spaghetti-computer/lasagna/README.md

# LASAGNA2354 (ラザニア2354)

> Project renamed from **NESPICO** to **ラザニア2354 / LASAGNA2354** (2026-10-13, working tree only). The Python package `nespico/`, the CLI, the GitHub repo name, firmware target names and older (Rev.A/B/bring-up) KiCad file names keep `nespico` / `NESPICO` for now, because renaming them would break imports, CI and existing artifacts.

A low-cost USB Famicom cartridge reader and **live-cartridge console** experiment.

The cartridge is not just a source for a ROM dump: the eventual console should drive the inserted physical cartridge's CPU and PPU buses while running the NES CPU/PPU/APU on an RP2350. The host PC or Mac handles display, audio playback, and controls.

## Project overview

```text
Physical Famicom 60-pin cartridge
               |
     74-series bus interface
     (latches / transceivers)
               |
      Raspberry Pi Pico 2 + PIO
               |
           USB Full Speed
               |
           PC / Mac host
   video, audio, controls, dumps
```

**Target hardware:** standard non-wireless Raspberry Pi Pico 2 (RP2350), 74-series logic, a real 60-pin cartridge connector and USB. The Pico 2 exposes 26 header GPIOs (GP0–GP22, GP26–GP28). For this design, GP26–GP28 are reserved for ADC0–ADC2 analog inputs; GP29 is ADC3 used by the board's VSYS monitor and is not a header GPIO. This leaves **23 digital GPIOs (GP0–GP22)**, so the earlier 27-GPIO concept must move at least four functions into external logic or be redesigned. No FPGA, HDMI shield or wireless module is planned. GPIO allocation and electrical protection are not finalized; see the [board architecture proposal](hardware/kicad/board-plan.md).

## Goals

1. **Play real cartridges.** Read PRG and CHR from the inserted cartridge during execution, support cartridge-side bank switching, CHR-RAM and mapper-generated IRQs instead of silently substituting a fully dumped ROM.
2. **Dump cartridges.** Read PRG-ROM and CHR-ROM to a host computer over USB, verify dumps, and support applicable mapper-controlled banks and cartridge save RAM.
3. **Reproduce physical-console behavior.** Keep motherboard RAM across RESET and cartridge replacement with power retained. Test tricks such as **Tennis → Super Mario Bros. World 9**. This is **not** a request for automatic hot-swap detection or live game switching; cartridge removal with power applied also needs electrical safety validation.
4. **Use the computer as the display.** Stream enough video/audio information over USB for a small PC/Mac viewer, and receive controller input from the host. USB Full Speed means raw full-frame 60fps video is not a feasible default protocol.
5. **Keep the hardware inexpensive and buildable in a quantity of two.** Prefer off-the-shelf Pico 2 boards, inexpensive standard logic and hand-assembled connectors to a custom MCU/FPGA board.

## Development approach

**Simulation first, hardware second.** The host-side simulator models approximate NTSC CPU/PPU bus demand, nominal 74-series/PIO transaction latency, overlapping requests, simplified MMC3 A12 qualification, RESET RAM retention and USB bandwidth assumptions. GitHub Actions runs the tests without any connected hardware.

The simulation is a *screening tool*, not proof that physical timing works. It does not execute actual PIO, emulate a complete 6502/PPU, validate the cartridge voltage interface, or establish real USB throughput. PPU events use classified 2-dot fetch slots from the documented rendering schedule, but do not include generated PPU addresses or rendering-state changes.

### Current status

- Host-side deterministic bus-timing simulator and 39 regression tests are present, including exhaustive five-step checks of the abstract shared-bus guard and PPU fetch-slot phase checks. The local suite and Pico SDK 2.3.1 firmware builds pass; invalid test GPIO maps are rejected before compilation. Both GitHub Actions workflows passed for commit `8f26041` on `work/rp2350-pio-bringup`.
- Firmware CI checks PIO instruction order, sample strobe side-set, loop width, and agreement between the calculated 99 instruction clocks and C constants. It builds a second test map using Pico 2 header GPIOs GP20–GP22 and GP26–GP28, and rejects duplicate, malformed, out-of-range, leading-zero, and board-reserved GPIO assignments. These are source/configuration checks, not hardware execution.
- A one-bit AHCT/LVC level-interface candidate schematic and a 35-case switch-level SPICE screen are now available under `hardware/`; the assumed cartridge release timing is not measured, so this is not electrical sign-off.
- GPIO pin map, 5V interface, physical timing, accurate NES emulator, cartridge swapping and USB video protocol remain to be validated.
- **No claim of working cartridge playback or real-device ROM dumping yet.**

### Local checks

```sh
python -m unittest discover -s tests -v
python -m nespico.cli --scanlines 262
python -m nespico.cli --sys-mhz 20 --settle-ns 160 --scanlines 1 # expected failure
python3 firmware/pio_bringup/validate_pio_source.py
```

## Development records

- [Development log (2026-10-12)](docs/journal/2026-10-12.md)
- [Development roadmap](docs/roadmap.md)
- [Simulation results](docs/benchmark-results.md)
- [PIO bring-up checkpoint](docs/pio-bringup.md)
- [Preliminary one-bit KiCad interface slice](hardware/kicad/README.md) and [Pico 2 board architecture proposal](hardware/kicad/board-plan.md)
- [Bus-turnaround SPICE screening model](hardware/spice/README.md)

## Milestones

1. CI timing simulator + executable design assumptions
2. PIO bus-pattern generator on Pico 2, measured with loopback and a logic analyzer
3. 74-series interface prototype: safe NROM PRG/CHR readback
4. USB dumper with validation and mapper-aware read/write
5. Real-cart CPU+PPU operation, host video/audio and input
6. RAM-preserving RESET, cartridge replacement tests and MMC1/MMC3

See [architecture notes](docs/architecture.md) and [simulation results](docs/benchmark-results.md). The extra pipeline tests model the CPU/PPU work required to prepare addresses; they show that nominal bus-only timing success is not sufficient.

The first Pico SDK / PIO firmware target is a **test-only dual-lane GPIO loopback** under `firmware/pio_bringup/`. It is intentionally not a cartridge bus driver; see its [build and safety instructions](firmware/pio_bringup/README.md). A board-specific pinout and real logic-analyzer measurements are still required before freezing a cartridge interface or releasing PCB files for fabrication.

Reference documentation: [NESdev cartridge connector](https://www.nesdev.org/wiki/Cartridge_connector), [PPU rendering](https://www.nesdev.org/wiki/PPU_rendering), [MMC3](https://www.nesdev.org/wiki/MMC3), [RP2350](https://www.raspberrypi.com/documentation/microcontrollers/silicon.html).
