spaghetti-computer/lasagna/hardware/kicad/revc_lite/README.md

# LASAGNA LITE (WeAct RP2350B), PRE-ROUTE proposal

> **Current configuration (2026-10-17, supersedes everything below).** The Waveshare Core2350B is replaced by the
> **WeAct Studio RP2350B Core Board V1.0** (41.148 x 41.402 mm, two 2x15 2.54 mm headers, rows 38.10 mm apart, own USB-C
> with CC resistors + TVS, BOOT/RST buttons, 16 MB flash). Board stays **100 x 67 mm**. Sections after this one are history
> (Waveshare era) and are kept for reference only. Regenerate with:
>
> `cd ../revc && LASAGNA_LITE=1 python3 gen_sch.py && LASAGNA_LITE=1 python3 gen_pcb.py && LASAGNA_LITE=1 python3 export_fab.py`

## Module (verified against WeActStudio.RP2350BCoreBoard HDK: RP2350B_SCH.pdf H1/H2, RP2350B_PINOUT.png, dimension drawing)
- Footprint `NESPICO_RevC:WeAct_RP2350B_CoreBoard` (generated by `gen_pcb.py` from `design.weact_pins()`): pad 1xx = H1 pin xx, 2xx = H2 pin xx.
  Origin = module centre, +y = USB-C edge. Pin 1/2 row 1.778 mm from the USB edge, far edge 4.064 mm past pin 29/30, rows 38.10 mm (outer) / 33.02 mm (inner) apart.
  The community footprints (fp_leomanes, fp_bwally0) were only used as a cross-check (leomanes agrees within 0.1 mm; bwally0 uses a different pad numbering).
- Placement: module centre (50.00, 46.30), x 29.43-70.57, y 25.60-67.00, **USB-C flush with the front edge**. H2 (GP25-47) on the left, H1 (GP0-24) on the right (top view).
- **H1:** 1 VBUS (raw USB), 2 +5V (after the module diode U2), 3/4 GND, 5 VREF, pin k = GP(k-6) for k = 6..30. Odd = outer row.
- **H2:** 1/2/4 GND, 3 3V3_EN, 5/6 3V3, 7 GP47, 8 RUN, 9 GP45, 10 GP46, 11 GP43, 12 GP44, ... 29 GP25, 30 GP26. Even = outer row.
- **Power:** +5V_LOGIC = **H1-1 VBUS** -> F1 PTC (JP2 bypass, open) -> VBUS_F -> JP1 bridged (D2 SS34 DNP) -> +5V_LOGIC.
  **H1-2 is NOT used**: the module diode drop could take the AHCT supply below 4.5 V. +3V3 = module LDO on H2-5/6.
  Not connected: H1-2 +5V, H1-5 VREF, H2-3 3V3_EN, H2-8 RUN.
- **Module handling (also on the front silk next to the module):**
  - **Lift module R16** (GP23 -> KEY button with a 5.1k pull-up to 3V3). GP23 carries OE#; with R16 fitted a KEY press would enable the AHCT outputs.
  - **Never fit the PSRAM/flash2 footprint U7** on the module bottom (its CS is GP0 = PPU AD0, through R14 0R with R13 10k to 3V3).
  - GP25 (CPU AD0, MCU side of RN1) drives the module LED through 5.1k: harmless (about 0.3 mA), the LED blinks with bus activity.
  - Newer WeAct lots ship RP2350B0**A4** (E9 fixed); R41 (5.1k CIRAM_A10 pull-down) stays fitted anyway (harmless on A4, required on A2).
- Solder the module on the supplied 2x15 male headers (do not fit pins pointing down on its 1x4 SWD header). Only bare THT test pads sit under the module.

## GPIO map (firmware swap, approved 2026-10-17)
| GPIO | Net | Function | Header pin |
|---|---|---|---|
| 0-7 | PADM0-7 | PPU AD0-7 (via RN3/RN4 33R) | H1-6..13 |
| 8-13 | GPA8-13 | PPU A8-13 -> U7 (GPA13 also U8) | H1-14..19 |
| 14 | PPU_DEN_N | U5 245 /OE (R32 10k to 3V3) | H1-20 |
| 15 | G_RD | -> U8 -> CART_RD_N | H1-21 |
| 16 | G_WR_N | U5 DIR, U7 -> CART_WR_N | H1-22 |
| 17 | PPU_ALE | U3 573 LE | H1-23 |
| 18 / 19 / 20 | CVBS_B0 / B1 / B2 | CVBS DAC R90 910 / R91 470 / R92 220 (DNP), 3V3-only | H1-24 / 25 / 26 |
| 21 | IRQ_N | cart pin 15 (R39 10k to 3V3), 5V-tolerant pin | H1-27 |
| 22 | CIRAM_CE_N | cart pin 48, 5V-tolerant pin | H1-28 |
| 23 | OUT_OE_N | OE# of all 7 AHCT (R30 10k to 3V3), 3V3-only. Module KEY pin: **lift R16** | H1-29 |
| 24 | CIRAM_A10 | cart pin 18, **R41 5.1k pull-down** (E9), 5V-tolerant pin | H1-30 |
| 25-32 | CADM0-7 | CPU AD0-7 (via RN1/RN2 33R) | H2-29,30,27,28,25,26,23,24 |
| 33-39 | GA8-14 | CPU A8-14 -> U6 | H2-21,22,19,20,17,18,15 |
| 40 | G_RW | U4 DIR, U6 -> CART_RW | H2-16 |
| 41 | G_ROMSEL_N | U7 -> CART_ROMSEL_N | H2-13 |
| 42 | G_M2_N | U4 /OE, U8 -> M2 (R31 10k to 3V3) | H2-14 |
| 43 | CPU_ALE | U2 573 LE | H2-11 |
| 44 / 45 | I2C_SDA / I2C_SCL | U10 MCP23017, J9 Grove (DNP), 4.7k to 3V3 | H2-12 / H2-9 |
| 46 | SPARE_GP46 | audio PWM (R60, DNP), J10 EXP, TP G46 | H2-10 |
| 47 | SPARE_GP47 | J10 EXP, TP G47 | H2-7 |

- **PIO window rule:** the PPU group (GP0-17) sits inside GPIO0-31 and the CPU group (GP25-43) inside GPIO16-47 (tested).
- **GPIO40-47 rule:** these are the ADC pads and are **not 5 V tolerant**. Every net on GPIO40-47 may only reach an AHCT input
  (573 LE/D, 541/540 A/OE, 245 DIR/OE) or a 3.3 V-only part (MCP23017, Grove, EXP header, 3V3 pull-ups). Never a 245 A/B pin, the cart slot,
  or a pull-up to +5V. `tests/test_lite.py::test_gpio40_47_only_drive_ahct_inputs_or_3v3_parts` enforces it with **zero exceptions**.
  R63 (GPIO46 -> cart pin 45) was deleted 2026-10-17; cart pin 45 (audio from 2A03) is NC again, pin 31 NC (pin 30 = +5V).
  R62 (cart pin 46 -> audio filter, DNP) stays: it only feeds the RC node, never a GPIO directly.
- Firmware order unchanged: set 245 DIR (G_RW / G_WR_N) and the bus levels, then pull the 245 /OE (G_M2_N / PPU_DEN_N) and OE# (GPIO23) low;
  release OE before changing DIR.
- **Lite pin swaps (firmware-invisible):** U2/U3 573 latches carry bit 7-j on D/Q pair j, and each RN 33R array carries bit b0+3-e on element e,
  so the module -> RN -> 573/245 -> slot buses run without crossings.

## Parts changed vs the Waveshare Lite
- **Removed:** J1 Akizuki USB-C breakout, R5/R6 CC 5.1k, U12 USBLC6-2SC6 (the module has USB-C, CC and TVS), SW1/SW2 (module has BOOT/RST),
  TP SWC/SWD/BT/RUN, the "DO NOT USE MODULE FPC" silk. The 22nd TP is GND again.
- **Changed:** U1 = WeAct RP2350B (60 pins, new symbol/footprint, courtyard 41.65 x 41.65 mm, silk on 3 sides, fab marks for the RP2350B, PSRAM U7, SWD 1x4 and USB-C shell legs).
  F1 now fed from H1-1 VBUS. GPIO map as above. R41 moved with CIRAM_A10 (GP24).
- **Kept:** F1 PTC (fitted) + JP2 (open), D2 SS34 DNP + JP1 bridged, R30/R31/R32/R39 pull-ups to 3V3, R41 5.1k fitted, all DNP options
  (MCP23017 + J4/J5, Grove J9 Seeed order, CVBS + J6, audio chain + J11, J10 EXP).

## Placement (mm, board origin top-left, y down; all key parts locked)
| Part | Position | Note |
|---|---|---|
| J3 cart slot | pin 1 (13.17, 7.80) | top edge, CPU pins left, PPU right |
| Row A, y = 18.0, 13 mm pitch | U6 11.0 (90), U2 24.0 (90), U4 37.0 (270), U8 50.0 (90), U7 63.0 (90), U3 76.0 (90), U5 89.0 (270) | inputs face the module, outputs face the slot (245 A side up) |
| 100 nF | C14 (8.08,12.54) C10 (21.08,12.54) C12 (39.93,23.46) C16 (47.07,12.54) C15 (60.07,12.54) C11 (73.07,12.54) C13 (91.93,23.46) | 2.6 mm from each VCC pin 20 |
| Pull-ups in row-A gaps | R31 (42.3,18) R30 (44.7,18) R39 (55.3,18) R41 (57.7,18) R32 (69.5,18) | on G_M2_N / OE# / IRQ / A10 / DEN |
| U1 WeAct | centre (50.00, 46.30) | USB-C flush with y = 67 |
| RN1 / RN2 | (26.4, 31.0) / (26.4, 36.0), 180 deg | left of H2 GP25-32 |
| RN3 / RN4 | (73.6, 57.1) / (73.6, 52.5), 0 deg | right of H1 GP0-7 |
| F1 / JP2 / D2 / JP1 / C1 | (74.6,64.8) / (74.6,61.6) / (80.6,64.8) / (80.6,61.6) / (86.0,64.8) | next to H1-1 VBUS, two aligned columns + C1 on the same row |
| TP1-22 | 3 rows (y 27.0 / 30.9 / 34.8) x 8, 3.2 mm pitch, centred x = 48.5 | bare THT pads under the module's far end, labels on B.Silk |
| CVBS / audio passives | R90/R91/R92 (80.4/82.0/84.0, 35.0); R60/C60/C61 (same x, 45.0); R61/R62 (80.4/82.0, 50.0) | one column grid per RCA |
| Options | J6 (93.1,33) J11 (93.1,49) right edge; J9 (6,52) U10 (16.6,51.4) J10 (24.6,46.4) J12 RST (24.6,40.0) J5 (11.9,60.9) J4 (11.9,64.8) left | all DNP |

Routing intent for Quilter: CPU signals leave H2 to the left (CAD via RN1/RN2 straight up to U2/U4, GA8-14/G_RW left then up to U6);
G_ROMSEL_N / G_M2_N / CPU_ALE and the PPU A8-13 / WR / RD lines may use the lanes under the module beside the TP block; PAD via RN3/RN4 up the
right side to U3/U5; IRQ/CIRAM lines from the top of H1 straight up to the slot centre. Nothing but flat test pads sits under the module.

## Cost change vs the Waveshare Lite (estimate, 1 USD = 150 JPY)
- Module: WeAct RP2350B about $4.2 + shipping (AliExpress; includes 2x 30-pin and SWD headers) vs Core2350B ¥1,463 (Switch Science kit) / $4.9-7.99: about -¥0 to -¥800.
- Removed: Akizuki J1 breakout -¥180, U12 USBLC6 MOQ 10 -¥72, Akizuki 1x40 header strips -¥70 (headers come with the module). R5/R6 were the same 5.1k line as R41 (no saving).
- **Net: about -¥320 on parts, up to about -¥1,100 including the module.** PCB price unchanged (same 100 x 67 mm, 2 layers).

## Population: Lite build vs Full build
The minimal build is a fully working dump-only Lite: every option footprint may stay empty (tested in `LitePopulationTest`:
no logic-IC pin floats without the options, +5V reaches the logic through F1 + bridged JP1).

| Function | Lite build (fit) | Full build (additionally fit) |
|---|---|---|
| MCU | U1 WeAct RP2350B (R16 lifted, no PSRAM) | same |
| Power | F1 PTC, JP1 bridged, C1, JP2 open | D2 SS34 (then cut JP1) only if back-feed protection wanted |
| Cart bus | J3 slot, U2/U3 573, U4/U5 245, U6/U7 541, U8 540, C10-C16, RN1-RN4 33R | same |
| Pulls | R30, R31, R32, R39 (3V3), R41 5.1k (E9) | same |
| Controller pads | - | U10 MCP23017, C27, R51-R53, R42/R43, J4 PAD1, J5 PAD2 |
| Grove I2C | - | J9 (shares U10's I2C, GP44/45) |
| Video | - | R90-R92 DAC, J6 RCA (GP18-20) |
| Audio | - | R60, C60, C61, R61, J11 RCA (GP46 PWM); R62 to mix cart audio (pin 46) |
| Expansion | - | J10 EXP (3V3, GP46, GP47, GND, 5V) |
| Reset/boot | module RST/BOOT buttons | J12 RST header (RUN to GND) for a case button |
| Test | TP1-22 (bare pads) | same |

Rev.C features without a footprint now: USB-C/CC/ESD, SW1/SW2 buttons and SWD header (all on the module: its USB-C, RST/BOOT
buttons and SWD 1x4), crystal and flash (on the module). Nothing else is missing; J12 was added (DNP) for an external reset.

## Checks (2026-10-17)
- `python3 -m pytest tests`: 81 passed (incl. golden netlist, ERC, GPIO40-47 rule with zero exceptions, PIO windows, population test, H1-2 / 3V3_EN unused, 3V3 pull-ups).
- ERC 0 errors / 0 warnings. DRC with schematic parity: 0 violations, 0 footprint errors, 283 unconnected (unrouted, expected).
- Fitted JLC BOM: 10 lines, 25 SMD placements (U1/J3 and DNP options hand-assembled).

---

# History (Waveshare Core2350B era, superseded)

> **Current configuration (2026-10-13 21:50, supersedes older notes below):** bare Core2350B0 (no kit/FPC adapter needed);
> USB-C = Akizuki 115426 breakout J1 + R5/R6 5.1k; VBUS = +5V_LOGIC = module VBUS = cart 5V (no PTC, no ESD, no cart power switch);
> 33R = RN1-RN4 (C25508); pulls R30 OE#, R31 G_M2_N, R32 PPU_DEN_N, R39 IRQ_N all to **3V3**; R41 **5.1k fitted** (E9: Waveshare photo shows RP2350B0A2).
> VBUS: J1 pin1 (VBUS_IN) -> **D2 SS34** (C8678, Basic) -> +5V_LOGIC; **JP1** normally-open solder jumper 'SHORT=BYPASS D' across D2.
> Board **100 x 67 mm** (DNP option row added). Full-version features are DNP footprints (table at the end). Do **not** connect the module FPC while J1 is used (both feed VBUS). Unplug USB before swapping carts.
> Firmware order: set 245 DIR (G_RW / G_WR_N) and the address/data levels first, then pull the 245 OE (G_M2_N / PPU_DEN_N) and OE# (GPIO43) low;
> release OE before changing DIR. Never drive GPIO39 (CIRAM_CE_N). Sections below are history.

This is the Rev.C cart circuit with the bare RP2354B and its support parts replaced by a **Waveshare Core2350B** module (RP2350B, 16 MB flash, 12 MHz crystal, ME6217 3.3 V/800 mA LDO, 27 Ω USB resistors on the module).
It is generated from `../revc/*.py` with `LASAGNA_LITE=1`; Rev.C itself is not changed:

```
cd ../revc && LASAGNA_LITE=1 python3 gen_sch.py && LASAGNA_LITE=1 python3 gen_pcb.py && LASAGNA_LITE=1 python3 export_fab.py
```

Board: 100 × 62 mm (same as Rev.C), 2 layers, black mask, M3 holes at the corners. It is within JLC's ≤100×100 mm cheapest price tier, so making it smaller would not lower the price.
Assembly is all hand-soldered by default (TSSOP-20, 0603/0805, SOT-23). PCBA is not required.

## Module (verified against the Waveshare sources)
- **Outline:** Core2350B0 wiki size drawing. 25.40 mm square, 64 THT pads on a 10×10 grid at 2.54 mm pitch, two pads deep around the edge (pad grid span 22.86 mm).
- **Pinout:** `Core2350B.pdf`, P1–P4 "Header 8X2".
  - P1 (left): GPIO0–14
  - P3 (bottom): GPIO15–29
  - P4 (right): GPIO30–44
  - P2 (top): 1 GND, 2 GP45, 3 GP47 (through R11 0R), 4 GP46, 5 BOOTSEL, 6 SWD, 7 USBD_N, 8 GND, 9 USBD_P, 10 SWCLK, 11 RUN, 12 ADC_VREF, 13 3V3_EN, 14 GND, 15 VBUS, 16 3V3
  - Footprint pad number = header × 100 + pin.
- **Mounting:** solder the module to male 2.54 mm headers (Akizuki 1×40 strips cut to length), or solder it flat.

## What changed from Rev.C
- **Removed:**
  - U1 and its support: L1, Y1, C5–C9, R1, R2, the C17–C24 / C28–C32 decoupling, R3, R4, R7, R8.
  - U9 NCP1117 and C2. The module LDO supplies +3V3, and the load is well under the LDO's rating (the AHCT logic runs from 5 V).
  - D1 and its 1k (the module LED is enough), the CVBS DAC/RCA, MCP23017/Grove/pad headers, and the J7 SWD header (SWCLK/SWDIO are on the test-point row instead).
- **USB-C:** CC 5.1k ×2, then F1 → +5V_LOGIC → module VBUS (P2-15). D+/D− go straight to P2-9/P2-7, because the 27 Ω resistors are on the module.
- **Kept:** U11 power-down guard, on the module's 3V3.
- **SW1/SW2:** **optional**. A blank flash enumerates as USB BOOTSEL by itself; the module has no buttons of its own.
- **GPIO map unchanged** (same firmware as Rev.C).
  - GPIO39 (module red LED, 470 Ω) is CIRAM_CE_N, an input that the cart drives. The LED loads it by about 7 mA. **Firmware must never drive GPIO39.** **Remove the module's R10 (recommended)**: CIRAM /CE is often PPU /A13 driven by U8 or the cart, and the LED would load it.
  - GPIO40–42/44/45 (unused CVBS/I2C) and **GPIO47 are not connected**, so the B1/B2 variants (with PSRAM) also work. B0 is recommended.
- **Clock:** the module is rated for 150 MHz. The 172 MHz overclock is the same silicon, but it is unverified on the module.

## Cost (1 board, cheapest; 1 USD = 150 JPY)
| Item | Cost | Source |
|---|---|---|
| PCB, 5 boards | $2–4 (¥300–600) | estimate |
| Shipping, PCB + LCSC parts together, cheapest service | $8–15 (¥1,200–2,250) | estimate |
| Parts (LCSC/JLC unit prices incl. LCSC minimum order quantities) | about $11.1 (¥1,670), of which ICs $4.44 | JLC API prices from 2026-10-13 |
| Core2350B module | ¥1,463 (Switch Science B2-Kit) / $4.9 (SpotPear B0, plus shipping) / $7.99 (Waveshare) | fetched |
| Pin headers, 1×40 ×2 (Akizuki 100167) | ¥70 | fetched |
| J3 Hirose slot | ¥0 (already owned) | |
| Consumption tax | ¥0 (personal-import taxable base under ¥10,000) | estimate |
| **Total** | **about ¥4,700–6,300** | |

Optional:
- SW1/SW2 TS-1187A: about ¥15 including MOQ.
- JLC Basic PCBA (16 lines): about +$12 (setup $8, stencil $1.5, parts).

The leftover MOQ parts (5–100 pcs per line) cover 2 or more more boards. With a second module and a second slot, an extra board costs about ¥2,000–3,500.

## Cost-down (2026-10-13, target <= 3000 JPY all-in)
Removed vs the first Lite: USB-C J1 + CC 5.1k R5/R6, PTC F1, RUN/BOOT SW1/SW2 (all on the Core2350B-Kit USB adapter via FFC),
cart supervisor U11 + Q1/Q2/Q3 high-side switch + R44-R47/C4/C25 (cart 5V = USB 5V directly: **insert/remove carts with USB unplugged**),
C3/C26 bulk, cart-side pulls R33-R38/R40/R41/R48/R49. OE# (OUT_OE_N) is driven by GPIO43 directly, R30 10k pull-up to 3V3
(AHCT VIH 2.0 V) keeps all buffers Hi-Z through reset. Remaining: module, J3 (owned), 7 logic ICs, 16x33R, 4x10k, 1x10uF, 7x100nF, 64 header pins.
Cheapest-MOQ IC choice: 74HCT245PW C52140501 and SN74HCT541PWR C436096 (min 1) instead of the min-5 AHCT lines.

## USB-C back on the board (2026-10-13 21:20)
J1 = Akizuki 115426 AE-USB2.0-TYPE-C-5077CR (180 JPY) USB-C DIP breakout on a 1x7 2.54 mm header, mouth flush with the left edge.
Pins (Akizuki schematic): 1 VBUS, 2 D-, 3 D+, 4 GND, 5 CC1, 6 CC2, 7 GND; the breakout has no CC resistors, so R5/R6 5.1k are on the Lite.
VBUS = +5V_LOGIC = module VBUS (P2-15) = cart 5V (no PTC). D-/D+ -> module P2-7/P2-9. Module FPC / kit adapter not needed (bare Core2350B0 OK).
BOOTSEL and RUN are test pads TP "BT" / "RUN" (module P2-5 / P2-11): short to GND with tweezers. Footprint from Akizuki AE-USB2.0-TYPE-C-5077CR_rev1.pdf
(20 x 15 mm, pin1 2.381 mm from edge, row 1.905 mm from rear edge); check the pin-1 side on the real board before soldering.

## 33R arrays + E9 pulls (2026-10-13 21:30)
- R10-R17/R20-R27 (16x 33R 0603) -> RN1-RN4 = UniOhm 4D03WGJ0330T5E, 33R x4 0603 convex (LCSC C25508, Extended, stock ~110k, MOQ 50, $0.013).
  RN1 = CPU AD0-3, RN2 = CPU AD4-7, RN3 = PPU AD0-3, RN4 = PPU AD4-7; pins 1-4 MCU side, 8-5 buffer side.
- **A4 stepping assumed; populate if using A2.** Core2350B ships RP2350 A4 (erratum E9 fixed), so R41 (CIRAM_A10 pull-down, E9-only) is DNP
  (footprint kept, excluded from JLC BOM/CPL). Kept fitted: R30 OE# pull-up to 3V3 (buffers Hi-Z through reset), R31/R32 (U4/U5 245 disabled at reset),
  R39 IRQ_N pull-up (cart IRQ is open-drain).

## Polish pass before Quilter (2026-10-13 21:45)
- Board 100 x 60 mm (was 100 x 62): width is set by the 84.8 mm CR22A slot body + M3 corners; module 0.5 mm up, TP row 55.2 mm.
- No fiducials (hand-built). Black mask / white silk, R3 rounded corners, 4x M3 plated holes, slot centred on the top edge.
- J1 USB-C breakout on the left edge (mouth flush), R5/R6 CC 5.1k right behind CC1/CC2, C1 10uF next to VBUS.
- RN1/RN2 (CPU AD) and RN3/RN4 (PPU AD) in one row between the 245s and the module; 100nF next to each IC VCC pin (row A).
- Pulls in a 3 mm-pitch row beside the module (R30/R31/R41 left, R32/R39 right). Front "CORE2350B" label removed (quiet silk); all text >= 1.0 mm.
- 24 THT test points evenly on the back front edge, 3.5 mm pitch, back labels (incl. BT/RUN for BOOTSEL/RESET).

## VBUS series Schottky D2 + bypass JP1 (2026-10-13 22:00)
- D2 = MDD SS34 (LCSC C8678, JLC Basic, SMA, $0.035, MOQ 20 = $0.70, about 105 JPY). A = VBUS_IN (J1 pin 1), K = +5V_LOGIC.
- JP1 = 2-pad solder jumper, open by default; short it to bypass D2 (production may fit a 0R/jumper instead).
- Drop: SS34 VF is typically ~0.3 V at 0.1-0.2 A (datasheet max 0.5 V at 3 A). Load = module (~30 mA) + 7 AHCT (quiescent) + cart (50-150 mA), ~0.2 A max.
  - Host 5.0 V: rail ~4.7 V. AHCT VCC 4.5-5.5 V OK; ME6217 3.3 V LDO (dropout ~0.1 V at 0.1 A) OK.
  - Host at the USB minimum 4.75 V (or a long cable): rail ~4.4 V, **below AHCT 4.5 V**. Short JP1 if the 5V TP reads < 4.5 V.
- Protects: 5 V on +5V_LOGIC (e.g. module FPC/adapter VBUS, which is the same net as module VBUS) cannot backfeed the J1 host.
  It does NOT stop J1 from feeding the FPC side; that would need a second diode on the module's FPC VBUS, which is on the module. So still: do not use the FPC.

## Full-version features as DNP footprints (2026-10-14 03:40)
Fitted BOM unchanged (DNP parts are excluded from the JLC BOM/CPL; BOM_FULL lists them as "(DNP)"). Board 100 x 60 -> **100 x 67 mm** for the front option row.

| Feature | Parts to add | Enables |
|---|---|---|
| Controller pads | U10 MCP23017-E/SS, C27 100nF, R51 10k (RST), R52/R53 4.7k (I2C), R42/R43 10k, J4/J5 1x7 headers | 2 pads via I2C 0x20 (GPA0 CLK, GPA1 LATCH, GPA2/3 data), 3.3 V |
| Grove I2C | J9 HY2.0-4P (+ R52/R53 if U10 not fitted), left edge under J1 | 3.3 V I2C on GPIO44 SDA / GPIO45 SCL. **Seeed pin order: 1 SCL, 2 SDA, 3 VCC (3V3), 4 GND** (silk SCL/SDA/3V3/GND) |
| CVBS video | R90 910, R91 470, R92 220, J6 RCA MJ-526-Y (Akizuki 112477) | 3-bit composite out from GPIO40-42 |
| Audio out | R60 1k (C21190), C60 10nF (C57112), C61 10uF 0805 (C15850), R61 10k (C25804), J11 RCA MJ-526-Y (Akizuki 112477); optional cart mix: R62 1k (C21190), R63 10k (C25804) | PWM audio on GPIO46 (RC low-pass 15.9 kHz, DC-blocked, 10k bleed) to J11 "AUDIO". R62 mixes cart pin 46 (audio from cart), R63 feeds GPIO46 PWM to cart pin 45 (audio into cart) for expansion-audio carts |
| RUN / BOOTSEL buttons | SW1, SW2 TS-1187A | reset / USB boot without tweezers on TP RUN/BT |
| PTC on VBUS | **FITTED** F1 TECHFUSE SMD0805-050 (C66452); JP2 open = optional bypass | over-current fuse (hold 0.5 A / trip 1 A) |
| USB ESD | **FITTED** U12 UMW USBLC6-2SC6 (C2687116; no Basic USBLC6 exists) | D+/D- ESD clamp |
| Expansion | J10 1x5 header: 3V3, GPIO46, GPIO47, GND, 5V | 2 spare GPIO (GPIO47 only on B0: PSRAM CS on B1/B2). 3.3 V ADC pins, not 5 V tolerant |

GPIO map (module): 0-7 CPU AD, 8-14 CPU A8-14, 15 R/W, 16 /ROMSEL, 17 /M2 (245 OE), 18 CPU ALE, 19-26 PPU AD, 27-32 PPU A8-13,
33 PPU DEN, 34 /RD, 35 /WR, 36 PPU ALE, 37 IRQ, 38 CIRAM A10, 39 CIRAM /CE (module LED!), 40-42 CVBS DAC, 43 OE#, 44 SDA, 45 SCL, 46/47 spare (J10, TP G46/G47).
VBUS chain: J1 -> [F1 PTC || JP2 open] -> VBUS_F -> [JP1 bridged (default) || D2 SS34 DNP] -> +5V_LOGIC.

## F1 PTC + U12 ESD fitted (2026-10-14 07:30)
F1 C66452 (MOQ 10, $0.37 = 55 JPY) + U12 C2687116 (MOQ 10, $0.48 = 72 JPY): **+127 JPY**. JP2 is now normally open (short = bypass F1).
Drop: F1 150 mOhm min x 0.2 A = 0.03 V (up to ~0.17 V near the 850 mOhm max) + D2 ~0.3 V: rail ~4.55-4.7 V from a 5.0 V port.
If the 5V TP reads < 4.5 V, short JP1 (D2 bypass) first.

## D2 DNP, JP1 bridged (2026-10-14 07:35)
VBUS is direct through F1 only: drop = F1 0.03-0.17 V at 0.2 A, so **~4.6 V or more at a 4.75 V USB port** (~4.85 V at 5.0 V); AHCT 4.5-5.5 V OK.
No FPC-backfeed protection by default: front silk "DO NOT USE MODULE FPC" (vertical, right of the module, from the FPC/P2 top side). If you want it, fit D2 (SS34, C8678) **and cut JP1**
(then the rail drops ~0.3 V more). Fitted-BOM delta: -105 JPY (SS34 MOQ 20 no longer bought).

## R41 fitted for RP2350-E9 (2026-10-14 07:40)
Waveshare's Core2350B0 size drawing photo shows the chip marked **RP2350B0A2**, so E9 must be assumed.
Datasheet D.5.1 RP2350-E9 (Affects RP2350 A2): "Driving / pulling the pad input low with a low impedance source of 8.2 kOhm or less will
overcome the erroneous leakage ... The pad pull-up still works." -> R41 = **5.1k** pull-down on CIRAM_A10 (GPIO38), same part as R5/R6 (C23186): cost 0.
Driver: cart pin 18 (CIRAM A10 = PPU A10/A11 via cart wiring from our U7/U3 AHCT outputs, or the mapper output): 5 V / 5.1k = ~1 mA, well within AHCT 8 mA.
Other pulls are pull-ups (unaffected by E9); no other GPIO input relies on a pull-down. Firmware: never rely on internal pull-downs.

## Option row centred + rename (2026-10-14 08:10)
Product name on silk / title block / schematic: **LASAGNA LITE** (file names stay LASAGNA2354_Lite.* for tooling). MADE IN KOBE kept.
Front option row at y=58.5, symmetric about x=50 on the 2.54 grid, 2.0 mm courtyard gaps:
J4 PAD1 pin1 x=14.44 (pins 14.44-29.68), SW1 RUN x=37.30, J10 EXP pins 44.92-55.08, SW2 BOOT x=62.70, J5 PAD2 pin1 x=70.32 (pins 70.32-85.56).

## Grove Seeed order + DNP audio out (2026-10-14 09:00)
- **J9 Grove** now follows the Seeed standard: 1 SCL (GPIO45), 2 SDA (GPIO44), 3 VCC 3V3, 4 GND (was 1 GND, 2 VCC, 3 SDA, 4 SCL). Moved to the left edge under J1 at (6.5, 52.0, 270), mouth flush, pin names on silk. F1/JP2 moved to (22.1, 47.2)/(22.1, 50.6) to make room.
- **Audio (all DNP, board works unpopulated):** GPIO46 -> R60 1k -> AUD_F -> C60 10nF to GND (fc = 1/(2*pi*1k*10nF) = 15.9 kHz) -> C61 10uF -> AUD_OUT -> J11 RCA, R61 10k bleed to GND.
  GPIO46 also stays on J10 pin 2 and TP G46. GPIO47 is not used (PSRAM CS on B1/B2).
- **Cart expansion audio** (NESdev cartridge connector, 60-pin Famicom): pin 45 = "Audio from 2A03" (console -> cart), pin 46 = "Audio to RF" (cart -> console).
  R63 10k: GPIO46 -> cart pin 45 (limits any 5 V backdrive to < 0.2 mA); R62 1k: cart pin 46 -> AUD_F (mixes cart audio into the filter node). Fit both to hear expansion audio (VRC6/N163/FDS-style carts); most carts simply tie 45 to 46.
- Placement: J11 at (93.1, 46.6, 90) stacked under J6 on the right edge, labelled AUDIO (J6 now labelled VIDEO). One 2.0 mm-pitch passive row at y=36 between the RN row and U10:
  R60 66.5, C60 68.5, C61 71.0, R61 73.5, R62 75.5, R63 77.5 | R90 80.0, R91 82.0, R92 84.0 (DAC moved up from y=40.5). U10 x 80 -> 79.
- Bottom option row (y=58.5) and the 100 x 67 mm outline are unchanged. Fitted JLC BOM unchanged (only F1's CPL position moved).
