spaghetti-computer/lasagna/hardware/kicad/revc/fab/LASAGNA2354_RevC_BOM_JLCPCB_PRE-ROUTE.csv

Comment | Designator | Footprint | LCSC Part #
10uF | C1,C2,C3 | C_0805_2012Metric | C15850
100nF | C10,C11,C12,C13,C14,C15,C16,C17,C18,C19,C20,C21,C22,C23,C24,C25,C26,C27,C28,C31,C32,C4 | C_0603_1608Metric | C14663
100nF | C29 | RPi_C_1005_wide | C1525
4.7uF | C30,C5,C6,C7 | RPi_C_1005_wide | C23733
15pF | C8,C9 | RPi_C_1005_wide | C1548
CART_ON | D1 | LED_0603_1608Metric | C2286
500mA_PTC | F1 | Fuse_1206_3216Metric | C46641012
USB-C | J1 | USB_C_Receptacle_HRO_TYPE-C-31-M-12 | C165948
HY2.0-4P | J9 | JST_PH_S4B-PH-SM4-TB_1x04-1MP_P2.00mm_Horizontal | C722729
AO3401A | Q1 | SOT-23 | C15127
2N7002 | Q2,Q3 | SOT-23 | C8545
33 | R1 | RPi_R_1005 | C25105
33 | R10,R11,R12,R13,R14,R15,R16,R17,R20,R21,R22,R23,R24,R25,R26,R27 | R_0603_1608Metric | C23140
1k | R2 | RPi_R_1005 | C11702
10k | R3,R30,R31,R32,R33,R34,R35,R36,R37,R38,R39,R40,R41,R42,R43,R44,R45,R48,R49,R51 | R_0603_1608Metric | C25804
1k | R4,R46,R47,R50 | R_0603_1608Metric | C21190
5.1k | R5,R6 | R_0603_1608Metric | C23186
4.7k | R52,R53 | R_0603_1608Metric | C23162
27 | R7,R8 | RPi_R_1005 | C25100
910 | R90 | R_0603_1608Metric | C23264
470 | R91 | R_0603_1608Metric | C23179
220 | R92 | R_0603_1608Metric | C22962
RUN | SW1 | SW_Push_1P1T_XKB_TS-1187A | C318884
BOOTSEL | SW2 | SW_Push_1P1T_XKB_TS-1187A | C318884
RP2354B | U1 | QFN-80-1EP_10x10mm_P0.4mm_EP3.4x3.4mm | C39843328
MCP23017-E/SS | U10 | SSOP-28_5.3x10.2mm_P0.65mm | C506653
XC61CN3002MR-G | U11 | SOT-23 | C2456348
SN74AHCT573PWR | U2,U3 | TSSOP-20_4.4x6.5mm_P0.65mm | C141311
74AHCT245PW | U4,U5 | TSSOP-20_4.4x6.5mm_P0.65mm | C173388
74AHCT541PW | U6,U7 | TSSOP-20_4.4x6.5mm_P0.65mm | C84548
SN74AHCT540PWR | U8 | TSSOP-20_4.4x6.5mm_P0.65mm | C7626
NCP1117ST33T3G | U9 | SOT-223-3_TabPin2 | C26537
12MHz | Y1 | RPi_XTAL_3225-4 | C20625731
