spaghetti-computer/lasagna/hardware/kicad/revc_lite/fab/LASAGNA2354_Lite_BOM_FULL.csv

Qty | Value | Designator | Footprint | LCSC | MPN
1 | WeAct RP2350B | U1 | WeAct_RP2350B_CoreBoard |  | WeAct RP2350B Core Board V1.0
1 | Famicom_60pin_slot | J3 | Hirose_CR22A-60D-2.54DS |  | CR22A-60D-2.54DS(70)
2 | SN74AHCT573PWR | U2,U3 | TSSOP-20_4.4x6.5mm_P0.65mm | C141311 | SN74AHCT573PWR
2 | 74AHCT245PW | U4,U5 | TSSOP-20_4.4x6.5mm_P0.65mm | C173388 | 74AHCT245PW,118
2 | 74AHCT541PW | U6,U7 | TSSOP-20_4.4x6.5mm_P0.65mm | C84548 | 74AHCT541PW,118
1 | SN74AHCT540PWR | U8 | TSSOP-20_4.4x6.5mm_P0.65mm | C7626 | SN74AHCT540PWR
4 | 10k | R30,R31,R32,R39 | R_0603_1608Metric | C25804 | 10k
4 | 10k (DNP) | R42,R43,R51,R61 | R_0603_1608Metric | C25804 | 10k
1 | PTC 0805 500mA | F1 | Fuse_0805_2012Metric | C66452 | SMD0805-050
1 | 10uF | C1 | C_0805_2012Metric | C15850 | 10uF
1 | 910 (DNP) | R90 | R_0603_1608Metric | C23264 | 910
1 | 470 (DNP) | R91 | R_0603_1608Metric | C23179 | 470
1 | 220 (DNP) | R92 | R_0603_1608Metric | C22962 | 220
1 | RCA_CVBS (DNP) | J6 | RCA_Avvicon_MJ-526 |  | MJ-526-Y
1 | PAD_J4 (DNP) | J4 | PinHeader_1x07_P2.54mm_Vertical
1 | PAD_J5 (DNP) | J5 | PinHeader_1x07_P2.54mm_Vertical
1 | MCP23017-E/SS (DNP) | U10 | SSOP-28_5.3x10.2mm_P0.65mm | C506653 | MCP23017-E/SS
2 | 4.7k (DNP) | R52,R53 | R_0603_1608Metric | C23162 | 4.7k
1 | HY2.0-4P (DNP) | J9 | JST_PH_S4B-PH-SM4-TB_1x04-1MP_P2.00mm_Horizontal | C722729 | HY2.0-4P-WT
7 | 100nF | C10,C11,C12,C13,C14,C15,C16 | C_0603_1608Metric | C14663 | 100nF
1 | 100nF (DNP) | C27 | C_0603_1608Metric | C14663 | 100nF
1 | SS34 (DNP) | D2 | D_SMA | C8678 | SS34
1 | CUT=USE D | JP1 | SolderJumper-2_P1.3mm_Bridged_RoundedPad1.0x1.5mm
1 | SHORT=BYPASS F | JP2 | SolderJumper-2_P1.3mm_Open_RoundedPad1.0x1.5mm
1 | EXP (DNP) | J10 | PinHeader_1x05_P2.54mm_Vertical
1 | RST (DNP) | J12 | PinHeader_1x02_P2.54mm_Vertical
2 | 1k (DNP) | R60,R62 | R_0603_1608Metric | C21190 | 1k
1 | 10nF (DNP) | C60 | C_0603_1608Metric | C57112 | 10nF
1 | 10uF (DNP) | C61 | C_0805_2012Metric | C15850 | 10uF
1 | RCA_AUDIO (DNP) | J11 | RCA_Avvicon_MJ-526 |  | MJ-526-Y
4 | 33x4 | RN1,RN2,RN3,RN4 | R_Array_Convex_4x0603 | C25508 | 4D03WGJ0330T5E
1 | 5.1k | R41 | R_0603_1608Metric | C23186 | 5.1k
