spaghetti-computer/lasagna/hardware/kicad/revb/fab/NESPICO_RevB_schematic.pdf

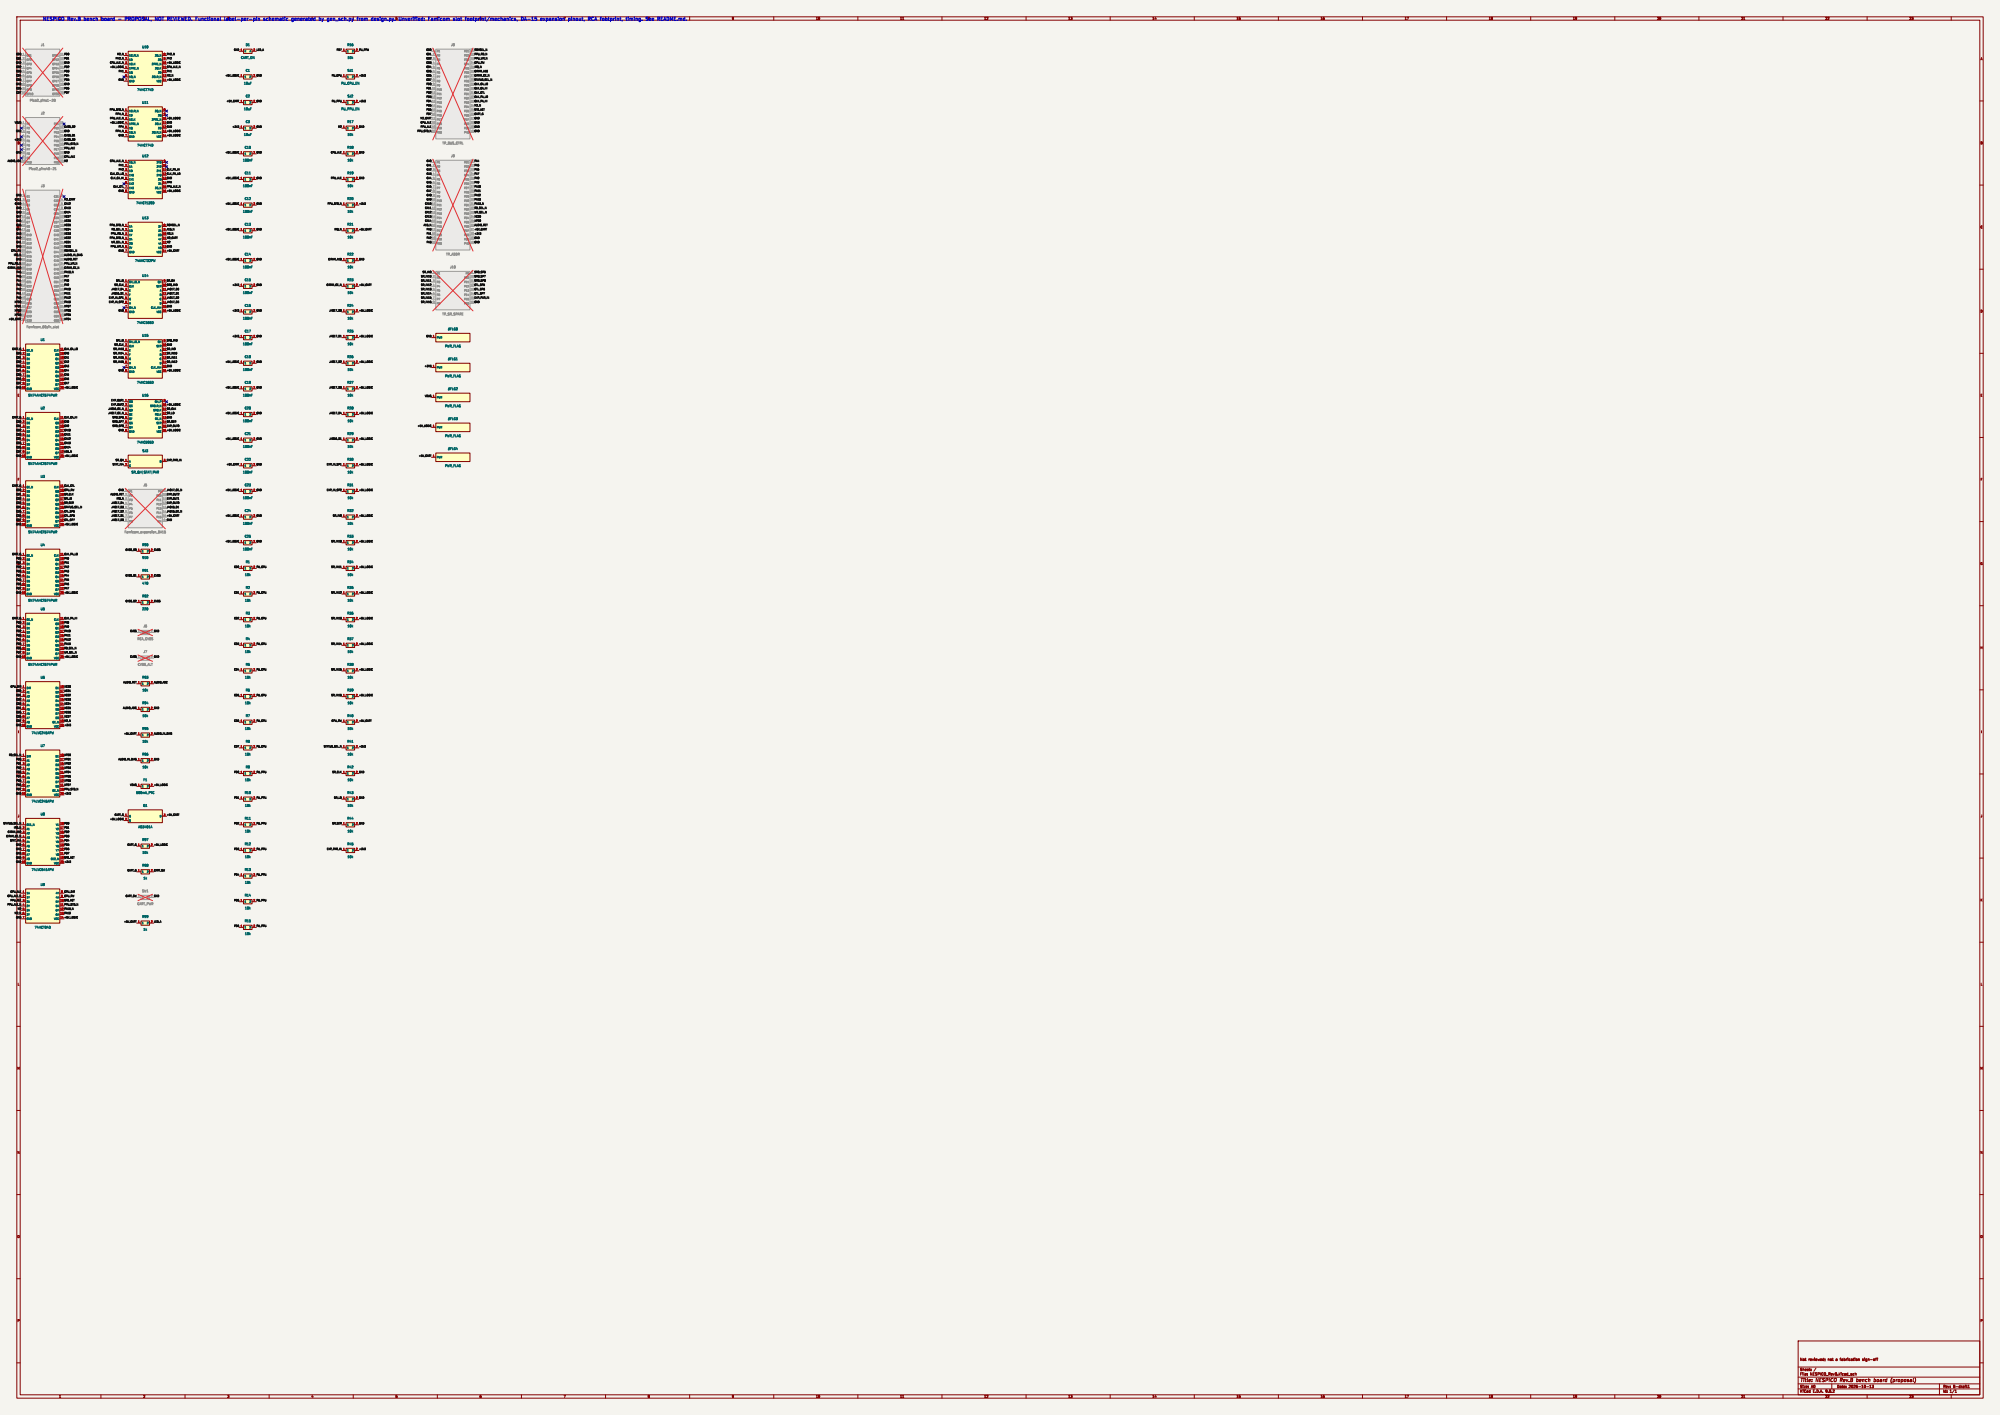
[picture p1: page 1]
