spaghetti-computer/lasagna/hardware/kicad/revc/LASAGNA2354_RevC.kicad_pcb

## KiCad design hardware/kicad/revc/LASAGNA2354_RevC.kicad_pcb (2026-11-04)

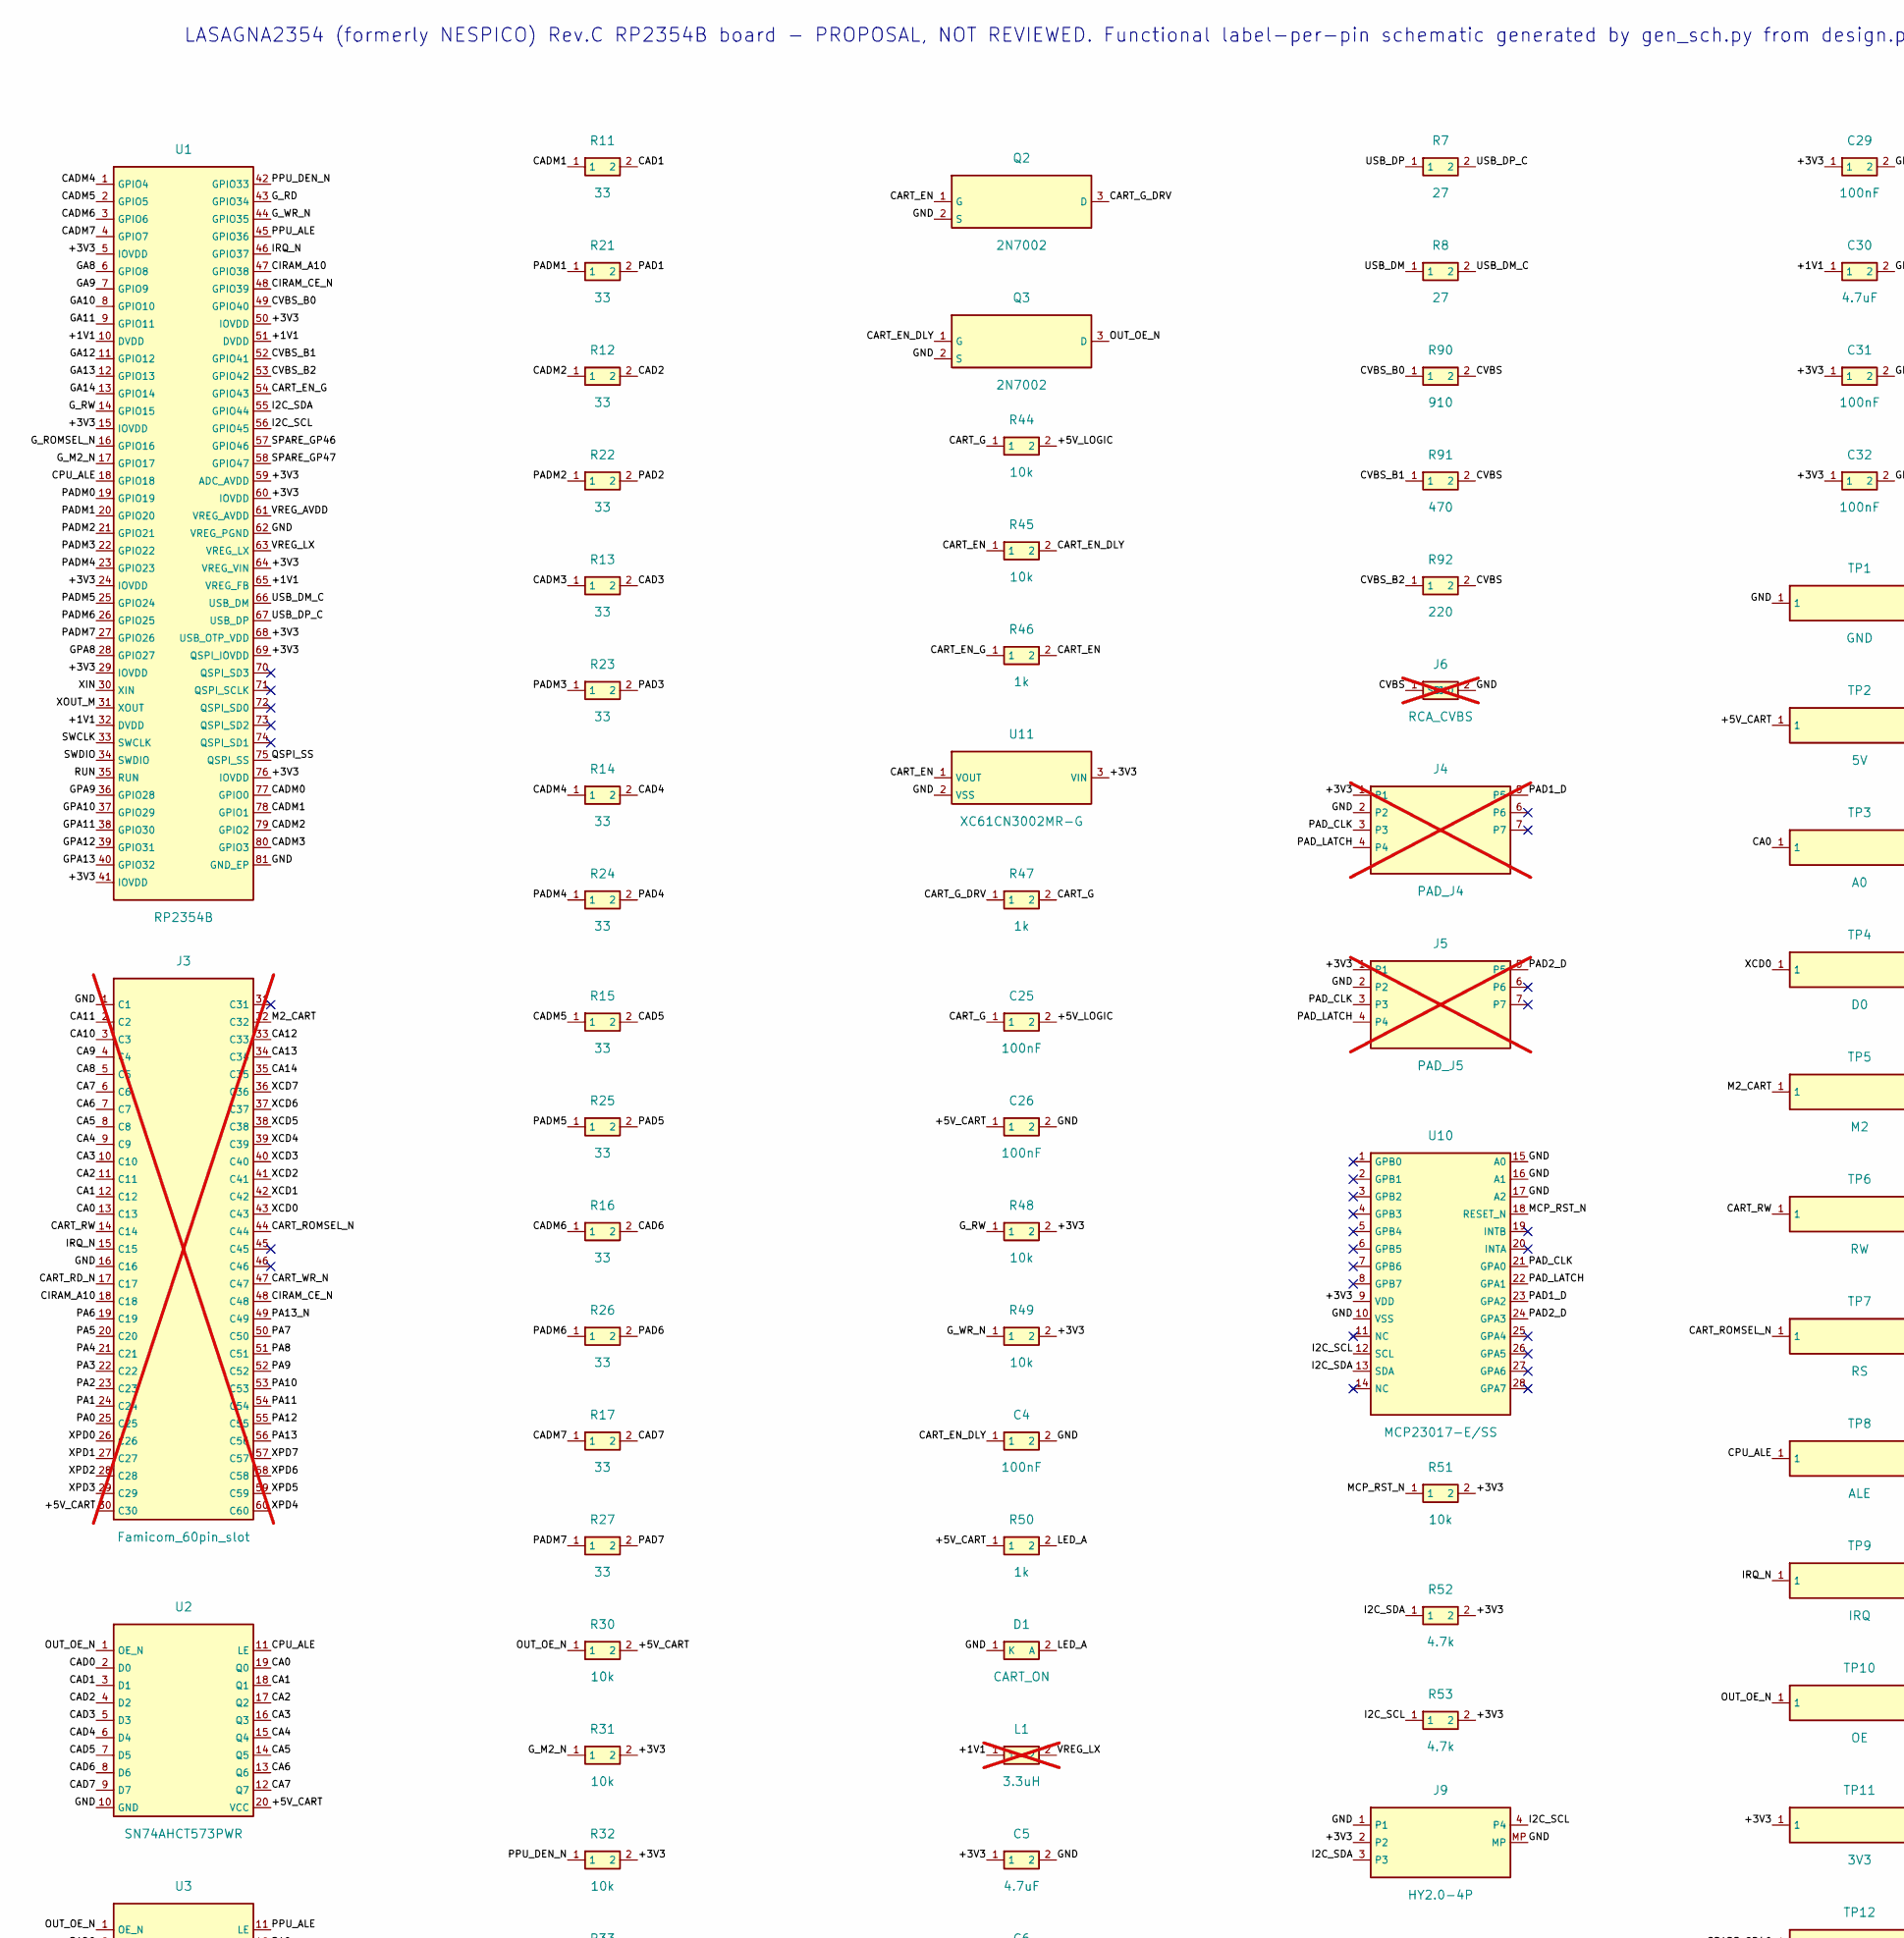
[picture p2: schematic LASAGNA2354_RevC.kicad_sch, LASAGNA2354 Rev.C RP2354B board (proposal), part in row 1, column 1]

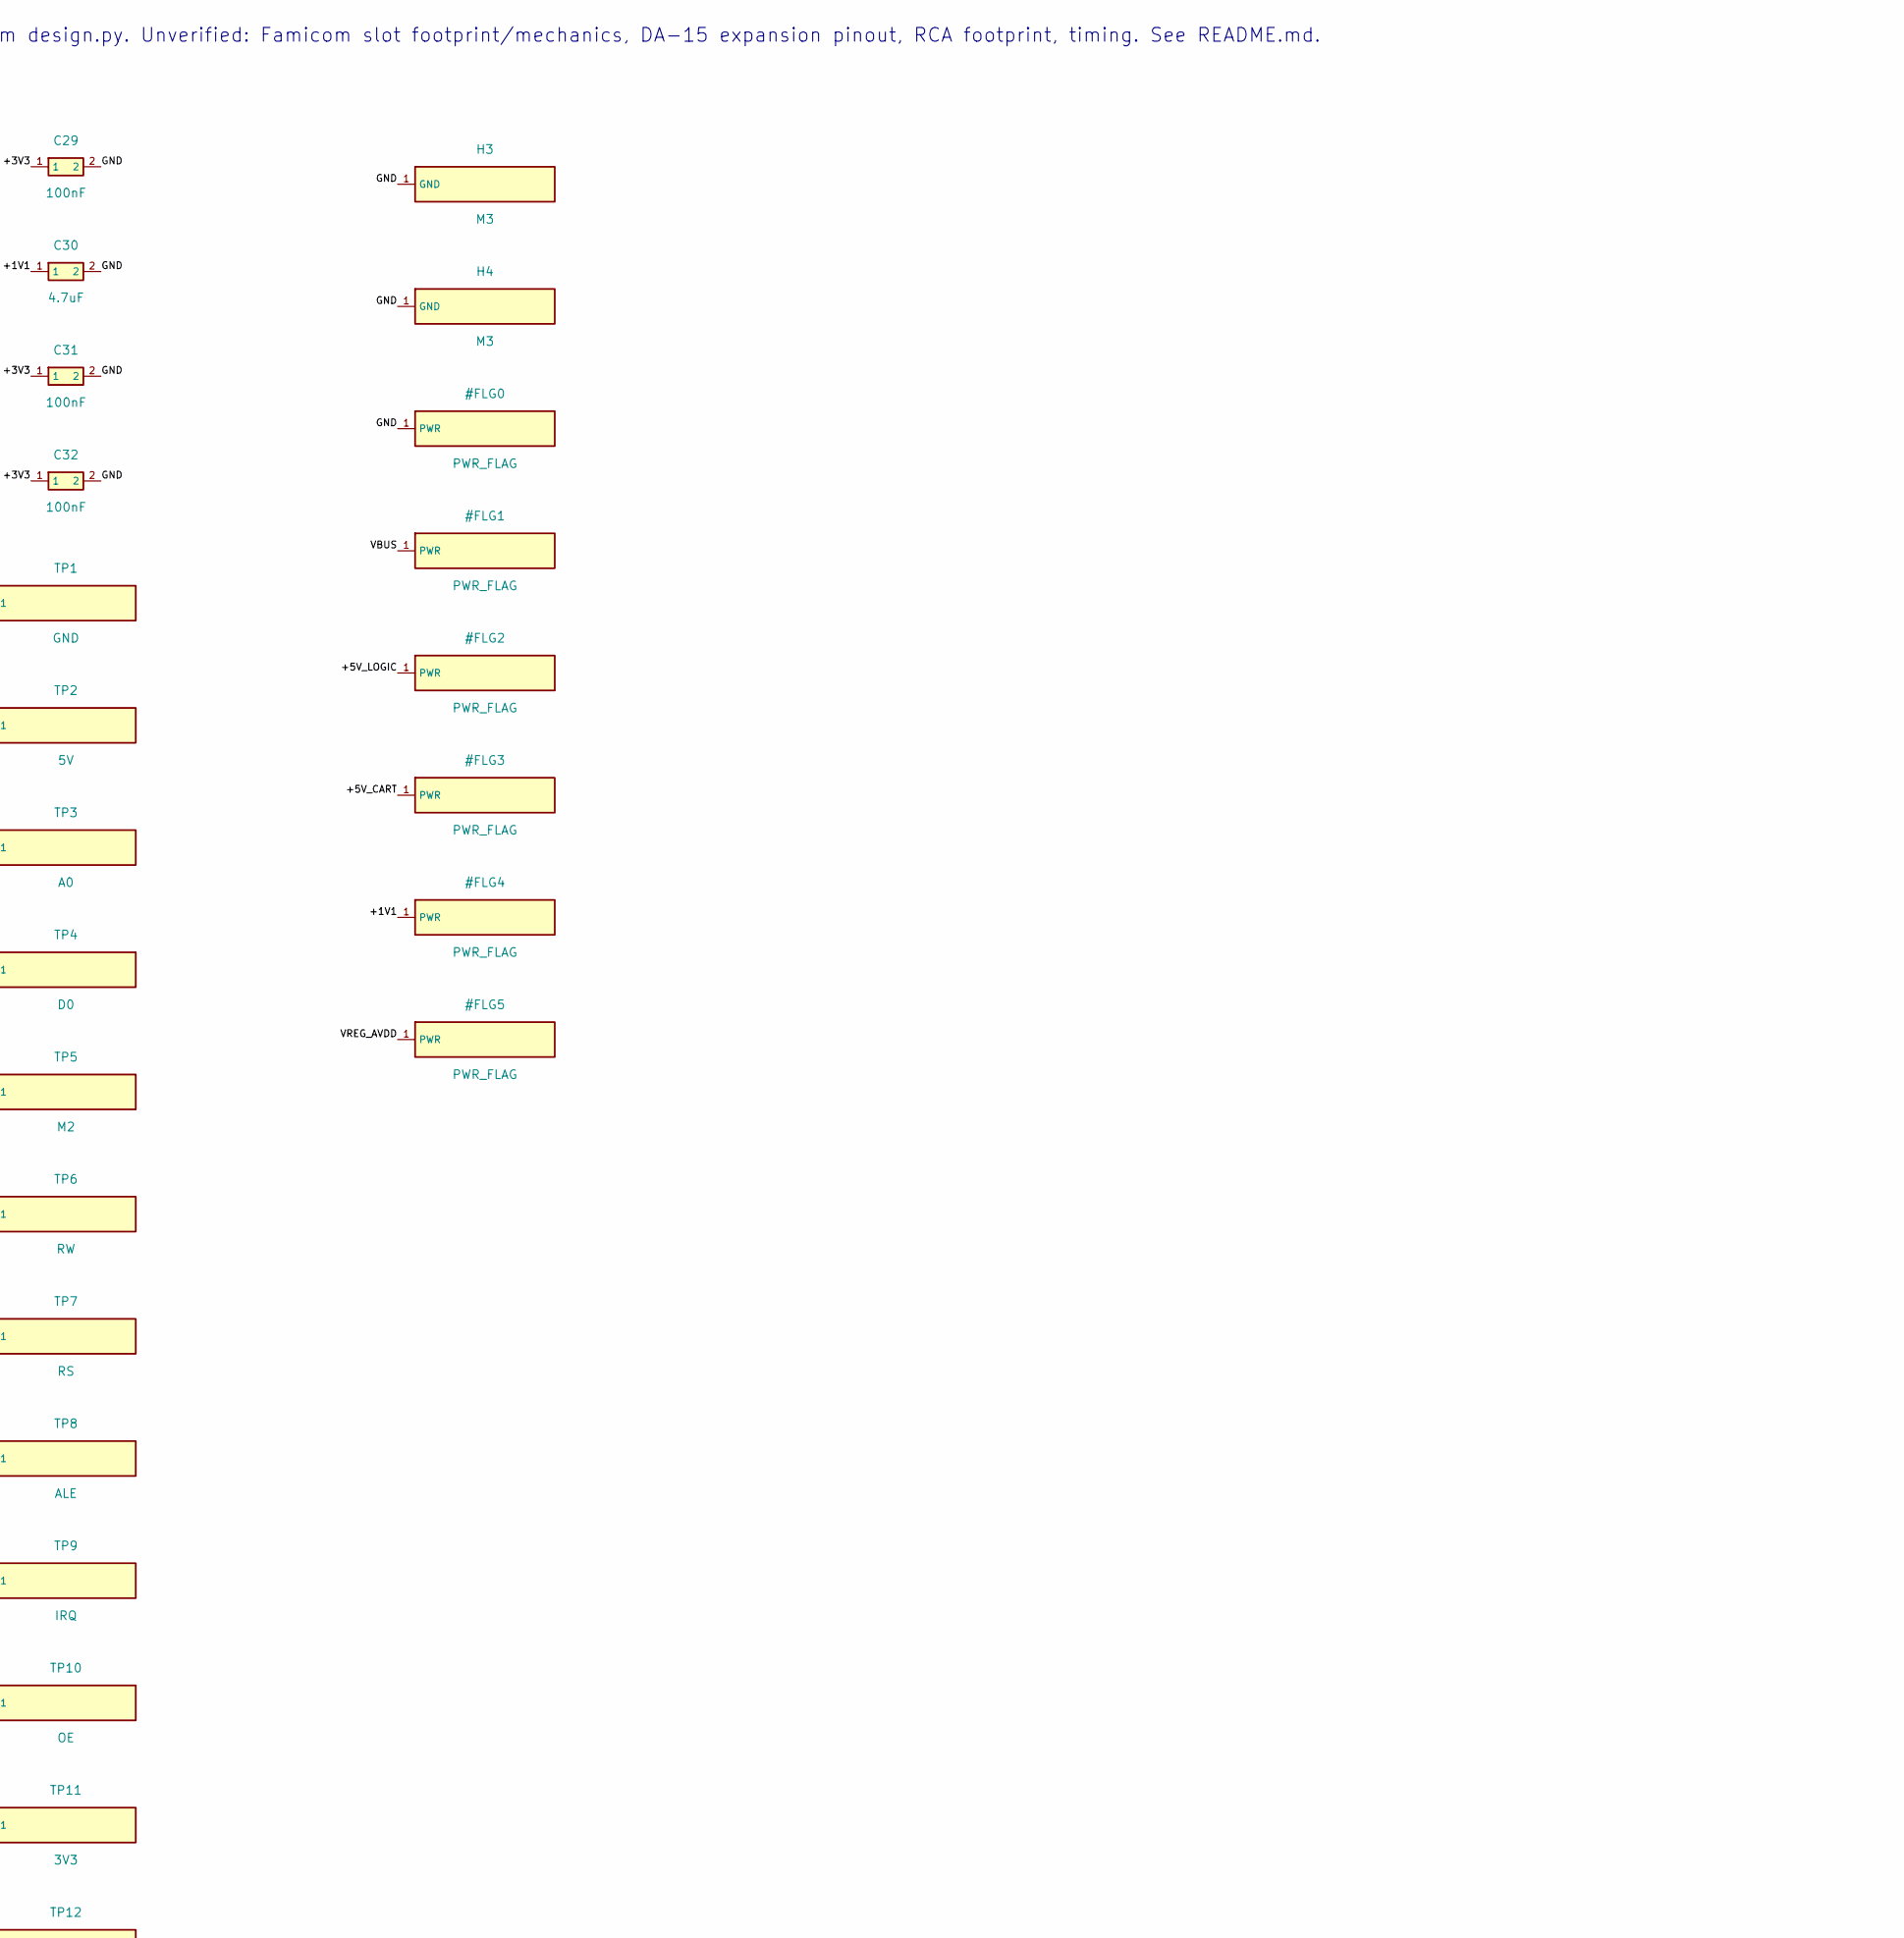
[picture p3: schematic LASAGNA2354_RevC.kicad_sch, LASAGNA2354 Rev.C RP2354B board (proposal), part in row 1, column 2]

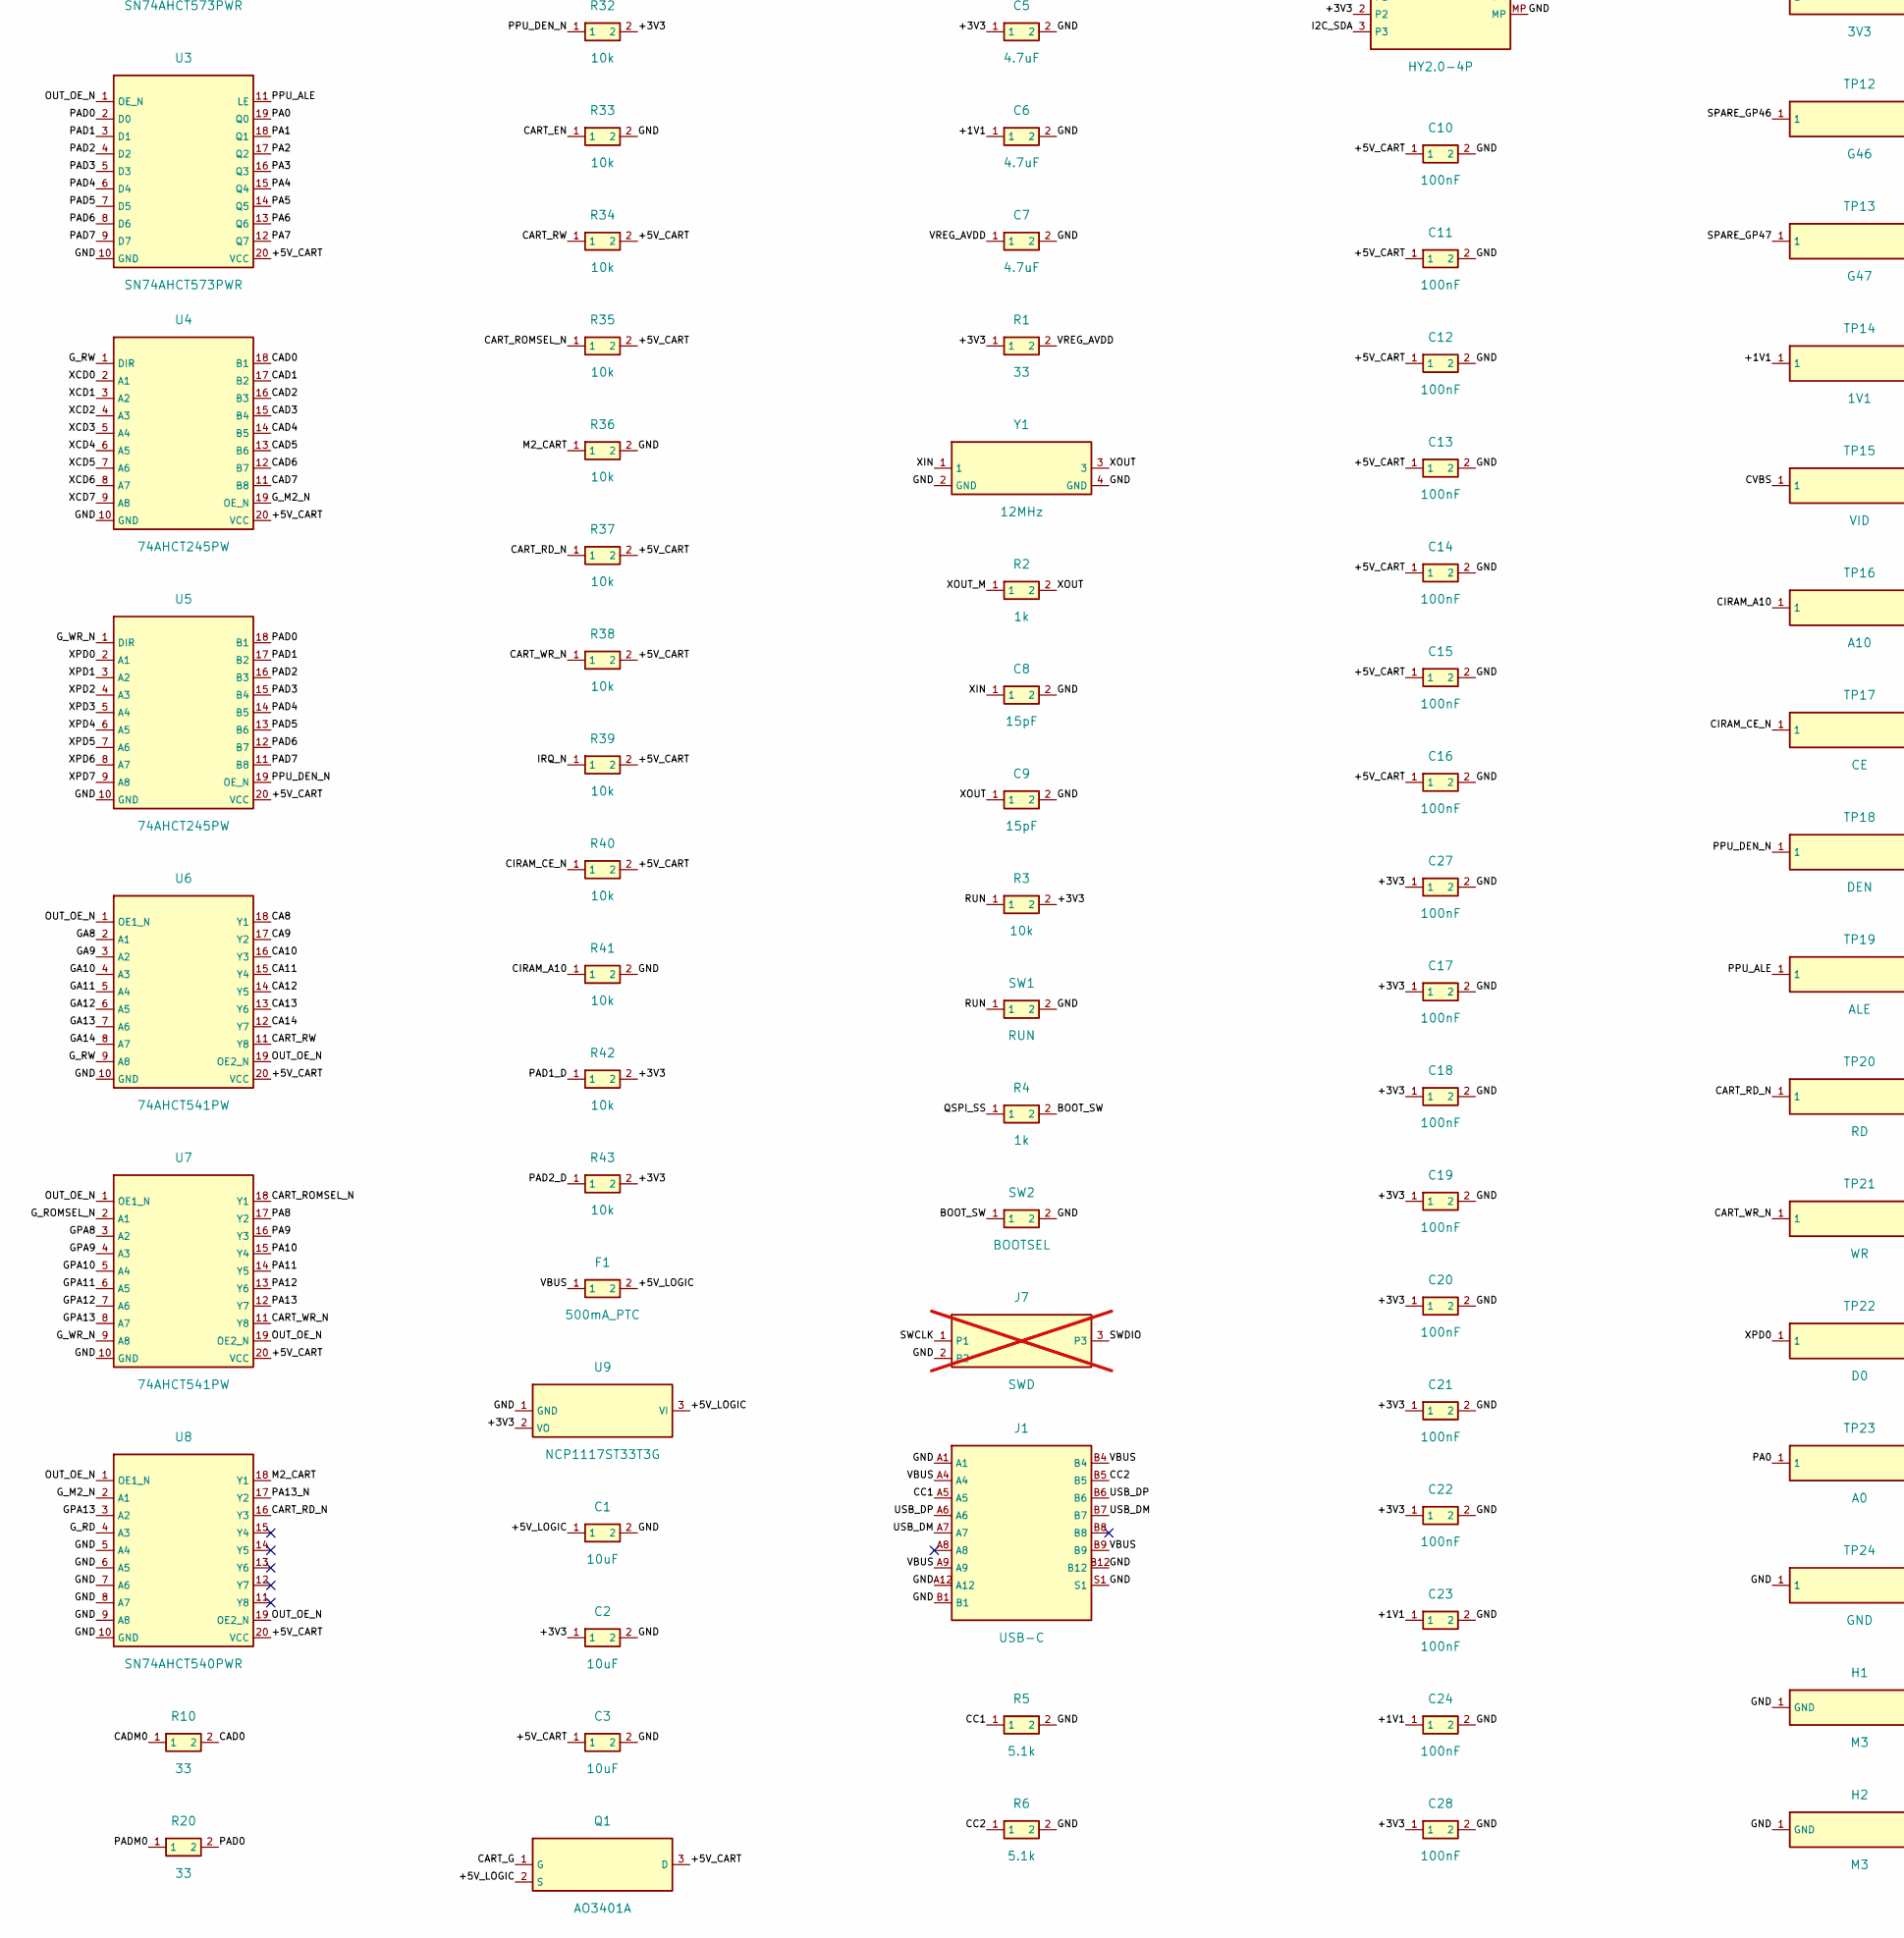
[picture p4: schematic LASAGNA2354_RevC.kicad_sch, LASAGNA2354 Rev.C RP2354B board (proposal), part in row 2, column 1]

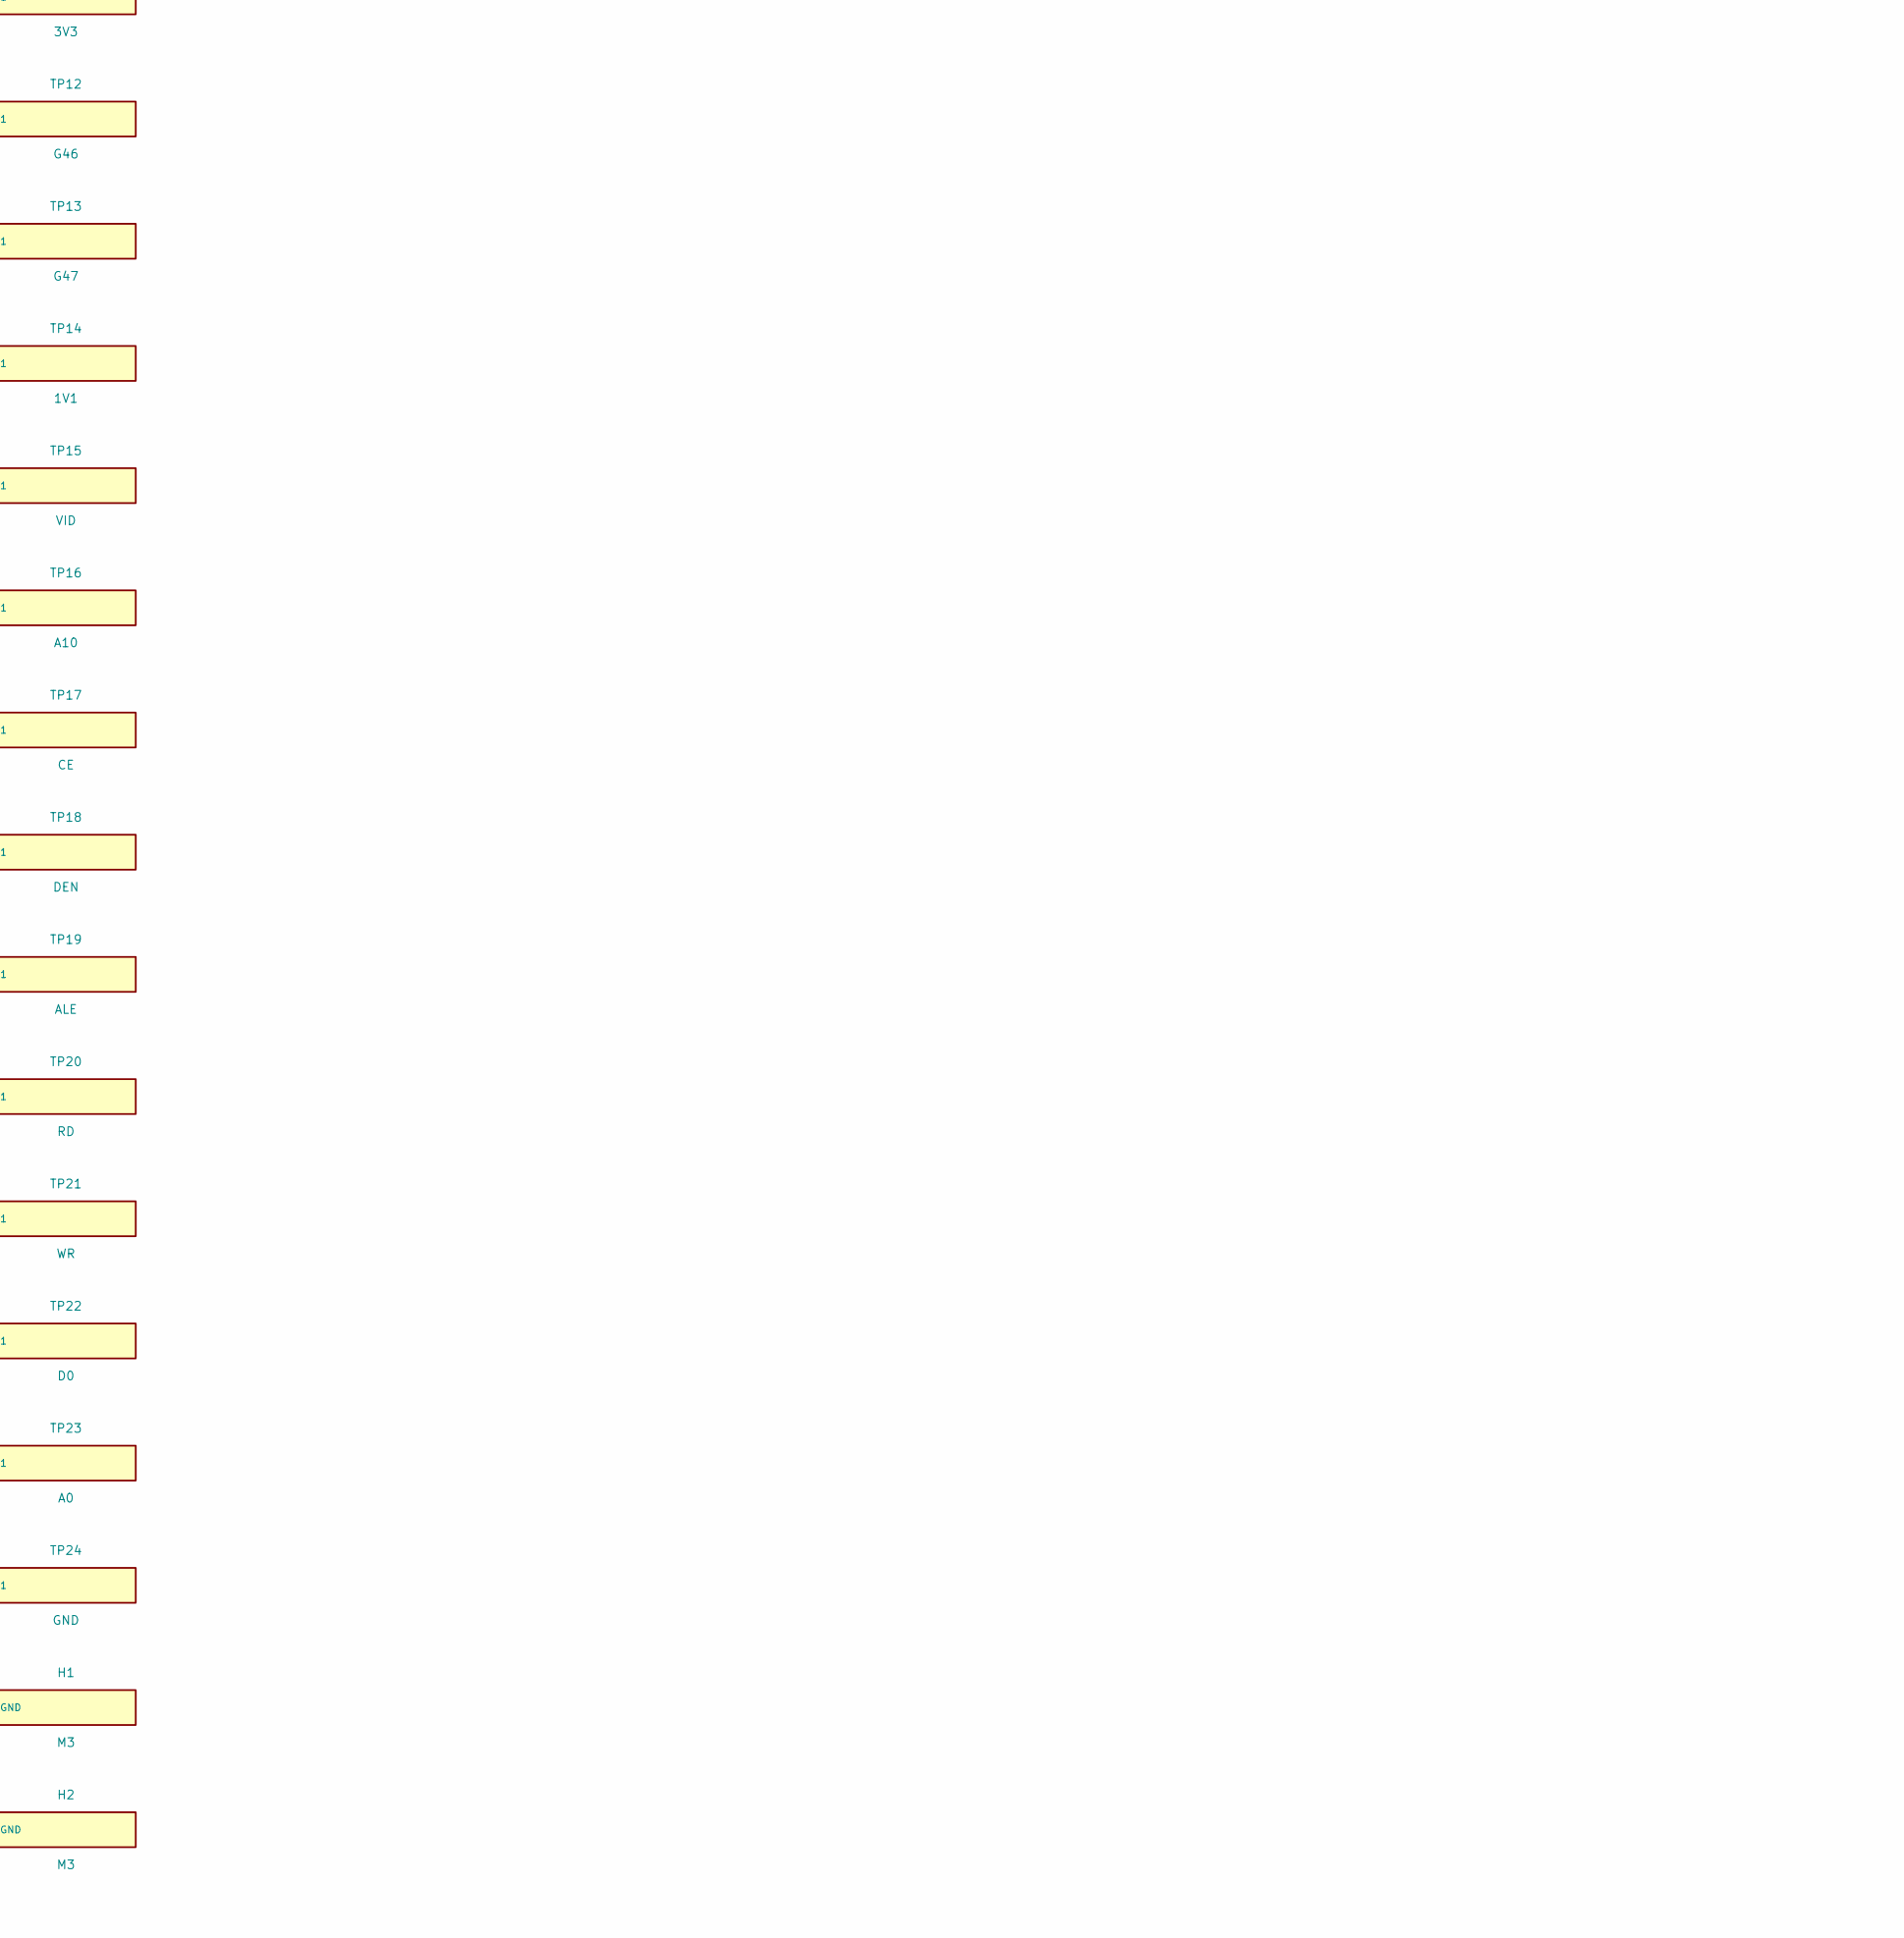
[picture p5: schematic LASAGNA2354_RevC.kicad_sch, LASAGNA2354 Rev.C RP2354B board (proposal), part in row 2, column 2]

Parts:
C1, C2, C3: 10uF; C_0805_2012Metric; MPN 10uF; LCSC C15850
C4, C10, C11, C12, C13, C14, C15, C16, C17, C18, C19, C20, C21, C22, C23, C24, C25, C26, C27, C28, C31, C32: 100nF; C_0603_1608Metric; MPN 100nF; LCSC C14663
C5, C6, C7, C30: 4.7uF; RPi_C_1005_wide; MPN 4.7uF-0402; LCSC C23733
C8, C9: 15pF; RPi_C_1005_wide; MPN 15pF-0402; LCSC C1548
C29: 100nF; RPi_C_1005_wide; MPN 100nF-0402; LCSC C1525
D1: CART_ON; LED_0603_1608Metric; MPN LED_G; LCSC C2286
F1: 500mA_PTC; Fuse_1206_3216Metric; MPN SMD1206-050-6; LCSC C46641012
H1, H2, H3, H4: M3; MountingHole_3.2mm_M3_Pad; LCSC_Status no LCSC part
J1: USB-C; USB_C_Receptacle_HRO_TYPE-C-31-M-12; MPN TYPE-C-31-M-12; LCSC C165948
J3: Famicom_60pin_slot; Hirose_CR22A-60D-2.54DS; MPN CR22A-60D-2.54DS(70); LCSC_Status hand-assembly / not PCBA; not fitted
J4: PAD_J4; PinHeader_1x07_P2.54mm_Vertical; LCSC_Status hand-assembly / not PCBA; not fitted
J5: PAD_J5; PinHeader_1x07_P2.54mm_Vertical; LCSC_Status hand-assembly / not PCBA; not fitted
J6: RCA_CVBS; RCA_Avvicon_MJ-526; MPN MJ-526-Y; LCSC_Status hand-assembly / not PCBA; not fitted
J7: SWD; PinHeader_1x03_P2.54mm_Vertical; LCSC_Status hand-assembly / not PCBA; not fitted
J9: HY2.0-4P; JST_PH_S4B-PH-SM4-TB_1x04-1MP_P2.00mm_Horizontal; MPN HY2.0-4P-WT; LCSC C722729
L1: 3.3uH; RPi_AOTA-B201610S3R3-101-T; MPN AOTA-B201610S3R3-101-T; LCSC C42411119; not fitted
Q1: AO3401A; SOT-23; MPN AO3401A; LCSC C15127
Q2, Q3: 2N7002; SOT-23; MPN 2N7002; LCSC C8545
R1: 33; RPi_R_1005; MPN 33R-0402; LCSC C25105
R2: 1k; RPi_R_1005; MPN 1k-0402; LCSC C11702
R3, R30, R31, R32, R33, R34, R35, R36, R37, R38, R39, R40, R41, R42, R43, R44, R45, R48, R49, R51: 10k; R_0603_1608Metric; MPN 10k; LCSC C25804
R4, R46, R47, R50: 1k; R_0603_1608Metric; MPN 1k; LCSC C21190
R5, R6: 5.1k; R_0603_1608Metric; MPN 5.1k; LCSC C23186
R7, R8: 27; RPi_R_1005; MPN 27R-0402; LCSC C25100
R10, R11, R12, R13, R14, R15, R16, R17, R20, R21, R22, R23, R24, R25, R26, R27: 33; R_0603_1608Metric; MPN 33; LCSC C23140
R52, R53: 4.7k; R_0603_1608Metric; MPN 4.7k; LCSC C23162
R90: 910; R_0603_1608Metric; MPN 910; LCSC C23264
R91: 470; R_0603_1608Metric; MPN 470; LCSC C23179
R92: 220; R_0603_1608Metric; MPN 220; LCSC C22962
SW1: RUN; SW_Push_1P1T_XKB_TS-1187A; MPN TS-1187A-B-A-B; LCSC C318884
SW2: BOOTSEL; SW_Push_1P1T_XKB_TS-1187A; MPN TS-1187A-B-A-B; LCSC C318884
TP1, TP24: GND; TestPoint_THTPad_D2.0mm_Drill1.0mm; LCSC_Status no LCSC part
TP2: 5V; TestPoint_THTPad_D2.0mm_Drill1.0mm; LCSC_Status no LCSC part
TP3, TP23: A0; TestPoint_THTPad_D2.0mm_Drill1.0mm; LCSC_Status no LCSC part
TP4, TP22: D0; TestPoint_THTPad_D2.0mm_Drill1.0mm; LCSC_Status no LCSC part
TP5: M2; TestPoint_THTPad_D2.0mm_Drill1.0mm; LCSC_Status no LCSC part
TP6: RW; TestPoint_THTPad_D2.0mm_Drill1.0mm; LCSC_Status no LCSC part
TP7: RS; TestPoint_THTPad_D2.0mm_Drill1.0mm; LCSC_Status no LCSC part
TP8, TP19: ALE; TestPoint_THTPad_D2.0mm_Drill1.0mm; LCSC_Status no LCSC part
TP9: IRQ; TestPoint_THTPad_D2.0mm_Drill1.0mm; LCSC_Status no LCSC part
TP10: OE; TestPoint_THTPad_D2.0mm_Drill1.0mm; LCSC_Status no LCSC part
TP11: 3V3; TestPoint_THTPad_D2.0mm_Drill1.0mm; LCSC_Status no LCSC part
TP12: G46; TestPoint_THTPad_D2.0mm_Drill1.0mm; LCSC_Status no LCSC part
TP13: G47; TestPoint_THTPad_D2.0mm_Drill1.0mm; LCSC_Status no LCSC part
TP14: 1V1; TestPoint_THTPad_D2.0mm_Drill1.0mm; LCSC_Status no LCSC part
TP15: VID; TestPoint_THTPad_D2.0mm_Drill1.0mm; LCSC_Status no LCSC part
TP16: A10; TestPoint_THTPad_D2.0mm_Drill1.0mm; LCSC_Status no LCSC part
TP17: CE; TestPoint_THTPad_D2.0mm_Drill1.0mm; LCSC_Status no LCSC part
TP18: DEN; TestPoint_THTPad_D2.0mm_Drill1.0mm; LCSC_Status no LCSC part
TP20: RD; TestPoint_THTPad_D2.0mm_Drill1.0mm; LCSC_Status no LCSC part
TP21: WR; TestPoint_THTPad_D2.0mm_Drill1.0mm; LCSC_Status no LCSC part
U1: RP2354B; QFN-80-1EP_10x10mm_P0.4mm_EP3.4x3.4mm; MPN RP2354B; LCSC C39843328
U2, U3: SN74AHCT573PWR; TSSOP-20_4.4x6.5mm_P0.65mm; MPN SN74AHCT573PWR; LCSC C141311
U4, U5: 74AHCT245PW; TSSOP-20_4.4x6.5mm_P0.65mm; MPN 74AHCT245PW,118; LCSC C173388
U6, U7: 74AHCT541PW; TSSOP-20_4.4x6.5mm_P0.65mm; MPN 74AHCT541PW,118; LCSC C84548
U8: SN74AHCT540PWR; TSSOP-20_4.4x6.5mm_P0.65mm; MPN SN74AHCT540PWR; LCSC C7626
U9: NCP1117ST33T3G; SOT-223-3_TabPin2; MPN NCP1117ST33T3G; LCSC C26537
U10: MCP23017-E/SS; SSOP-28_5.3x10.2mm_P0.65mm; MPN MCP23017-E/SS; LCSC C506653
U11: XC61CN3002MR-G; SOT-23; MPN XC61CN3002MR-G; LCSC C2456348
Y1: 12MHz; RPi_XTAL_3225-4; MPN ABM8-272-T3; LCSC C20625731

Connections:
/+1V1: C6.1, C23.1, C24.1, C30.1, L1.1, TP14.1, U1.10 (DVDD), U1.32 (DVDD), U1.51 (DVDD), U1.65 (VREG_FB)
/+3V3: C2.1, C5.1, C17.1, C18.1, C19.1, C20.1, C21.1, C22.1, C27.1, C28.1, C29.1, C31.1, C32.1, J4.1, J5.1, J9.2, R1.1, R3.2, R31.2, R32.2, R42.2, R43.2, R48.2, R49.2, R51.2, R52.2, R53.2, TP11.1, U1.5 (IOVDD), U1.15 (IOVDD), U1.24 (IOVDD), U1.29 (IOVDD), U1.41 (IOVDD), U1.50 (IOVDD), U1.59 (ADC_AVDD), U1.60 (IOVDD), U1.64 (VREG_VIN), U1.68 (USB_OTP_VDD), U1.69 (QSPI_IOVDD), U1.76 (IOVDD), U9.2 (VO), U10.9 (VDD), U11.3 (VIN)
/+5V_CART: C3.1, C10.1, C11.1, C12.1, C13.1, C14.1, C15.1, C16.1, C26.1, J3.30 (C30), Q1.3 (D), R30.2, R34.2, R35.2, R37.2, R38.2, R39.2, R40.2, R50.1, TP2.1, U2.20 (VCC), U3.20 (VCC), U4.20 (VCC), U5.20 (VCC), U6.20 (VCC), U7.20 (VCC), U8.20 (VCC)
/+5V_LOGIC: C1.1, C25.2, F1.2, Q1.2 (S), R44.2, U9.3 (VI)
/BOOT_SW: R4.2, SW2.1
/CA0: J3.13 (C13), TP3.1, U2.19 (Q0)
/CA1: J3.12 (C12), U2.18 (Q1)
/CA2: J3.11 (C11), U2.17 (Q2)
/CA3: J3.10 (C10), U2.16 (Q3)
/CA4: J3.9 (C9), U2.15 (Q4)
/CA5: J3.8 (C8), U2.14 (Q5)
/CA6: J3.7 (C7), U2.13 (Q6)
/CA7: J3.6 (C6), U2.12 (Q7)
/CA8: J3.5 (C5), U6.18 (Y1)
/CA9: J3.4 (C4), U6.17 (Y2)
/CA10: J3.3 (C3), U6.16 (Y3)
/CA11: J3.2 (C2), U6.15 (Y4)
/CA12: J3.33 (C33), U6.14 (Y5)
/CA13: J3.34 (C34), U6.13 (Y6)
/CA14: J3.35 (C35), U6.12 (Y7)
/CAD0: R10.2, U2.2 (D0), U4.18 (B1)
/CAD1: R11.2, U2.3 (D1), U4.17 (B2)
/CAD2: R12.2, U2.4 (D2), U4.16 (B3)
/CAD3: R13.2, U2.5 (D3), U4.15 (B4)
/CAD4: R14.2, U2.6 (D4), U4.14 (B5)
/CAD5: R15.2, U2.7 (D5), U4.13 (B6)
/CAD6: R16.2, U2.8 (D6), U4.12 (B7)
/CAD7: R17.2, U2.9 (D7), U4.11 (B8)
/CADM0: R10.1, U1.77 (GPIO0)
/CADM1: R11.1, U1.78 (GPIO1)
/CADM2: R12.1, U1.79 (GPIO2)
/CADM3: R13.1, U1.80 (GPIO3)
/CADM4: R14.1, U1.1 (GPIO4)
/CADM5: R15.1, U1.2 (GPIO5)
/CADM6: R16.1, U1.3 (GPIO6)
/CADM7: R17.1, U1.4 (GPIO7)
/CART_EN: Q2.1 (G), R33.1, R45.1, R46.2, U11.1 (VOUT)
/CART_EN_DLY: C4.1, Q3.1 (G), R45.2
/CART_EN_G: R46.1, U1.54 (GPIO43)
/CART_G: C25.1, Q1.1 (G), R44.1, R47.2
/CART_G_DRV: Q2.3 (D), R47.1
/CART_RD_N: J3.17 (C17), R37.1, TP20.1, U8.16 (Y3)
/CART_ROMSEL_N: J3.44 (C44), R35.1, TP7.1, U7.18 (Y1)
/CART_RW: J3.14 (C14), R34.1, TP6.1, U6.11 (Y8)
/CART_WR_N: J3.47 (C47), R38.1, TP21.1, U7.11 (Y8)
/CC1: J1.A5, R5.1
/CC2: J1.B5, R6.1
/CIRAM_A10: J3.18 (C18), R41.1, TP16.1, U1.47 (GPIO38)
/CIRAM_CE_N: J3.48 (C48), R40.1, TP17.1, U1.48 (GPIO39)
/CPU_ALE: TP8.1, U1.18 (GPIO18), U2.11 (LE)
/CVBS: J6.1 (SIG), R90.2, R91.2, R92.2, TP15.1
/CVBS_B0: R90.1, U1.49 (GPIO40)
/CVBS_B1: R91.1, U1.52 (GPIO41)
/CVBS_B2: R92.1, U1.53 (GPIO42)
/GA8: U1.6 (GPIO8), U6.2 (A1)
/GA9: U1.7 (GPIO9), U6.3 (A2)
/GA10: U1.8 (GPIO10), U6.4 (A3)
/GA11: U1.9 (GPIO11), U6.5 (A4)
/GA12: U1.11 (GPIO12), U6.6 (A5)
/GA13: U1.12 (GPIO13), U6.7 (A6)
/GA14: U1.13 (GPIO14), U6.8 (A7)
/GND: C1.2, C2.2, C3.2, C4.2, C5.2, C6.2, C7.2, C8.2, C9.2, C10.2, C11.2, C12.2, C13.2, C14.2, C15.2, C16.2, C17.2, C18.2, C19.2, C20.2, C21.2, C22.2, C23.2, C24.2, C26.2, C27.2, C28.2, C29.2, C30.2, C31.2, C32.2, D1.1 (K), H1.1, H2.1, H3.1, H4.1, J1.A1, J1.A12, J1.B1, J1.B12, J1.S1, J3.1 (C1), J3.16 (C16), J4.2, J5.2, J6.2 (GND), J7.2, J9.1, J9.MP, Q2.2 (S), Q3.2 (S), R5.2, R6.2, R33.2, R36.2, R41.2, SW1.2, SW2.2, TP1.1, TP24.1, U1.62 (VREG_PGND), U1.81 (GND_EP), U2.10 (GND), U3.10 (GND), U4.10 (GND), U5.10 (GND), U6.10 (GND), U7.10 (GND), U8.5 (A4), U8.6 (A5), U8.7 (A6), U8.8 (A7), U8.9 (A8), U8.10 (GND), U9.1 (GND), U10.10 (VSS), U10.15 (A0), U10.16 (A1), U10.17 (A2), U11.2 (VSS), Y1.2 (GND), Y1.4 (GND)
/GPA8: U1.28 (GPIO27), U7.3 (A2)
/GPA9: U1.36 (GPIO28), U7.4 (A3)
/GPA10: U1.37 (GPIO29), U7.5 (A4)
/GPA11: U1.38 (GPIO30), U7.6 (A5)
/GPA12: U1.39 (GPIO31), U7.7 (A6)
/GPA13: U1.40 (GPIO32), U7.8 (A7), U8.3 (A2)
/G_M2_N: R31.1, U1.17 (GPIO17), U4.19 (OE_N), U8.2 (A1)
/G_RD: U1.43 (GPIO34), U8.4 (A3)
/G_ROMSEL_N: U1.16 (GPIO16), U7.2 (A1)
/G_RW: R48.1, U1.14 (GPIO15), U4.1 (DIR), U6.9 (A8)
/G_WR_N: R49.1, U1.44 (GPIO35), U5.1 (DIR), U7.9 (A8)
/I2C_SCL: J9.4, R53.1, U1.56 (GPIO45), U10.12 (SCL)
/I2C_SDA: J9.3, R52.1, U1.55 (GPIO44), U10.13 (SDA)
/IRQ_N: J3.15 (C15), R39.1, TP9.1, U1.46 (GPIO37)
/LED_A: D1.2 (A), R50.2
/M2_CART: J3.32 (C32), R36.1, TP5.1, U8.18 (Y1)
/MCP_RST_N: R51.1, U10.18 (RESET_N)
/OUT_OE_N: Q3.3 (D), R30.1, TP10.1, U2.1 (OE_N), U3.1 (OE_N), U6.1 (OE1_N), U6.19 (OE2_N), U7.1 (OE1_N), U7.19 (OE2_N), U8.1 (OE1_N), U8.19 (OE2_N)
/PA0: J3.25 (C25), TP23.1, U3.19 (Q0)
/PA1: J3.24 (C24), U3.18 (Q1)
/PA2: J3.23 (C23), U3.17 (Q2)
/PA3: J3.22 (C22), U3.16 (Q3)
/PA4: J3.21 (C21), U3.15 (Q4)
/PA5: J3.20 (C20), U3.14 (Q5)
/PA6: J3.19 (C19), U3.13 (Q6)
/PA7: J3.50 (C50), U3.12 (Q7)
/PA8: J3.51 (C51), U7.17 (Y2)
/PA9: J3.52 (C52), U7.16 (Y3)
/PA10: J3.53 (C53), U7.15 (Y4)
/PA11: J3.54 (C54), U7.14 (Y5)
/PA12: J3.55 (C55), U7.13 (Y6)
/PA13: J3.56 (C56), U7.12 (Y7)
/PA13_N: J3.49 (C49), U8.17 (Y2)
/PAD0: R20.2, U3.2 (D0), U5.18 (B1)
/PAD1: R21.2, U3.3 (D1), U5.17 (B2)
/PAD1_D: J4.5, R42.1, U10.23 (GPA2)
/PAD2: R22.2, U3.4 (D2), U5.16 (B3)
/PAD2_D: J5.5, R43.1, U10.24 (GPA3)
/PAD3: R23.2, U3.5 (D3), U5.15 (B4)
/PAD4: R24.2, U3.6 (D4), U5.14 (B5)
/PAD5: R25.2, U3.7 (D5), U5.13 (B6)
/PAD6: R26.2, U3.8 (D6), U5.12 (B7)
/PAD7: R27.2, U3.9 (D7), U5.11 (B8)
/PADM0: R20.1, U1.19 (GPIO19)
/PADM1: R21.1, U1.20 (GPIO20)
/PADM2: R22.1, U1.21 (GPIO21)
/PADM3: R23.1, U1.22 (GPIO22)
/PADM4: R24.1, U1.23 (GPIO23)
/PADM5: R25.1, U1.25 (GPIO24)
/PADM6: R26.1, U1.26 (GPIO25)
/PADM7: R27.1, U1.27 (GPIO26)
/PAD_CLK: J4.3, J5.3, U10.21 (GPA0)
/PAD_LATCH: J4.4, J5.4, U10.22 (GPA1)
/PPU_ALE: TP19.1, U1.45 (GPIO36), U3.11 (LE)
/PPU_DEN_N: R32.1, TP18.1, U1.42 (GPIO33), U5.19 (OE_N)
/QSPI_SS: R4.1, U1.75 (QSPI_SS)
/RUN: R3.1, SW1.1, U1.35 (RUN)
/SPARE_GP46: TP12.1, U1.57 (GPIO46)
/SPARE_GP47: TP13.1, U1.58 (GPIO47)
/SWCLK: J7.1, U1.33 (SWCLK)
/SWDIO: J7.3, U1.34 (SWDIO)
/USB_DM: J1.A7, J1.B7, R8.1
/USB_DM_C: R8.2, U1.66 (USB_DM)
/USB_DP: J1.A6, J1.B6, R7.1
/USB_DP_C: R7.2, U1.67 (USB_DP)
/VBUS: F1.1, J1.A4, J1.A9, J1.B4, J1.B9
/VREG_AVDD: C7.1, R1.2, U1.61 (VREG_AVDD)
/VREG_LX: L1.2, U1.63 (VREG_LX)
/XCD0: J3.43 (C43), TP4.1, U4.2 (A1)
/XCD1: J3.42 (C42), U4.3 (A2)
/XCD2: J3.41 (C41), U4.4 (A3)
/XCD3: J3.40 (C40), U4.5 (A4)
/XCD4: J3.39 (C39), U4.6 (A5)
/XCD5: J3.38 (C38), U4.7 (A6)
/XCD6: J3.37 (C37), U4.8 (A7)
/XCD7: J3.36 (C36), U4.9 (A8)
/XIN: C8.1, U1.30 (XIN), Y1.1
/XOUT: C9.1, R2.2, Y1.3
/XOUT_M: R2.1, U1.31 (XOUT)
/XPD0: J3.26 (C26), TP22.1, U5.2 (A1)
/XPD1: J3.27 (C27), U5.3 (A2)
/XPD2: J3.28 (C28), U5.4 (A3)
/XPD3: J3.29 (C29), U5.5 (A4)
/XPD4: J3.60 (C60), U5.6 (A5)
/XPD5: J3.59 (C59), U5.7 (A6)
/XPD6: J3.58 (C58), U5.8 (A7)
/XPD7: J3.57 (C57), U5.9 (A8)

Notes on the sheet:
LASAGNA2354 (formerly NESPICO) Rev.C RP2354B board - PROPOSAL, NOT REVIEWED. Functional label-per-pin schematic generated by gen_sch.py from design.py. Unverified: Famicom slot footprint/mechanics, DA-15 expansion pinout, RCA footprint, timing. See README.md.

Board: 2 copper layers, 141 parts (24 on the bottom side), 149 nets, no tracks yet.

Other parts of the board:
FID1, FID2, FID3: Fiducial_1mm_Mask2mm
