spaghetti-computer/lasagna/hardware/kicad/revb/NESPICO_RevB.kicad_pcb

## KiCad design hardware/kicad/revb/NESPICO_RevB.kicad_pcb (2026-11-04, an earlier design)

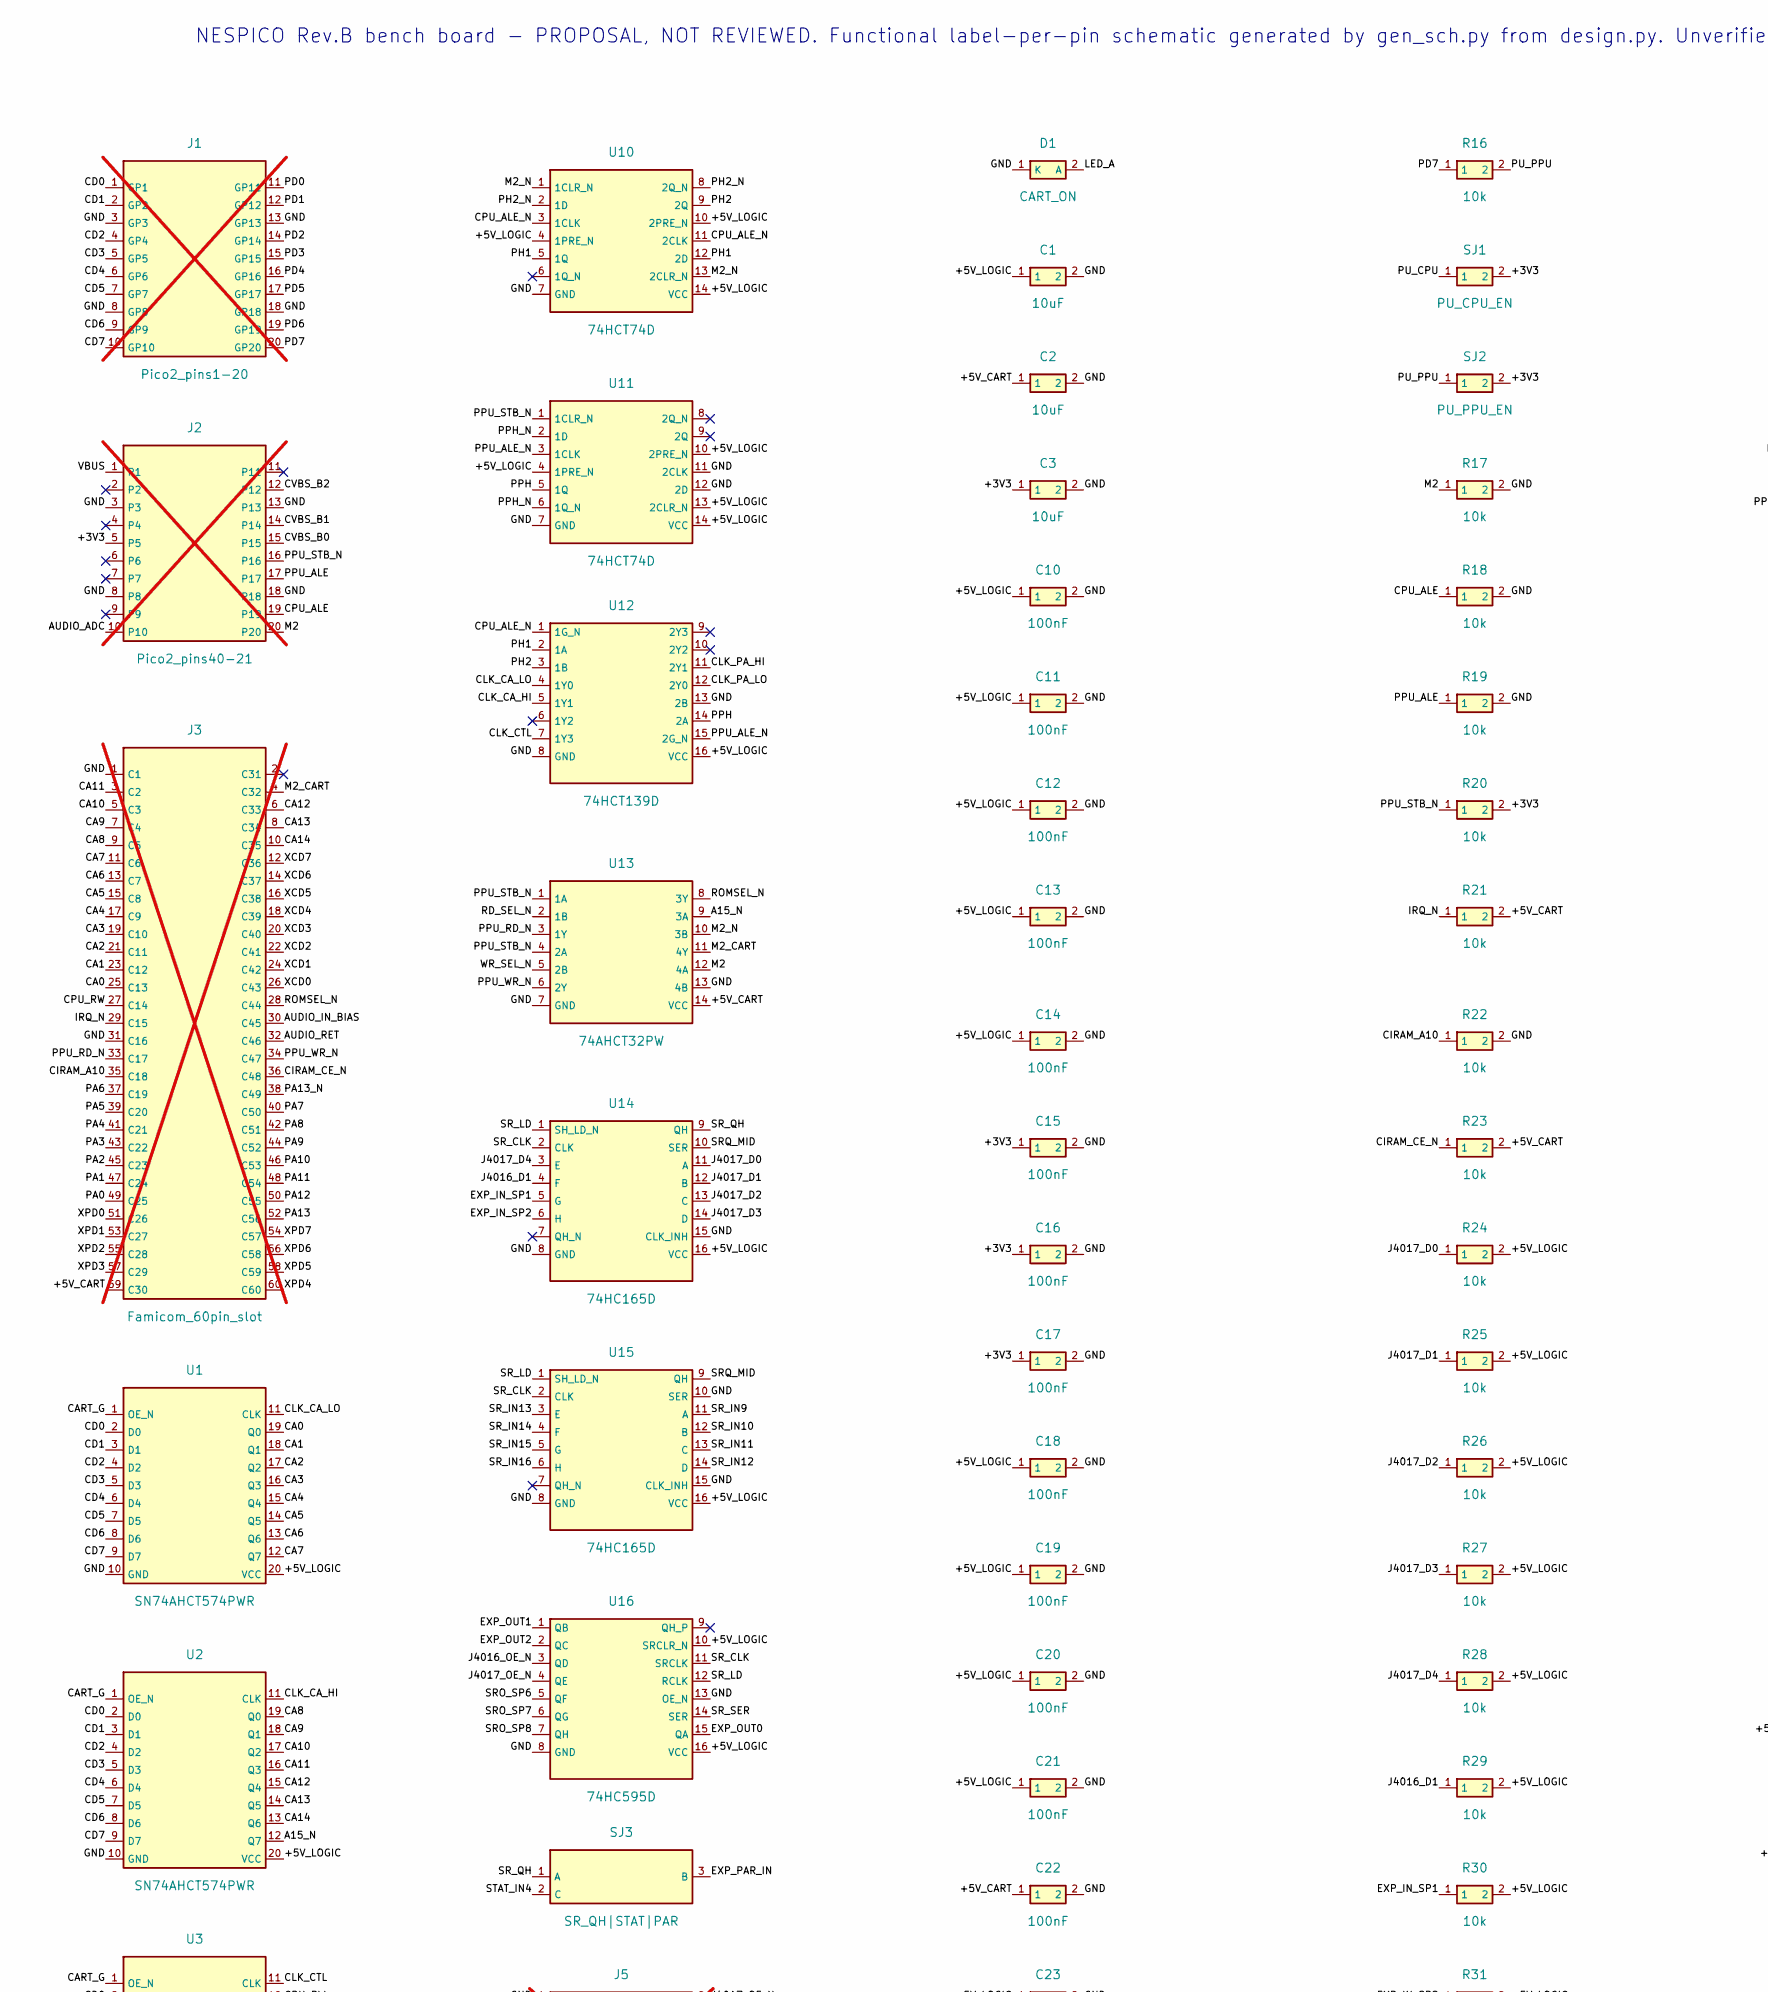
[picture p6: schematic NESPICO_RevB.kicad_sch, NESPICO Rev.B bench board (proposal), part in row 1, column 1]

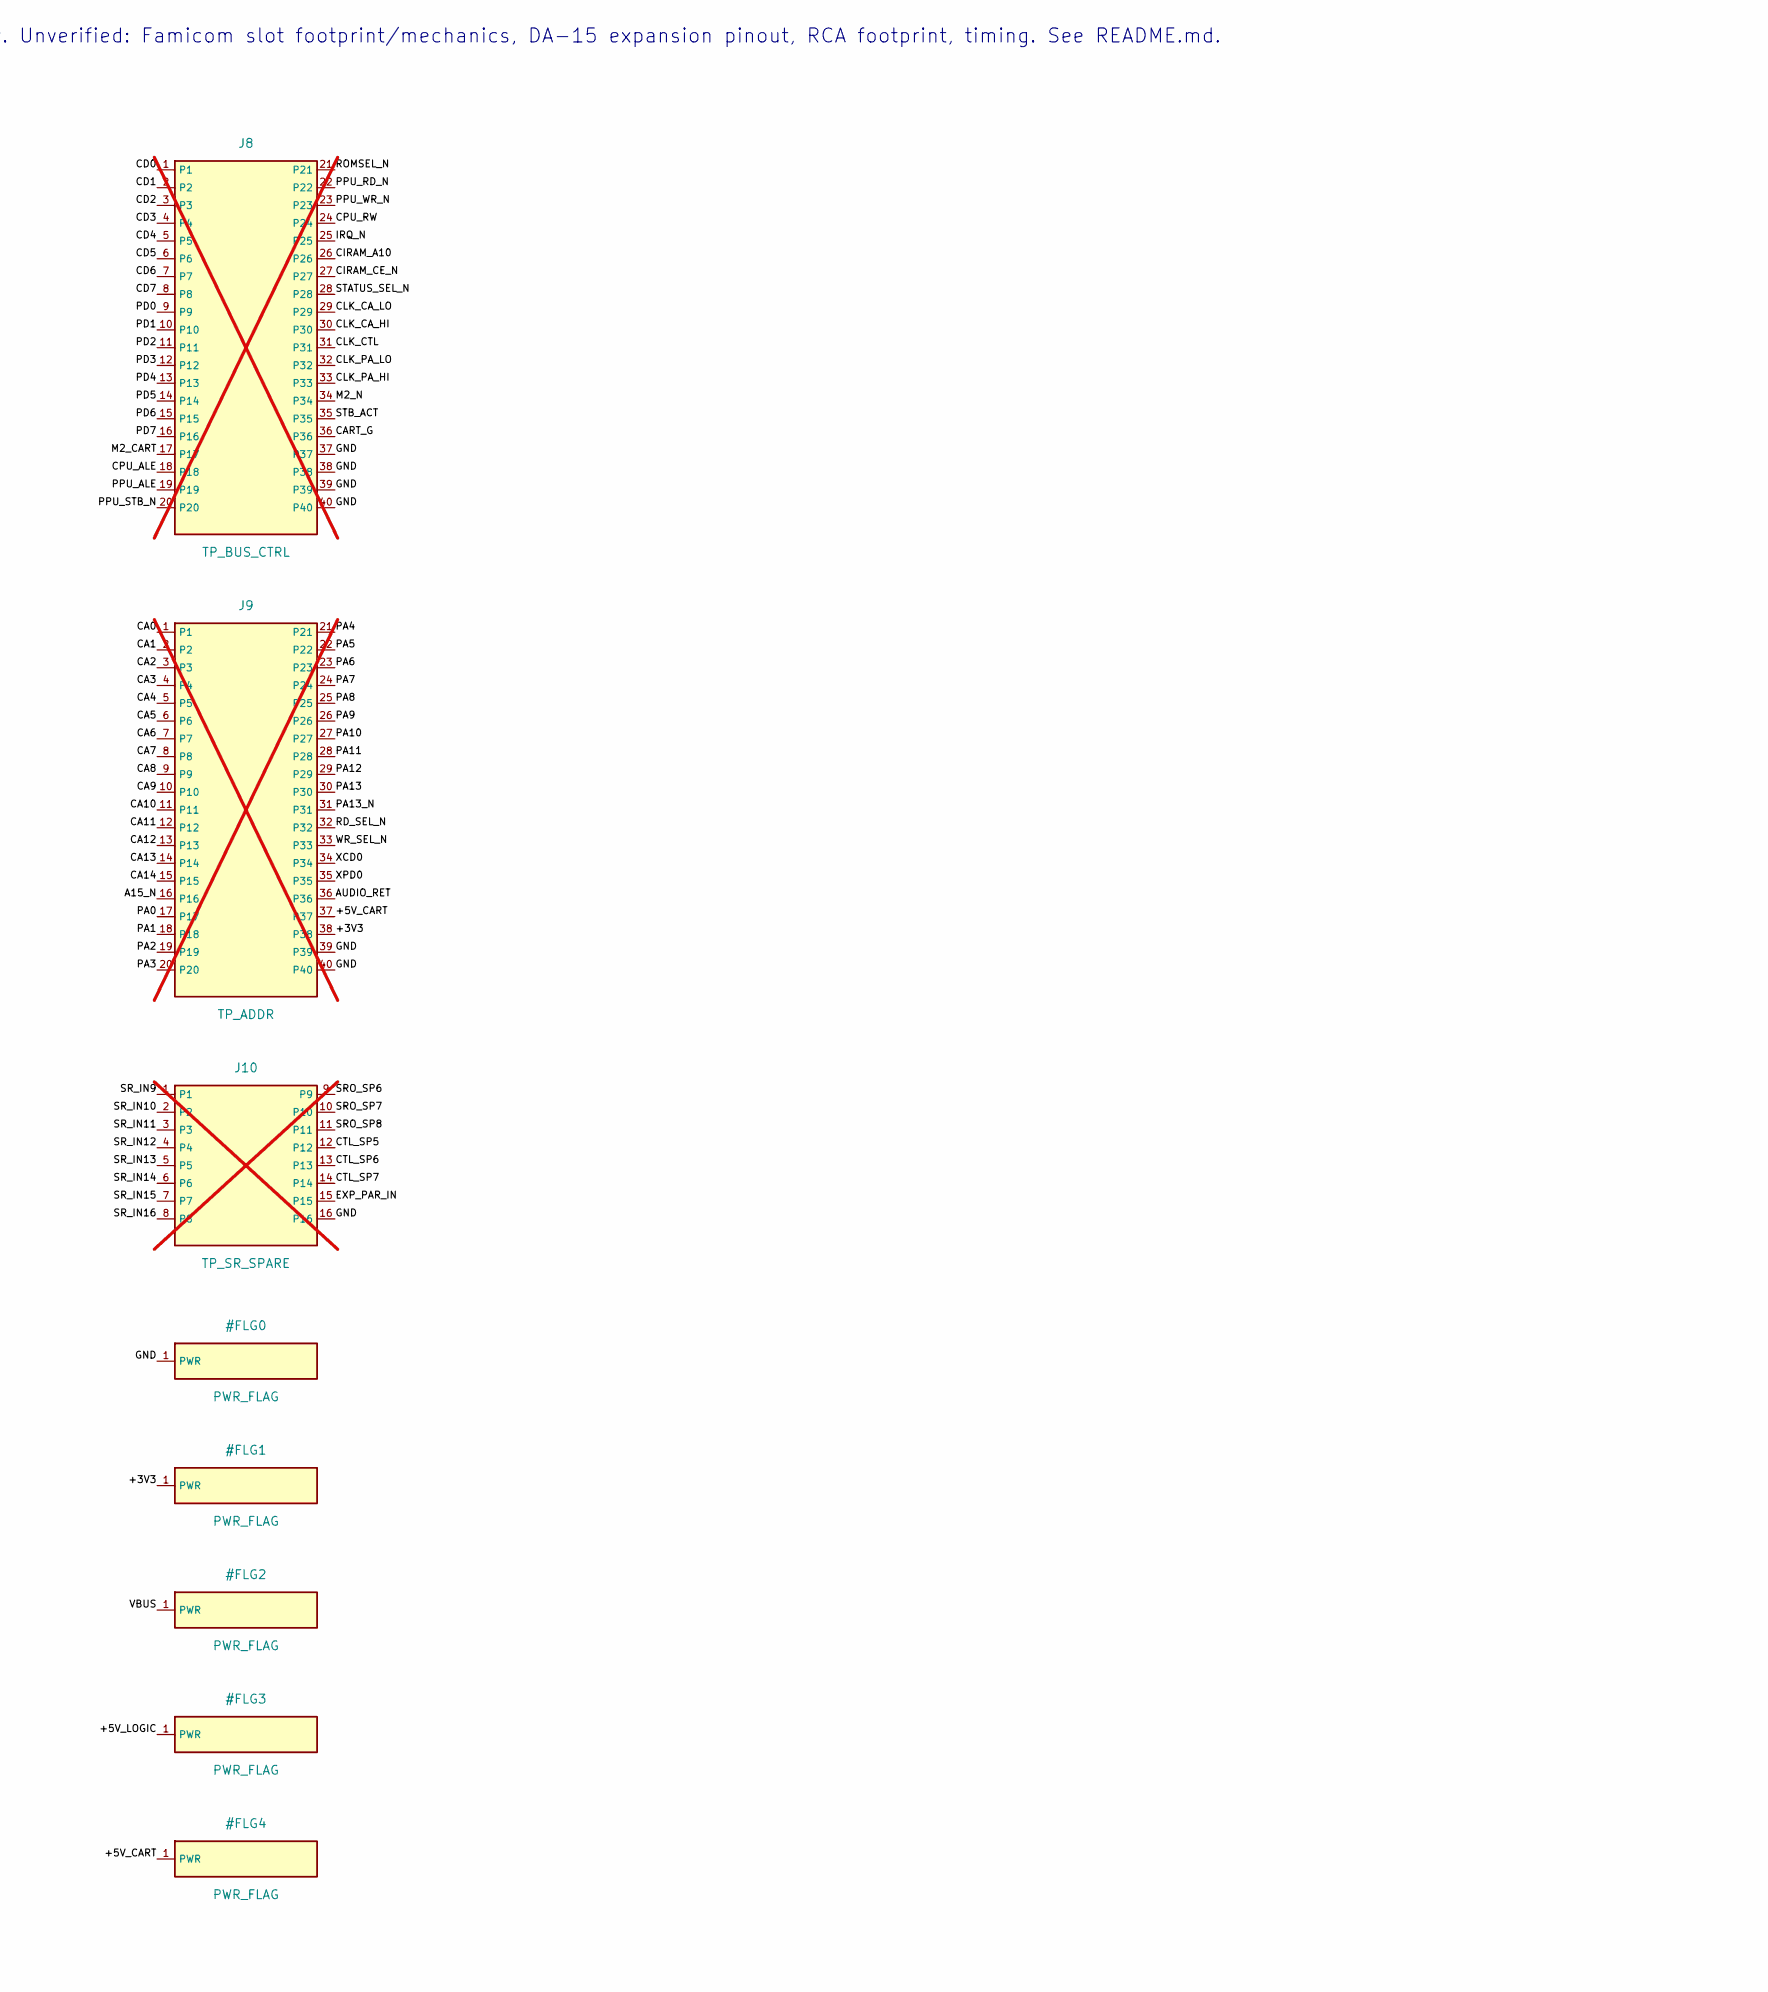
[picture p7: schematic NESPICO_RevB.kicad_sch, NESPICO Rev.B bench board (proposal), part in row 1, column 2]

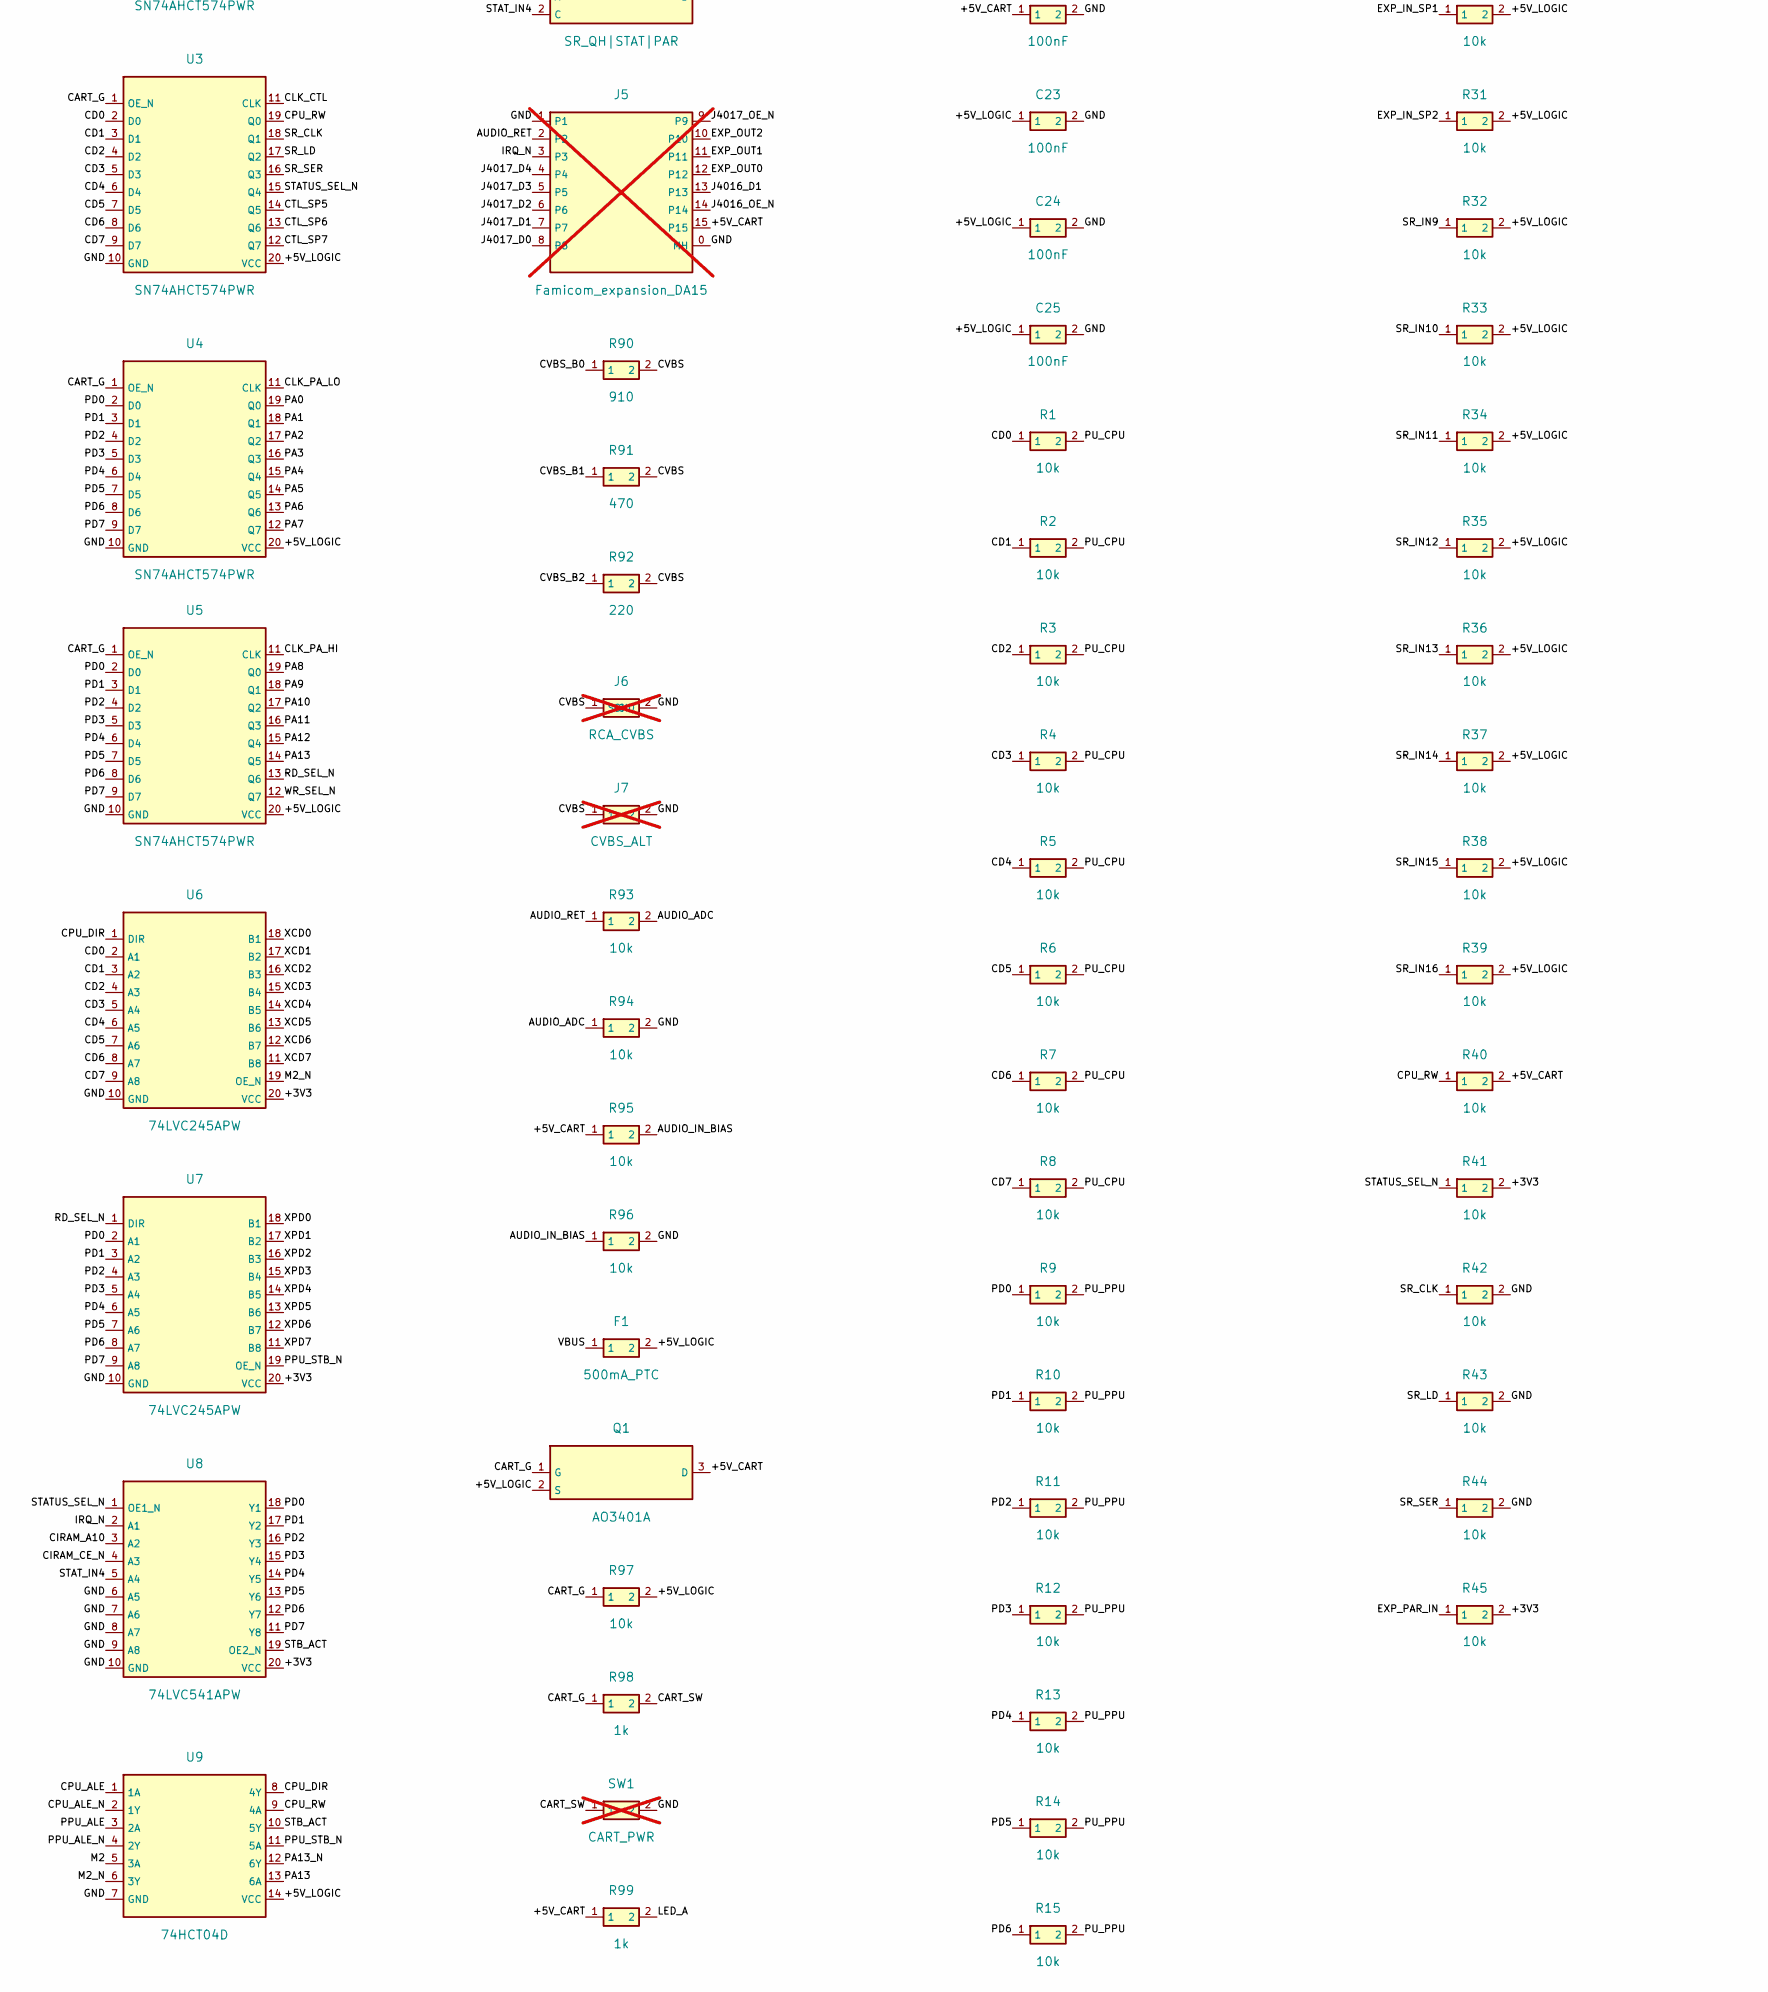
[picture p8: schematic NESPICO_RevB.kicad_sch, NESPICO Rev.B bench board (proposal), part in row 2, column 1]

Parts:
C1, C2, C3: 10uF; C_0805_2012Metric; MPN 10uF; LCSC C15850
C10, C11, C12, C13, C14, C15, C16, C17, C18, C19, C20, C21, C22, C23, C24, C25: 100nF; C_0603_1608Metric; MPN 100nF; LCSC C14663
D1: CART_ON; LED_0603_1608Metric; MPN LED_G; LCSC C72043
F1: 500mA_PTC; Fuse_1206_3216Metric; MPN SMD1206-050-6; LCSC C46641012
J1: Pico2_pins1-20; PinSocket_1x20_P2.54mm_Vertical; LCSC_Status hand-assembly / not PCBA; not fitted
J2: Pico2_pins40-21; PinSocket_1x20_P2.54mm_Vertical; LCSC_Status hand-assembly / not PCBA; not fitted
J3: Famicom_60pin_slot; PinHeader_2x30_P2.54mm_Vertical; LCSC_Status hand-assembly / not PCBA; not fitted
J5: Famicom_expansion_DA15; DSUB-15_Socket_Horizontal_P2.77x2.84mm_EdgePinOffset9.40mm; LCSC_Status hand-assembly / not PCBA; not fitted
J6: RCA_CVBS; RCA_Jack_Generic_THT_UNVERIFIED; LCSC_Status hand-assembly / not PCBA; not fitted
J7: CVBS_ALT; PinHeader_1x02_P2.54mm_Vertical; LCSC_Status hand-assembly / not PCBA; not fitted
J8: TP_BUS_CTRL; PinHeader_2x20_P2.54mm_Vertical; LCSC_Status hand-assembly / not PCBA; not fitted
J9: TP_ADDR; PinHeader_2x20_P2.54mm_Vertical; LCSC_Status hand-assembly / not PCBA; not fitted
J10: TP_SR_SPARE; PinHeader_2x08_P2.54mm_Vertical; LCSC_Status hand-assembly / not PCBA; not fitted
Q1: AO3401A; SOT-23; MPN AO3401A; LCSC C15127
R1, R2, R3, R4, R5, R6, R7, R8, R9, R10, R11, R12, R13, R14, R15, R16, R17, R18, R19, R20, R21, R22, R23, R24, R25, R26, R27, R28, R29, R30, R31, R32, R33, R34, R35, R36, R37, R38, R39, R40, R41, R42, R43, R44, R45, R93, R94, R95, R96, R97: 10k; R_0603_1608Metric; MPN 10k; LCSC C25804
R90: 910; R_0603_1608Metric; MPN 910; LCSC C23264
R91: 470; R_0603_1608Metric; MPN 470; LCSC C23179
R92: 220; R_0603_1608Metric; MPN 220; LCSC C22962
R98, R99: 1k; R_0603_1608Metric; MPN 1k; LCSC C21190
SJ1: PU_CPU_EN; SolderJumper-2_P1.3mm_Bridged_Pad1.0x1.5mm; LCSC_Status no LCSC part
SJ2: PU_PPU_EN; SolderJumper-2_P1.3mm_Bridged_Pad1.0x1.5mm; LCSC_Status no LCSC part
SJ3: SR_QH|STAT|PAR; SolderJumper-3_P1.3mm_Bridged12_Pad1.0x1.5mm; LCSC_Status no LCSC part
SW1: CART_PWR; SW_DIP_SPSTx01_Slide_6.7x4.1mm_W7.62mm_P2.54mm_LowProfile; LCSC_Status hand-assembly / not PCBA; not fitted
U1, U2, U3, U4, U5: SN74AHCT574PWR; TSSOP-20_4.4x6.5mm_P0.65mm; MPN SN74AHCT574PWR; LCSC C129433
U6, U7: 74LVC245APW; TSSOP-20_4.4x6.5mm_P0.65mm; MPN 74LVC245APW,118; LCSC C6082
U8: 74LVC541APW; TSSOP-20_4.4x6.5mm_P0.65mm; MPN 74LVC541APW,118; LCSC C6093
U9: 74HCT04D; SOIC-14_3.9x8.7mm_P1.27mm; MPN 74HCT04D,653; LCSC C672096
U10, U11: 74HCT74D; SOIC-14_3.9x8.7mm_P1.27mm; MPN 74HCT74D,653; LCSC C686657
U12: 74HCT139D; SOIC-16_3.9x9.9mm_P1.27mm; MPN 74HCT139D,653; LCSC C545677
U13: 74AHCT32PW; TSSOP-14_4.4x5mm_P0.65mm; MPN 74AHCT32PW,118; LCSC C554656
U14, U15: 74HC165D; SOIC-16_3.9x9.9mm_P1.27mm; MPN 74HC165D,653; LCSC C5613
U16: 74HC595D; SOIC-16_3.9x9.9mm_P1.27mm; MPN 74HC595D,118; LCSC C5947

Connections:
+3V3: C3.1, C15.1, C16.1, C17.1, J2.5, J9.38, R20.2, R41.2, R45.2, SJ1.2, SJ2.2, U6.20 (VCC), U7.20 (VCC), U8.20 (VCC)
+5V_CART: C2.1, C22.1, J3.59 (C30), J5.15, J9.37, Q1.3 (D), R21.2, R23.2, R40.2, R95.1, R99.1, U13.14 (VCC)
+5V_LOGIC: C1.1, C10.1, C11.1, C12.1, C13.1, C14.1, C18.1, C19.1, C20.1, C21.1, C23.1, C24.1, C25.1, F1.2, Q1.2 (S), R24.2, R25.2, R26.2, R27.2, R28.2, R29.2, R30.2, R31.2, R32.2, R33.2, R34.2, R35.2, R36.2, R37.2, R38.2, R39.2, R97.2, U1.20 (VCC), U2.20 (VCC), U3.20 (VCC), U4.20 (VCC), U5.20 (VCC), U9.14 (VCC), U10.4 (1PRE_N), U10.10 (2PRE_N), U10.14 (VCC), U11.4 (1PRE_N), U11.10 (2PRE_N), U11.13 (2CLR_N), U11.14 (VCC), U12.16 (VCC), U14.16 (VCC), U15.16 (VCC), U16.10 (SRCLR_N), U16.16 (VCC)
A15_N: J9.16, U2.12 (Q7), U13.9 (3A)
AUDIO_ADC: J2.10, R93.2, R94.1
AUDIO_IN_BIAS: J3.30 (C45), R95.2, R96.1
AUDIO_RET: J3.32 (C46), J5.2, J9.36, R93.1
CA0: J3.25 (C13), J9.1, U1.19 (Q0)
CA1: J3.23 (C12), J9.2, U1.18 (Q1)
CA2: J3.21 (C11), J9.3, U1.17 (Q2)
CA3: J3.19 (C10), J9.4, U1.16 (Q3)
CA4: J3.17 (C9), J9.5, U1.15 (Q4)
CA5: J3.15 (C8), J9.6, U1.14 (Q5)
CA6: J3.13 (C7), J9.7, U1.13 (Q6)
CA7: J3.11 (C6), J9.8, U1.12 (Q7)
CA8: J3.9 (C5), J9.9, U2.19 (Q0)
CA9: J3.7 (C4), J9.10, U2.18 (Q1)
CA10: J3.5 (C3), J9.11, U2.17 (Q2)
CA11: J3.3 (C2), J9.12, U2.16 (Q3)
CA12: J3.6 (C33), J9.13, U2.15 (Q4)
CA13: J3.8 (C34), J9.14, U2.14 (Q5)
CA14: J3.10 (C35), J9.15, U2.13 (Q6)
CART_G: J8.36, Q1.1 (G), R97.1, R98.1, U1.1 (OE_N), U2.1 (OE_N), U3.1 (OE_N), U4.1 (OE_N), U5.1 (OE_N)
CART_SW: R98.2, SW1.1
CD0: J1.1 (GP1), J8.1, R1.1, U1.2 (D0), U2.2 (D0), U3.2 (D0), U6.2 (A1)
CD1: J1.2 (GP2), J8.2, R2.1, U1.3 (D1), U2.3 (D1), U3.3 (D1), U6.3 (A2)
CD2: J1.4 (GP4), J8.3, R3.1, U1.4 (D2), U2.4 (D2), U3.4 (D2), U6.4 (A3)
CD3: J1.5 (GP5), J8.4, R4.1, U1.5 (D3), U2.5 (D3), U3.5 (D3), U6.5 (A4)
CD4: J1.6 (GP6), J8.5, R5.1, U1.6 (D4), U2.6 (D4), U3.6 (D4), U6.6 (A5)
CD5: J1.7 (GP7), J8.6, R6.1, U1.7 (D5), U2.7 (D5), U3.7 (D5), U6.7 (A6)
CD6: J1.9 (GP9), J8.7, R7.1, U1.8 (D6), U2.8 (D6), U3.8 (D6), U6.8 (A7)
CD7: J1.10 (GP10), J8.8, R8.1, U1.9 (D7), U2.9 (D7), U3.9 (D7), U6.9 (A8)
CIRAM_A10: J3.35 (C18), J8.26, R22.1, U8.3 (A2)
CIRAM_CE_N: J3.36 (C48), J8.27, R23.1, U8.4 (A3)
CLK_CA_HI: J8.30, U2.11 (CLK), U12.5 (1Y1)
CLK_CA_LO: J8.29, U1.11 (CLK), U12.4 (1Y0)
CLK_CTL: J8.31, U3.11 (CLK), U12.7 (1Y3)
CLK_PA_HI: J8.33, U5.11 (CLK), U12.11 (2Y1)
CLK_PA_LO: J8.32, U4.11 (CLK), U12.12 (2Y0)
CPU_ALE: J2.19, J8.18, R18.1, U9.1 (1A)
CPU_ALE_N: U9.2 (1Y), U10.3 (1CLK), U10.11 (2CLK), U12.1 (1G_N)
CPU_DIR: U6.1 (DIR), U9.8 (4Y)
CPU_RW: J3.27 (C14), J8.24, R40.1, U3.19 (Q0), U9.9 (4A)
CTL_SP5: J10.12, U3.14 (Q5)
CTL_SP6: J10.13, U3.13 (Q6)
CTL_SP7: J10.14, U3.12 (Q7)
CVBS: J6.1 (SIG), J7.1, R90.2, R91.2, R92.2
CVBS_B0: J2.15, R90.1
CVBS_B1: J2.14, R91.1
CVBS_B2: J2.12, R92.1
EXP_IN_SP1: R30.1, U14.5 (G)
EXP_IN_SP2: R31.1, U14.6 (H)
EXP_OUT0: J5.12, U16.15 (QA)
EXP_OUT1: J5.11, U16.1 (QB)
EXP_OUT2: J5.10, U16.2 (QC)
EXP_PAR_IN: J10.15, R45.1, SJ3.3 (B)
GND: C1.2, C2.2, C3.2, C10.2, C11.2, C12.2, C13.2, C14.2, C15.2, C16.2, C17.2, C18.2, C19.2, C20.2, C21.2, C22.2, C23.2, C24.2, C25.2, D1.1 (K), J1.3 (GP3), J1.8 (GP8), J1.13 (GP13), J1.18 (GP18), J2.3, J2.8, J2.13, J2.18, J3.1 (C1), J3.31 (C16), J5.0 (MH), J5.1, J6.2 (GND), J7.2, J8.37, J8.38, J8.39, J8.40, J9.39, J9.40, J10.16, R17.2, R18.2, R19.2, R22.2, R42.2, R43.2, R44.2, R94.2, R96.2, SW1.2, U1.10 (GND), U2.10 (GND), U3.10 (GND), U4.10 (GND), U5.10 (GND), U6.10 (GND), U7.10 (GND), U8.6 (A5), U8.7 (A6), U8.8 (A7), U8.9 (A8), U8.10 (GND), U9.7 (GND), U10.7 (GND), U11.7 (GND), U11.11 (2CLK), U11.12 (2D), U12.8 (GND), U12.13 (2B), U13.7 (GND), U13.13 (4B), U14.8 (GND), U14.15 (CLK_INH), U15.8 (GND), U15.10 (SER), U15.15 (CLK_INH), U16.8 (GND), U16.13 (OE_N)
IRQ_N: J3.29 (C15), J5.3, J8.25, R21.1, U8.2 (A1)
J4016_D1: J5.13, R29.1, U14.4 (F)
J4016_OE_N: J5.14, U16.3 (QD)
J4017_D0: J5.8, R24.1, U14.11 (A)
J4017_D1: J5.7, R25.1, U14.12 (B)
J4017_D2: J5.6, R26.1, U14.13 (C)
J4017_D3: J5.5, R27.1, U14.14 (D)
J4017_D4: J5.4, R28.1, U14.3 (E)
J4017_OE_N: J5.9, U16.4 (QE)
LED_A: D1.2 (A), R99.2
M2: J2.20, R17.1, U9.5 (3A), U13.12 (4A)
M2_CART: J3.4 (C32), J8.17, U13.11 (4Y)
M2_N: J8.34, U6.19 (OE_N), U9.6 (3Y), U10.1 (1CLR_N), U10.13 (2CLR_N), U13.10 (3B)
PA0: J3.49 (C25), J9.17, U4.19 (Q0)
PA1: J3.47 (C24), J9.18, U4.18 (Q1)
PA2: J3.45 (C23), J9.19, U4.17 (Q2)
PA3: J3.43 (C22), J9.20, U4.16 (Q3)
PA4: J3.41 (C21), J9.21, U4.15 (Q4)
PA5: J3.39 (C20), J9.22, U4.14 (Q5)
PA6: J3.37 (C19), J9.23, U4.13 (Q6)
PA7: J3.40 (C50), J9.24, U4.12 (Q7)
PA8: J3.42 (C51), J9.25, U5.19 (Q0)
PA9: J3.44 (C52), J9.26, U5.18 (Q1)
PA10: J3.46 (C53), J9.27, U5.17 (Q2)
PA11: J3.48 (C54), J9.28, U5.16 (Q3)
PA12: J3.50 (C55), J9.29, U5.15 (Q4)
PA13: J3.52 (C56), J9.30, U5.14 (Q5), U9.13 (6A)
PA13_N: J3.38 (C49), J9.31, U9.12 (6Y)
PD0: J1.11 (GP11), J8.9, R9.1, U4.2 (D0), U5.2 (D0), U7.2 (A1), U8.18 (Y1)
PD1: J1.12 (GP12), J8.10, R10.1, U4.3 (D1), U5.3 (D1), U7.3 (A2), U8.17 (Y2)
PD2: J1.14 (GP14), J8.11, R11.1, U4.4 (D2), U5.4 (D2), U7.4 (A3), U8.16 (Y3)
PD3: J1.15 (GP15), J8.12, R12.1, U4.5 (D3), U5.5 (D3), U7.5 (A4), U8.15 (Y4)
PD4: J1.16 (GP16), J8.13, R13.1, U4.6 (D4), U5.6 (D4), U7.6 (A5), U8.14 (Y5)
PD5: J1.17 (GP17), J8.14, R14.1, U4.7 (D5), U5.7 (D5), U7.7 (A6), U8.13 (Y6)
PD6: J1.19 (GP19), J8.15, R15.1, U4.8 (D6), U5.8 (D6), U7.8 (A7), U8.12 (Y7)
PD7: J1.20 (GP20), J8.16, R16.1, U4.9 (D7), U5.9 (D7), U7.9 (A8), U8.11 (Y8)
PH1: U10.5 (1Q), U10.12 (2D), U12.2 (1A)
PH2: U10.9 (2Q), U12.3 (1B)
PH2_N: U10.2 (1D), U10.8 (2Q_N)
PPH: U11.5 (1Q), U12.14 (2A)
PPH_N: U11.2 (1D), U11.6 (1Q_N)
PPU_ALE: J2.17, J8.19, R19.1, U9.3 (2A)
PPU_ALE_N: U9.4 (2Y), U11.3 (1CLK), U12.15 (2G_N)
PPU_RD_N: J3.33 (C17), J8.22, U13.3 (1Y)
PPU_STB_N: J2.16, J8.20, R20.1, U7.19 (OE_N), U9.11 (5A), U11.1 (1CLR_N), U13.1 (1A), U13.4 (2A)
PPU_WR_N: J3.34 (C47), J8.23, U13.6 (2Y)
PU_CPU: R1.2, R2.2, R3.2, R4.2, R5.2, R6.2, R7.2, R8.2, SJ1.1
PU_PPU: R9.2, R10.2, R11.2, R12.2, R13.2, R14.2, R15.2, R16.2, SJ2.1
RD_SEL_N: J9.32, U5.13 (Q6), U7.1 (DIR), U13.2 (1B)
ROMSEL_N: J3.28 (C44), J8.21, U13.8 (3Y)
SRO_SP6: J10.9, U16.5 (QF)
SRO_SP7: J10.10, U16.6 (QG)
SRO_SP8: J10.11, U16.7 (QH)
SRQ_MID: U14.10 (SER), U15.9 (QH)
SR_CLK: R42.1, U3.18 (Q1), U14.2 (CLK), U15.2 (CLK), U16.11 (SRCLK)
SR_IN9: J10.1, R32.1, U15.11 (A)
SR_IN10: J10.2, R33.1, U15.12 (B)
SR_IN11: J10.3, R34.1, U15.13 (C)
SR_IN12: J10.4, R35.1, U15.14 (D)
SR_IN13: J10.5, R36.1, U15.3 (E)
SR_IN14: J10.6, R37.1, U15.4 (F)
SR_IN15: J10.7, R38.1, U15.5 (G)
SR_IN16: J10.8, R39.1, U15.6 (H)
SR_LD: R43.1, U3.17 (Q2), U14.1 (SH_LD_N), U15.1 (SH_LD_N), U16.12 (RCLK)
SR_QH: SJ3.1 (A), U14.9 (QH)
SR_SER: R44.1, U3.16 (Q3), U16.14 (SER)
STATUS_SEL_N: J8.28, R41.1, U3.15 (Q4), U8.1 (OE1_N)
STAT_IN4: SJ3.2 (C), U8.5 (A4)
STB_ACT: J8.35, U8.19 (OE2_N), U9.10 (5Y)
VBUS: F1.1, J2.1
WR_SEL_N: J9.33, U5.12 (Q7), U13.5 (2B)
XCD0: J3.26 (C43), J9.34, U6.18 (B1)
XCD1: J3.24 (C42), U6.17 (B2)
XCD2: J3.22 (C41), U6.16 (B3)
XCD3: J3.20 (C40), U6.15 (B4)
XCD4: J3.18 (C39), U6.14 (B5)
XCD5: J3.16 (C38), U6.13 (B6)
XCD6: J3.14 (C37), U6.12 (B7)
XCD7: J3.12 (C36), U6.11 (B8)
XPD0: J3.51 (C26), J9.35, U7.18 (B1)
XPD1: J3.53 (C27), U7.17 (B2)
XPD2: J3.55 (C28), U7.16 (B3)
XPD3: J3.57 (C29), U7.15 (B4)
XPD4: J3.60 (C60), U7.14 (B5)
XPD5: J3.58 (C59), U7.13 (B6)
XPD6: J3.56 (C58), U7.12 (B7)
XPD7: J3.54 (C57), U7.11 (B8)

Notes on the sheet:
NESPICO Rev.B bench board - PROPOSAL, NOT REVIEWED. Functional label-per-pin schematic generated by gen_sch.py from design.py. Unverified: Famicom slot footprint/mechanics, DA-15 expansion pinout, RCA footprint, timing. See README.md.

Board: 2 copper layers, 106 parts (0 on the bottom side), 144 nets, no tracks yet.
