spaghetti-computer/lasagna/hardware/kicad/revc_lite/LASAGNA2354_Lite.kicad_pcb

## KiCad design hardware/kicad/revc_lite/LASAGNA2354_Lite.kicad_pcb (2026-11-04)

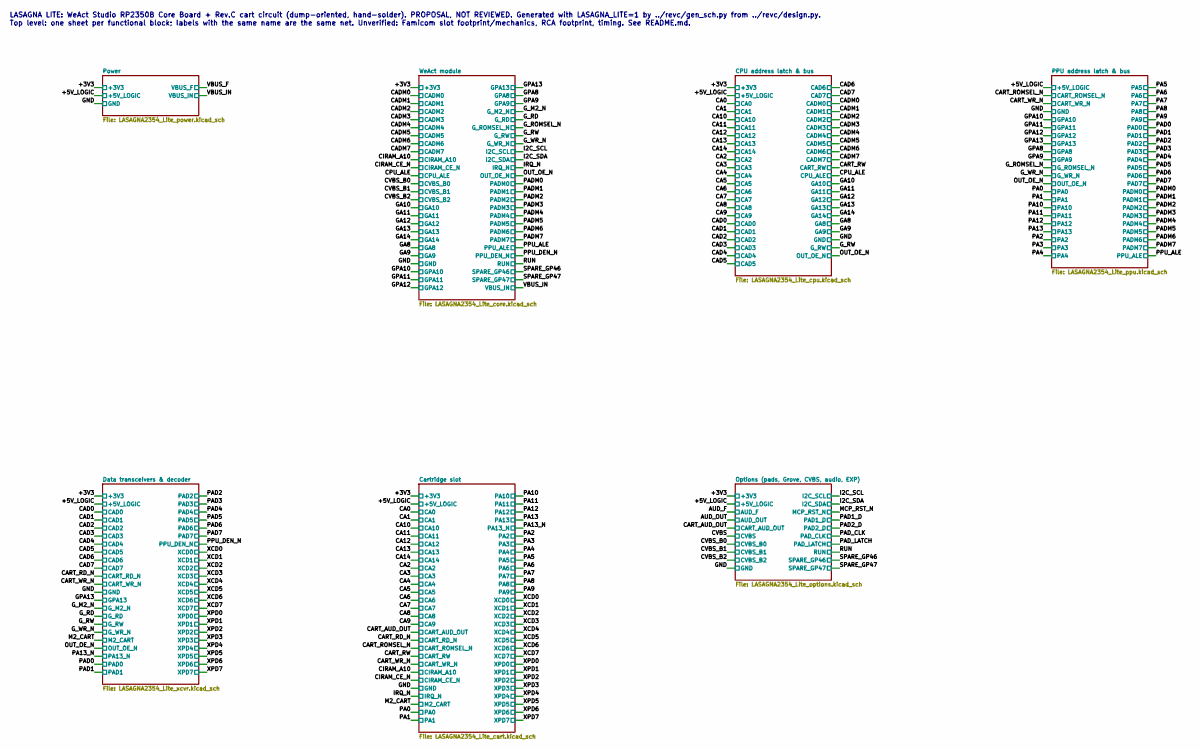
[picture p9: schematic LASAGNA2354_Lite.kicad_sch, LASAGNA LITE (WeAct RP2350B) board (proposal) - top level]

Notes on the sheet:
LASAGNA LITE: WeAct Studio RP2350B Core Board + Rev.C cart circuit (dump-oriented, hand-solder). PROPOSAL, NOT REVIEWED. Generated with LASAGNA_LITE=1 by ../revc/gen_sch.py from ../revc/design.py. Top level: one sheet per functional block; labels with the same name are the same net. Unverified: Fam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

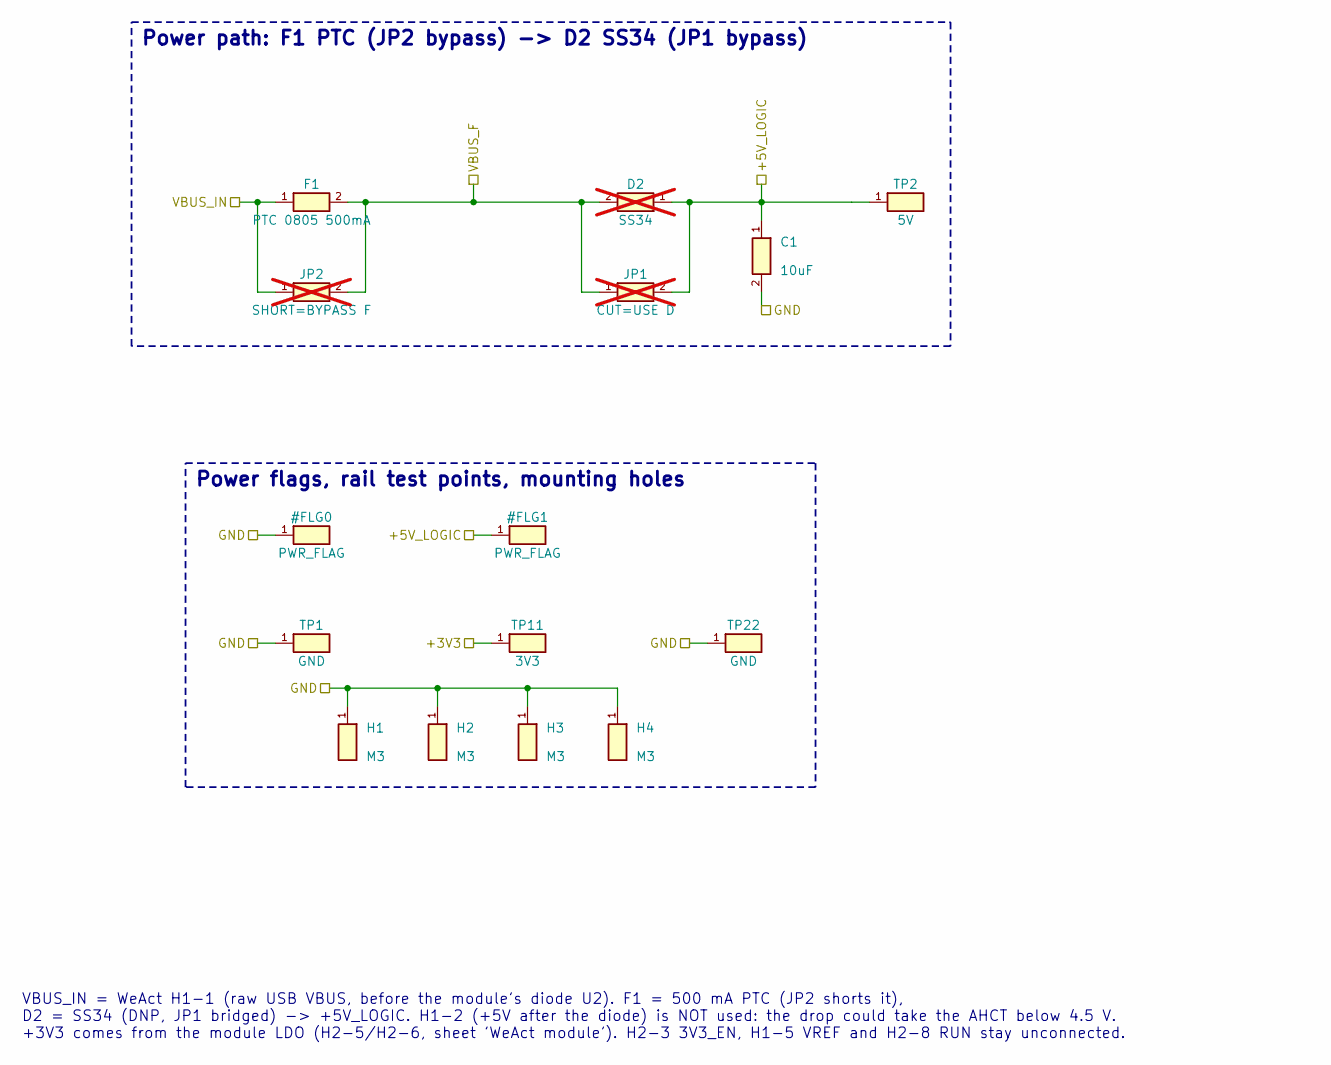
[picture p10: schematic LASAGNA2354_Lite_power.kicad_sch, LASAGNA LITE - Power]

Parts:
C1: 10uF; C_0805_2012Metric; MPN 10uF; LCSC C15850
D2: SS34; D_SMA; MPN SS34; LCSC C8678; not fitted
F1: PTC 0805 500mA; Fuse_0805_2012Metric; MPN SMD0805-050; LCSC C66452
H1, H2, H3, H4: M3; MountingHole_3.2mm_M3_Pad; LCSC_Status no LCSC part
JP1: CUT=USE D; SolderJumper-2_P1.3mm_Bridged_RoundedPad1.0x1.5mm; LCSC_Status hand-assembly / not PCBA; not fitted
JP2: SHORT=BYPASS F; SolderJumper-2_P1.3mm_Open_RoundedPad1.0x1.5mm; LCSC_Status hand-assembly / not PCBA; not fitted
TP1, TP22: GND; TestPoint_THTPad_D2.0mm_Drill1.0mm; LCSC_Status no LCSC part
TP2: 5V; TestPoint_THTPad_D2.0mm_Drill1.0mm; LCSC_Status no LCSC part
TP11: 3V3; TestPoint_THTPad_D2.0mm_Drill1.0mm; LCSC_Status no LCSC part

Connections:
/+3V3: TP11.1; also elsewhere on the board
/+5V_LOGIC: C1.1, D2.1 (K), JP1.2, TP2.1; also elsewhere on the board
/GND: C1.2, H1.1, H2.1, H3.1, H4.1, TP1.1, TP22.1; also elsewhere on the board
/VBUS_F: D2.2 (A), F1.2, JP1.1, JP2.2
/VBUS_IN: F1.1, JP2.1; also elsewhere on the board

Notes on the sheet:
VBUS_IN = WeAct H1-1 (raw USB VBUS, before the module's diode U2). F1 = 500 mA PTC (JP2 shorts it), D2 = SS34 (DNP, JP1 bridged) -> +5V_LOGIC. H1-2 (+5V after the diode) is NOT used: the drop could take the AHCT below 4.5 V. +3V3 comes from the module LDO (H2-5/H2-6, sheet 'WeAct module'). H2-3 3V3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
Power path: F1 PTC (JP2 bypass) -> D2 SS34 (JP1 bypass)
Power flags, rail test points, mounting holes
