spaghetti-computer/lasagna/hardware/kicad/revc_lite/LASAGNA2354_Lite.kicad_pcb

## KiCad design hardware/kicad/revc_lite/LASAGNA2354_Lite.kicad_pcb (continued)

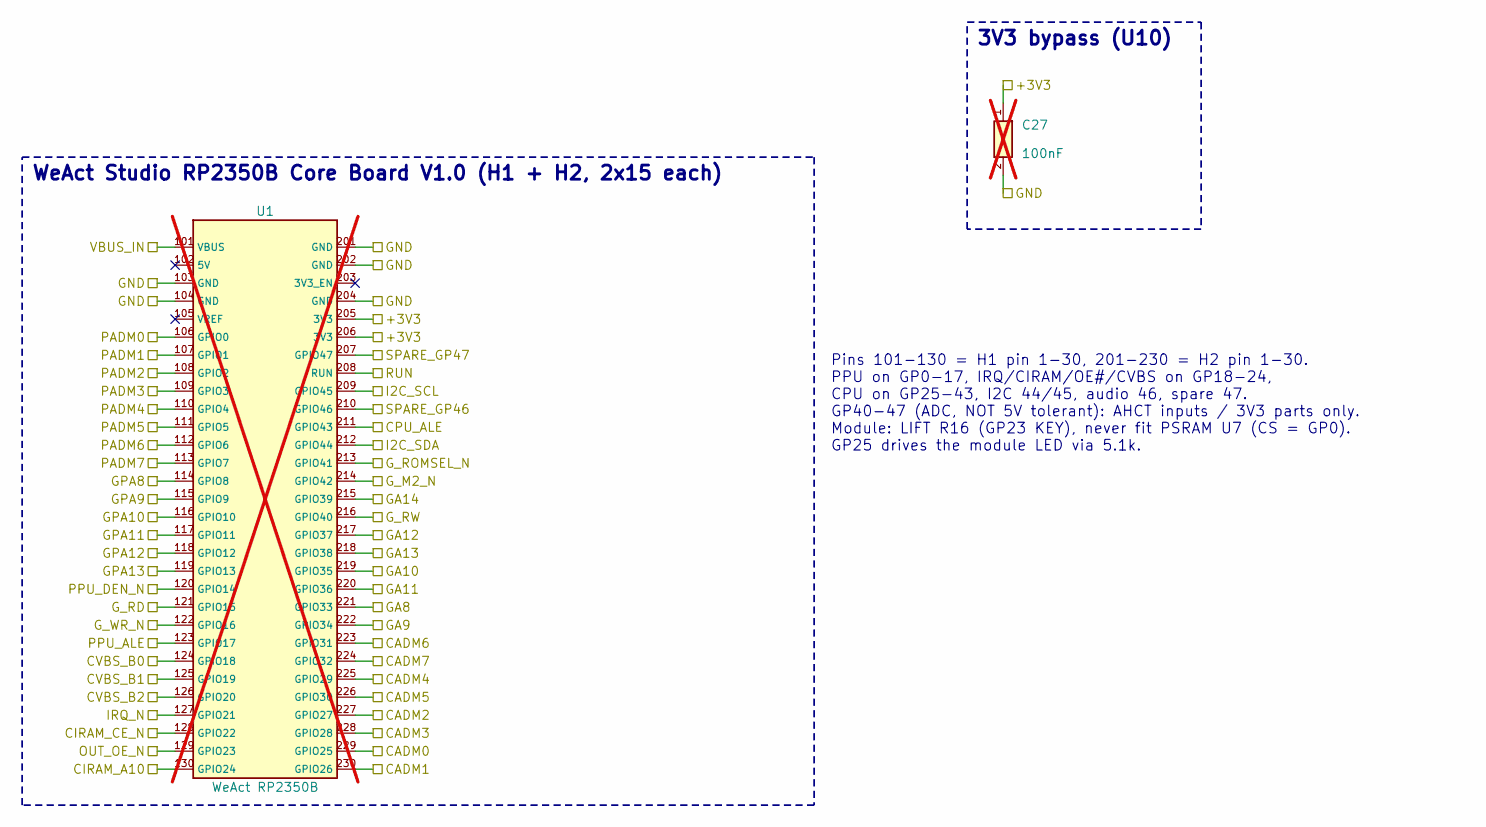
[picture p11: schematic LASAGNA2354_Lite_core.kicad_sch, LASAGNA LITE - WeAct module]

Parts:
C27: 100nF; C_0603_1608Metric; MPN 100nF; LCSC C14663; not fitted
U1: WeAct RP2350B; WeAct_RP2350B_CoreBoard; MPN WeAct RP2350B Core Board V1.0; LCSC_Status hand-assembly / not PCBA; not fitted

Connections:
/+3V3: C27.1, U1.205 (3V3), U1.206 (3V3); also elsewhere on the board
/CADM0: U1.229 (GPIO25); also elsewhere on the board
/CADM1: U1.230 (GPIO26); also elsewhere on the board
/CADM2: U1.227 (GPIO27); also elsewhere on the board
/CADM3: U1.228 (GPIO28); also elsewhere on the board
/CADM4: U1.225 (GPIO29); also elsewhere on the board
/CADM5: U1.226 (GPIO30); also elsewhere on the board
/CADM6: U1.223 (GPIO31); also elsewhere on the board
/CADM7: U1.224 (GPIO32); also elsewhere on the board
/CIRAM_A10: U1.130 (GPIO24); also elsewhere on the board
/CIRAM_CE_N: U1.128 (GPIO22); also elsewhere on the board
/CPU_ALE: U1.211 (GPIO43); also elsewhere on the board
/CVBS_B0: U1.124 (GPIO18); also elsewhere on the board
/CVBS_B1: U1.125 (GPIO19); also elsewhere on the board
/CVBS_B2: U1.126 (GPIO20); also elsewhere on the board
/GA8: U1.221 (GPIO33); also elsewhere on the board
/GA9: U1.222 (GPIO34); also elsewhere on the board
/GA10: U1.219 (GPIO35); also elsewhere on the board
/GA11: U1.220 (GPIO36); also elsewhere on the board
/GA12: U1.217 (GPIO37); also elsewhere on the board
/GA13: U1.218 (GPIO38); also elsewhere on the board
/GA14: U1.215 (GPIO39); also elsewhere on the board
/GND: C27.2, U1.103 (GND), U1.104 (GND), U1.201 (GND), U1.202 (GND), U1.204 (GND); also elsewhere on the board
/GPA8: U1.114 (GPIO8); also elsewhere on the board
/GPA9: U1.115 (GPIO9); also elsewhere on the board
/GPA10: U1.116 (GPIO10); also elsewhere on the board
/GPA11: U1.117 (GPIO11); also elsewhere on the board
/GPA12: U1.118 (GPIO12); also elsewhere on the board
/GPA13: U1.119 (GPIO13); also elsewhere on the board
/G_M2_N: U1.214 (GPIO42); also elsewhere on the board
/G_RD: U1.121 (GPIO15); also elsewhere on the board
/G_ROMSEL_N: U1.213 (GPIO41); also elsewhere on the board
/G_RW: U1.216 (GPIO40); also elsewhere on the board
/G_WR_N: U1.122 (GPIO16); also elsewhere on the board
/I2C_SCL: U1.209 (GPIO45); also elsewhere on the board
/I2C_SDA: U1.212 (GPIO44); also elsewhere on the board
/IRQ_N: U1.127 (GPIO21); also elsewhere on the board
/OUT_OE_N: U1.129 (GPIO23); also elsewhere on the board
/PADM0: U1.106 (GPIO0); also elsewhere on the board
/PADM1: U1.107 (GPIO1); also elsewhere on the board
/PADM2: U1.108 (GPIO2); also elsewhere on the board
/PADM3: U1.109 (GPIO3); also elsewhere on the board
/PADM4: U1.110 (GPIO4); also elsewhere on the board
/PADM5: U1.111 (GPIO5); also elsewhere on the board
/PADM6: U1.112 (GPIO6); also elsewhere on the board
/PADM7: U1.113 (GPIO7); also elsewhere on the board
/PPU_ALE: U1.123 (GPIO17); also elsewhere on the board
/PPU_DEN_N: U1.120 (GPIO14); also elsewhere on the board
/RUN: U1.208 (RUN); also elsewhere on the board
/SPARE_GP46: U1.210 (GPIO46); also elsewhere on the board
/SPARE_GP47: U1.207 (GPIO47); also elsewhere on the board
/VBUS_IN: U1.101 (VBUS); also elsewhere on the board

Notes on the sheet:
Pins 101-130 = H1 pin 1-30, 201-230 = H2 pin 1-30. PPU on GP0-17, IRQ/CIRAM/OE#/CVBS on GP18-24, CPU on GP25-43, I2C 44/45, audio 46, spare 47. GP40-47 (ADC, NOT 5V tolerant): AHCT inputs / 3V3 parts only. Module: LIFT R16 (GP23 KEY), never fit PSRAM U7 (CS = GP0). GP25 drives the module LED via 5.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
WeAct Studio RP2350B Core Board V1.0 (H1 + H2, 2x15 each)
3V3 bypass (U10)

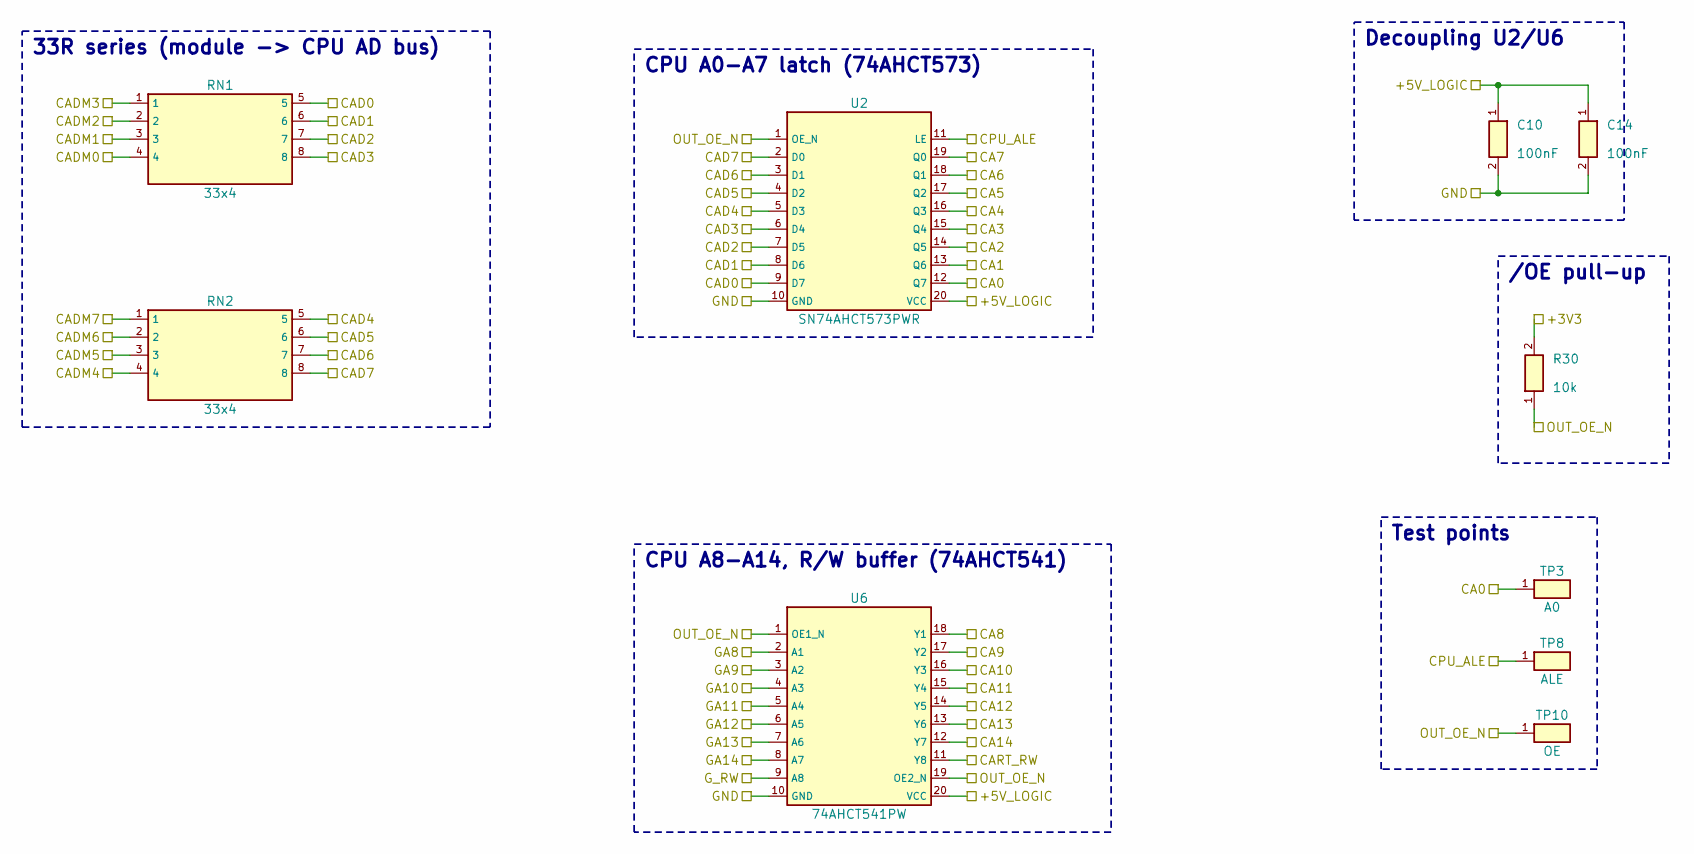
[picture p12: schematic LASAGNA2354_Lite_cpu.kicad_sch, LASAGNA LITE - CPU address latch & bus]

Parts:
C10, C14: 100nF; C_0603_1608Metric; MPN 100nF; LCSC C14663
R30: 10k; R_0603_1608Metric; MPN 10k; LCSC C25804
RN1, RN2: 33x4; R_Array_Convex_4x0603; MPN 4D03WGJ0330T5E; LCSC C25508
TP3: A0; TestPoint_THTPad_D2.0mm_Drill1.0mm; LCSC_Status no LCSC part
TP8: ALE; TestPoint_THTPad_D2.0mm_Drill1.0mm; LCSC_Status no LCSC part
TP10: OE; TestPoint_THTPad_D2.0mm_Drill1.0mm; LCSC_Status no LCSC part
U2: SN74AHCT573PWR; TSSOP-20_4.4x6.5mm_P0.65mm; MPN SN74AHCT573PWR; LCSC C141311
U6: 74AHCT541PW; TSSOP-20_4.4x6.5mm_P0.65mm; MPN 74AHCT541PW,118; LCSC C84548

Connections:
/+3V3: R30.2; also elsewhere on the board
/+5V_LOGIC: C10.1, C14.1, U2.20 (VCC), U6.20 (VCC); also elsewhere on the board
/CA0: TP3.1, U2.12 (Q7); also elsewhere on the board
/CA1: U2.13 (Q6); also elsewhere on the board
/CA2: U2.14 (Q5); also elsewhere on the board
/CA3: U2.15 (Q4); also elsewhere on the board
/CA4: U2.16 (Q3); also elsewhere on the board
/CA5: U2.17 (Q2); also elsewhere on the board
/CA6: U2.18 (Q1); also elsewhere on the board
/CA7: U2.19 (Q0); also elsewhere on the board
/CA8: U6.18 (Y1); also elsewhere on the board
/CA9: U6.17 (Y2); also elsewhere on the board
/CA10: U6.16 (Y3); also elsewhere on the board
/CA11: U6.15 (Y4); also elsewhere on the board
/CA12: U6.14 (Y5); also elsewhere on the board
/CA13: U6.13 (Y6); also elsewhere on the board
/CA14: U6.12 (Y7); also elsewhere on the board
/CAD0: RN1.5, U2.9 (D7); also elsewhere on the board
/CAD1: RN1.6, U2.8 (D6); also elsewhere on the board
/CAD2: RN1.7, U2.7 (D5); also elsewhere on the board
/CAD3: RN1.8, U2.6 (D4); also elsewhere on the board
/CAD4: RN2.5, U2.5 (D3); also elsewhere on the board
/CAD5: RN2.6, U2.4 (D2); also elsewhere on the board
/CAD6: RN2.7, U2.3 (D1); also elsewhere on the board
/CAD7: RN2.8, U2.2 (D0); also elsewhere on the board
/CADM0: RN1.4; also elsewhere on the board
/CADM1: RN1.3; also elsewhere on the board
/CADM2: RN1.2; also elsewhere on the board
/CADM3: RN1.1; also elsewhere on the board
/CADM4: RN2.4; also elsewhere on the board
/CADM5: RN2.3; also elsewhere on the board
/CADM6: RN2.2; also elsewhere on the board
/CADM7: RN2.1; also elsewhere on the board
/CART_RW: U6.11 (Y8); also elsewhere on the board
/CPU_ALE: TP8.1, U2.11 (LE); also elsewhere on the board
/GA8: U6.2 (A1); also elsewhere on the board
/GA9: U6.3 (A2); also elsewhere on the board
/GA10: U6.4 (A3); also elsewhere on the board
/GA11: U6.5 (A4); also elsewhere on the board
/GA12: U6.6 (A5); also elsewhere on the board
/GA13: U6.7 (A6); also elsewhere on the board
/GA14: U6.8 (A7); also elsewhere on the board
/GND: C10.2, C14.2, U2.10 (GND), U6.10 (GND); also elsewhere on the board
/G_RW: U6.9 (A8); also elsewhere on the board
/OUT_OE_N: R30.1, TP10.1, U2.1 (OE_N), U6.1 (OE1_N), U6.19 (OE2_N); also elsewhere on the board

Notes on the sheet:
33R series (module -> CPU AD bus)
CPU A0-A7 latch (74AHCT573)
CPU A8-A14, R/W buffer (74AHCT541)
Decoupling U2/U6
/OE pull-up
Test points

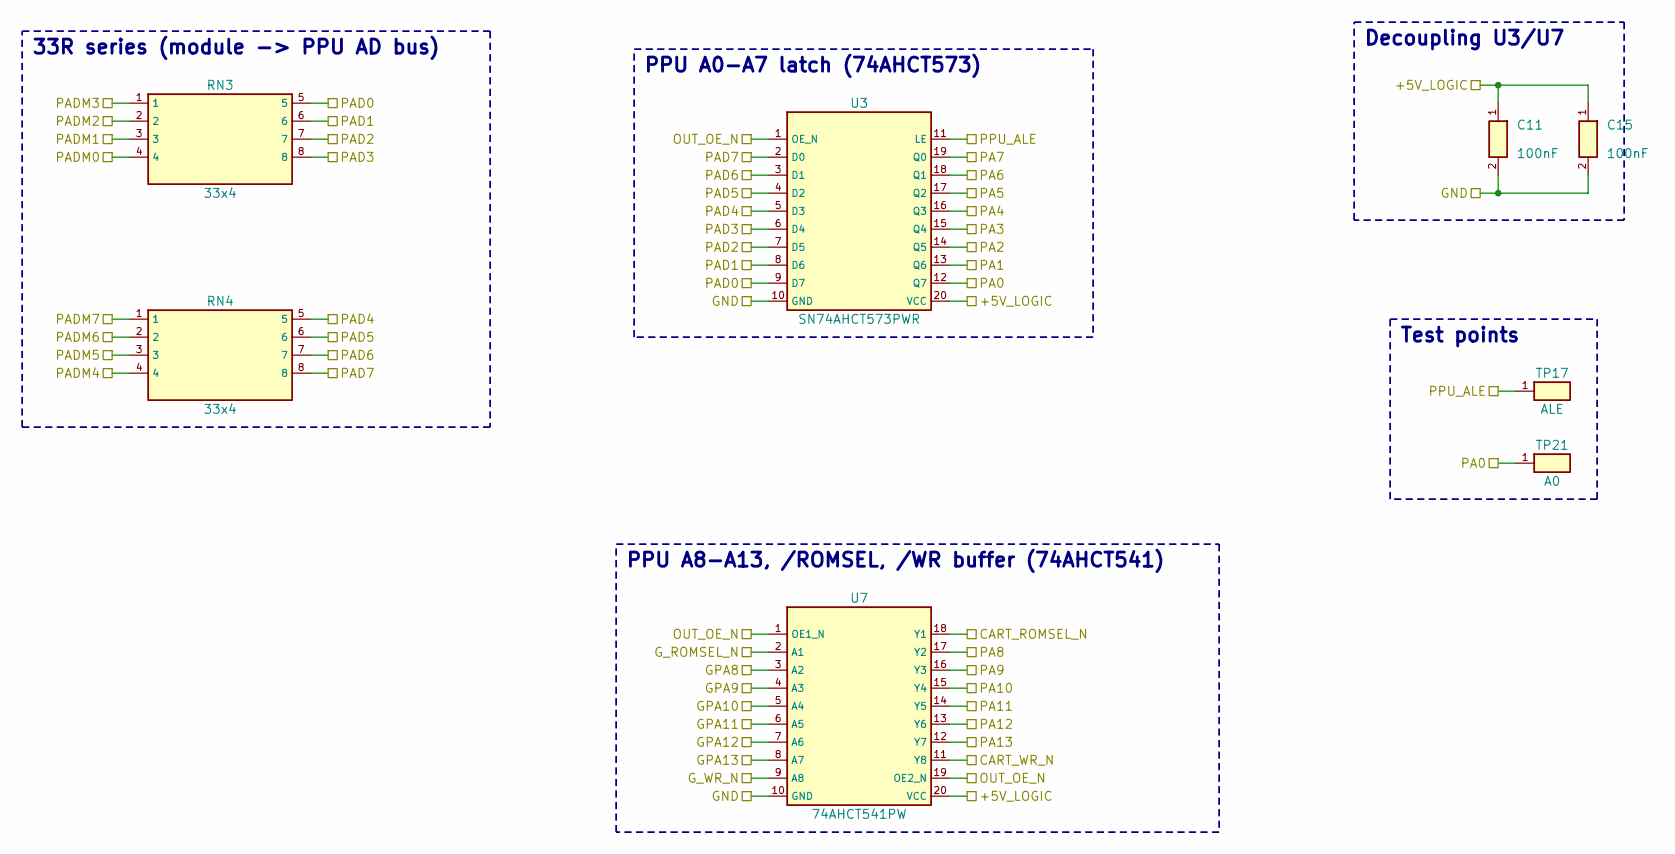
[picture p13: schematic LASAGNA2354_Lite_ppu.kicad_sch, LASAGNA LITE - PPU address latch & bus]

Parts:
C11, C15: 100nF; C_0603_1608Metric; MPN 100nF; LCSC C14663
RN3, RN4: 33x4; R_Array_Convex_4x0603; MPN 4D03WGJ0330T5E; LCSC C25508
TP17: ALE; TestPoint_THTPad_D2.0mm_Drill1.0mm; LCSC_Status no LCSC part
TP21: A0; TestPoint_THTPad_D2.0mm_Drill1.0mm; LCSC_Status no LCSC part
U3: SN74AHCT573PWR; TSSOP-20_4.4x6.5mm_P0.65mm; MPN SN74AHCT573PWR; LCSC C141311
U7: 74AHCT541PW; TSSOP-20_4.4x6.5mm_P0.65mm; MPN 74AHCT541PW,118; LCSC C84548

Connections:
/+5V_LOGIC: C11.1, C15.1, U3.20 (VCC), U7.20 (VCC); also elsewhere on the board
/CART_ROMSEL_N: U7.18 (Y1); also elsewhere on the board
/CART_WR_N: U7.11 (Y8); also elsewhere on the board
/GND: C11.2, C15.2, U3.10 (GND), U7.10 (GND); also elsewhere on the board
/GPA8: U7.3 (A2); also elsewhere on the board
/GPA9: U7.4 (A3); also elsewhere on the board
/GPA10: U7.5 (A4); also elsewhere on the board
/GPA11: U7.6 (A5); also elsewhere on the board
/GPA12: U7.7 (A6); also elsewhere on the board
/GPA13: U7.8 (A7); also elsewhere on the board
/G_ROMSEL_N: U7.2 (A1); also elsewhere on the board
/G_WR_N: U7.9 (A8); also elsewhere on the board
/OUT_OE_N: U3.1 (OE_N), U7.1 (OE1_N), U7.19 (OE2_N); also elsewhere on the board
/PA0: TP21.1, U3.12 (Q7); also elsewhere on the board
/PA1: U3.13 (Q6); also elsewhere on the board
/PA2: U3.14 (Q5); also elsewhere on the board
/PA3: U3.15 (Q4); also elsewhere on the board
/PA4: U3.16 (Q3); also elsewhere on the board
/PA5: U3.17 (Q2); also elsewhere on the board
/PA6: U3.18 (Q1); also elsewhere on the board
/PA7: U3.19 (Q0); also elsewhere on the board
/PA8: U7.17 (Y2); also elsewhere on the board
/PA9: U7.16 (Y3); also elsewhere on the board
/PA10: U7.15 (Y4); also elsewhere on the board
/PA11: U7.14 (Y5); also elsewhere on the board
/PA12: U7.13 (Y6); also elsewhere on the board
/PA13: U7.12 (Y7); also elsewhere on the board
/PAD0: RN3.5, U3.9 (D7); also elsewhere on the board
/PAD1: RN3.6, U3.8 (D6); also elsewhere on the board
/PAD2: RN3.7, U3.7 (D5); also elsewhere on the board
/PAD3: RN3.8, U3.6 (D4); also elsewhere on the board
/PAD4: RN4.5, U3.5 (D3); also elsewhere on the board
/PAD5: RN4.6, U3.4 (D2); also elsewhere on the board
/PAD6: RN4.7, U3.3 (D1); also elsewhere on the board
/PAD7: RN4.8, U3.2 (D0); also elsewhere on the board
/PADM0: RN3.4; also elsewhere on the board
/PADM1: RN3.3; also elsewhere on the board
/PADM2: RN3.2; also elsewhere on the board
/PADM3: RN3.1; also elsewhere on the board
/PADM4: RN4.4; also elsewhere on the board
/PADM5: RN4.3; also elsewhere on the board
/PADM6: RN4.2; also elsewhere on the board
/PADM7: RN4.1; also elsewhere on the board
/PPU_ALE: TP17.1, U3.11 (LE); also elsewhere on the board

Notes on the sheet:
33R series (module -> PPU AD bus)
PPU A0-A7 latch (74AHCT573)
PPU A8-A13, /ROMSEL, /WR buffer (74AHCT541)
Decoupling U3/U7
Test points

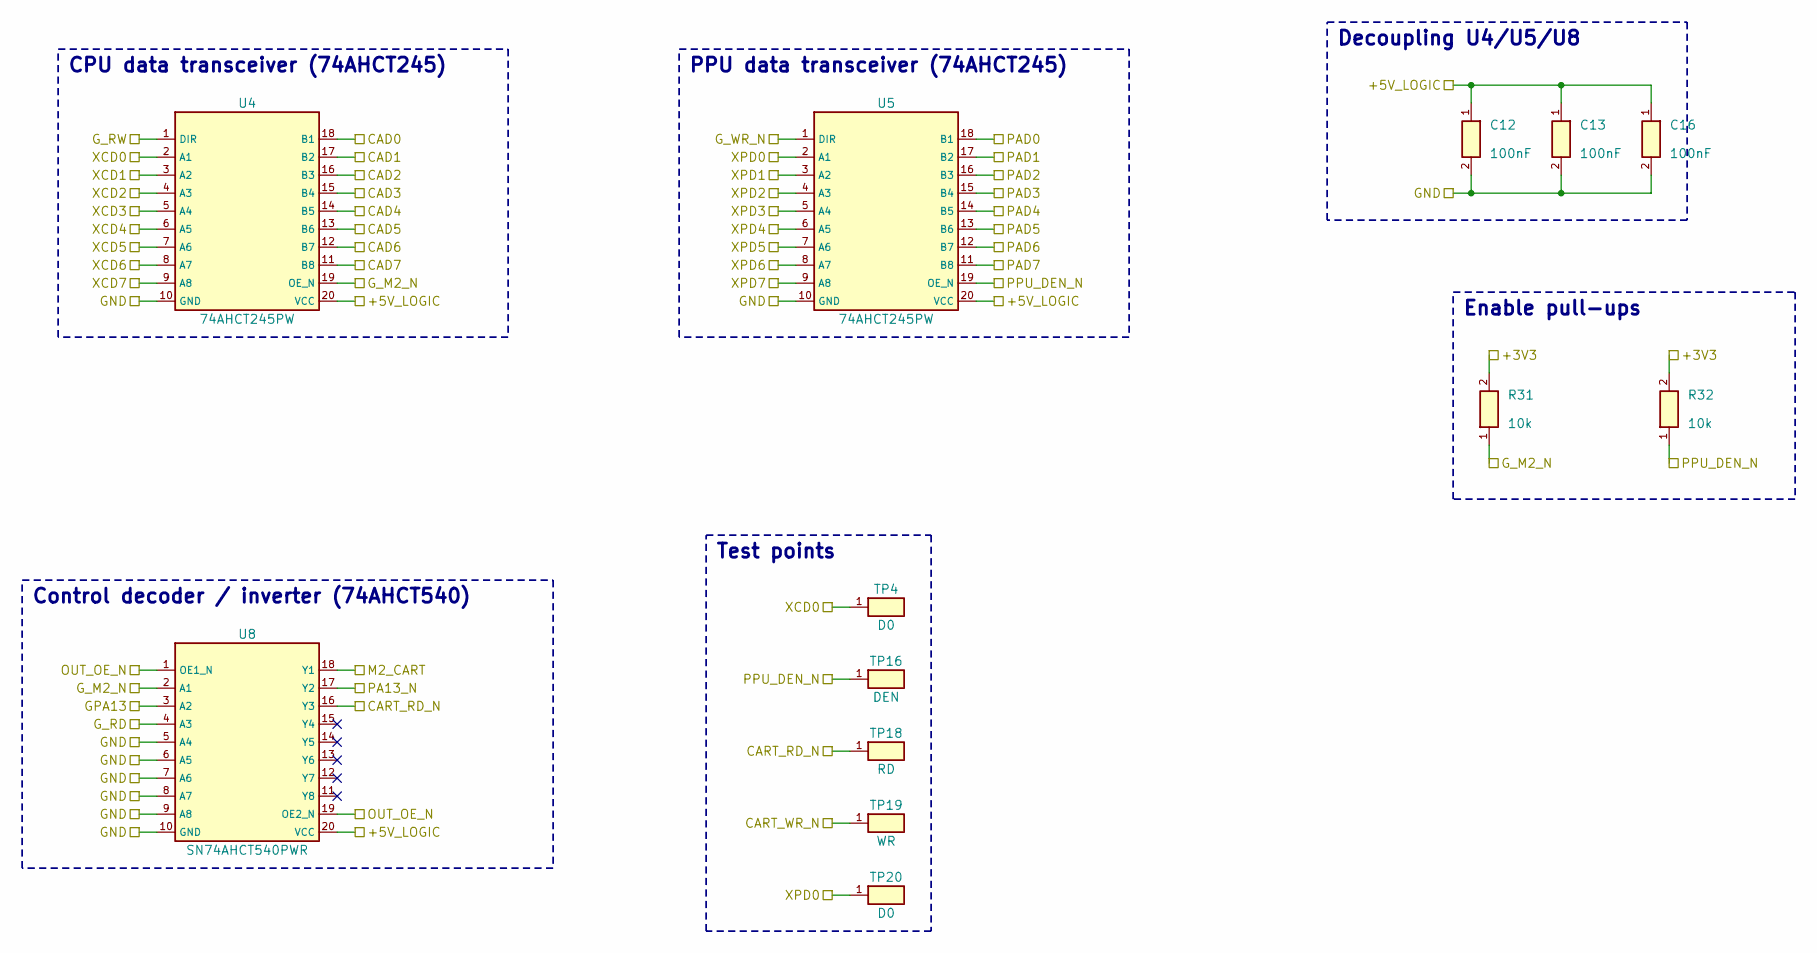
[picture p14: schematic LASAGNA2354_Lite_xcvr.kicad_sch, LASAGNA LITE - Data transceivers & decoder]

Parts:
C12, C13, C16: 100nF; C_0603_1608Metric; MPN 100nF; LCSC C14663
R31, R32: 10k; R_0603_1608Metric; MPN 10k; LCSC C25804
TP4, TP20: D0; TestPoint_THTPad_D2.0mm_Drill1.0mm; LCSC_Status no LCSC part
TP16: DEN; TestPoint_THTPad_D2.0mm_Drill1.0mm; LCSC_Status no LCSC part
TP18: RD; TestPoint_THTPad_D2.0mm_Drill1.0mm; LCSC_Status no LCSC part
TP19: WR; TestPoint_THTPad_D2.0mm_Drill1.0mm; LCSC_Status no LCSC part
U4, U5: 74AHCT245PW; TSSOP-20_4.4x6.5mm_P0.65mm; MPN 74AHCT245PW,118; LCSC C173388
U8: SN74AHCT540PWR; TSSOP-20_4.4x6.5mm_P0.65mm; MPN SN74AHCT540PWR; LCSC C7626

Connections:
/+3V3: R31.2, R32.2; also elsewhere on the board
/+5V_LOGIC: C12.1, C13.1, C16.1, U4.20 (VCC), U5.20 (VCC), U8.20 (VCC); also elsewhere on the board
/CAD0: U4.18 (B1); also elsewhere on the board
/CAD1: U4.17 (B2); also elsewhere on the board
/CAD2: U4.16 (B3); also elsewhere on the board
/CAD3: U4.15 (B4); also elsewhere on the board
/CAD4: U4.14 (B5); also elsewhere on the board
/CAD5: U4.13 (B6); also elsewhere on the board
/CAD6: U4.12 (B7); also elsewhere on the board
/CAD7: U4.11 (B8); also elsewhere on the board
/CART_RD_N: TP18.1, U8.16 (Y3); also elsewhere on the board
/CART_WR_N: TP19.1; also elsewhere on the board
/GND: C12.2, C13.2, C16.2, U4.10 (GND), U5.10 (GND), U8.5 (A4), U8.6 (A5), U8.7 (A6), U8.8 (A7), U8.9 (A8), U8.10 (GND); also elsewhere on the board
/GPA13: U8.3 (A2); also elsewhere on the board
/G_M2_N: R31.1, U4.19 (OE_N), U8.2 (A1); also elsewhere on the board
/G_RD: U8.4 (A3); also elsewhere on the board
/G_RW: U4.1 (DIR); also elsewhere on the board
/G_WR_N: U5.1 (DIR); also elsewhere on the board
/M2_CART: U8.18 (Y1); also elsewhere on the board
/OUT_OE_N: U8.1 (OE1_N), U8.19 (OE2_N); also elsewhere on the board
/PA13_N: U8.17 (Y2); also elsewhere on the board
/PAD0: U5.18 (B1); also elsewhere on the board
/PAD1: U5.17 (B2); also elsewhere on the board
/PAD2: U5.16 (B3); also elsewhere on the board
/PAD3: U5.15 (B4); also elsewhere on the board
/PAD4: U5.14 (B5); also elsewhere on the board
/PAD5: U5.13 (B6); also elsewhere on the board
/PAD6: U5.12 (B7); also elsewhere on the board
/PAD7: U5.11 (B8); also elsewhere on the board
/PPU_DEN_N: R32.1, TP16.1, U5.19 (OE_N); also elsewhere on the board
/XCD0: TP4.1, U4.2 (A1); also elsewhere on the board
/XCD1: U4.3 (A2); also elsewhere on the board
/XCD2: U4.4 (A3); also elsewhere on the board
/XCD3: U4.5 (A4); also elsewhere on the board
/XCD4: U4.6 (A5); also elsewhere on the board
/XCD5: U4.7 (A6); also elsewhere on the board
/XCD6: U4.8 (A7); also elsewhere on the board
/XCD7: U4.9 (A8); also elsewhere on the board
/XPD0: TP20.1, U5.2 (A1); also elsewhere on the board
/XPD1: U5.3 (A2); also elsewhere on the board
/XPD2: U5.4 (A3); also elsewhere on the board
/XPD3: U5.5 (A4); also elsewhere on the board
/XPD4: U5.6 (A5); also elsewhere on the board
/XPD5: U5.7 (A6); also elsewhere on the board
/XPD6: U5.8 (A7); also elsewhere on the board
/XPD7: U5.9 (A8); also elsewhere on the board

Notes on the sheet:
CPU data transceiver (74AHCT245)
PPU data transceiver (74AHCT245)
Control decoder / inverter (74AHCT540)
Decoupling U4/U5/U8
Enable pull-ups
Test points

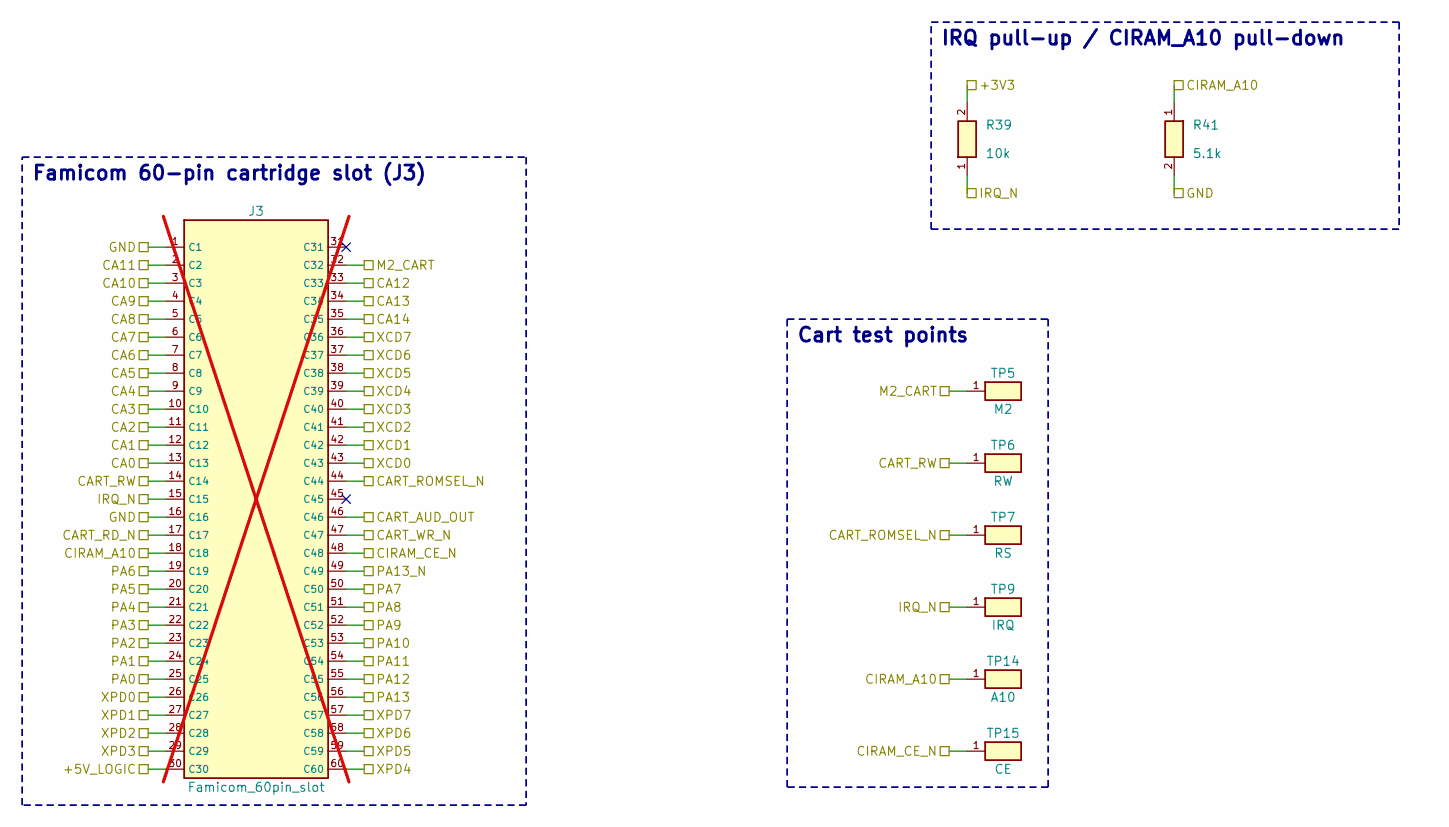
[picture p15: schematic LASAGNA2354_Lite_cart.kicad_sch, LASAGNA LITE - Cartridge slot]

Parts:
J3: Famicom_60pin_slot; Hirose_CR22A-60D-2.54DS; MPN CR22A-60D-2.54DS(70); LCSC_Status hand-assembly / not PCBA; not fitted
R39: 10k; R_0603_1608Metric; MPN 10k; LCSC C25804
R41: 5.1k; R_0603_1608Metric; MPN 5.1k; LCSC C23186
TP5: M2; TestPoint_THTPad_D2.0mm_Drill1.0mm; LCSC_Status no LCSC part
TP6: RW; TestPoint_THTPad_D2.0mm_Drill1.0mm; LCSC_Status no LCSC part
TP7: RS; TestPoint_THTPad_D2.0mm_Drill1.0mm; LCSC_Status no LCSC part
TP9: IRQ; TestPoint_THTPad_D2.0mm_Drill1.0mm; LCSC_Status no LCSC part
TP14: A10; TestPoint_THTPad_D2.0mm_Drill1.0mm; LCSC_Status no LCSC part
TP15: CE; TestPoint_THTPad_D2.0mm_Drill1.0mm; LCSC_Status no LCSC part

Connections:
/+3V3: R39.2; also elsewhere on the board
/+5V_LOGIC: J3.30 (C30); also elsewhere on the board
/CA0: J3.13 (C13); also elsewhere on the board
/CA1: J3.12 (C12); also elsewhere on the board
/CA2: J3.11 (C11); also elsewhere on the board
/CA3: J3.10 (C10); also elsewhere on the board
/CA4: J3.9 (C9); also elsewhere on the board
/CA5: J3.8 (C8); also elsewhere on the board
/CA6: J3.7 (C7); also elsewhere on the board
/CA7: J3.6 (C6); also elsewhere on the board
/CA8: J3.5 (C5); also elsewhere on the board
/CA9: J3.4 (C4); also elsewhere on the board
/CA10: J3.3 (C3); also elsewhere on the board
/CA11: J3.2 (C2); also elsewhere on the board
/CA12: J3.33 (C33); also elsewhere on the board
/CA13: J3.34 (C34); also elsewhere on the board
/CA14: J3.35 (C35); also elsewhere on the board
/CART_AUD_OUT: J3.46 (C46); also elsewhere on the board
/CART_RD_N: J3.17 (C17); also elsewhere on the board
/CART_ROMSEL_N: J3.44 (C44), TP7.1; also elsewhere on the board
/CART_RW: J3.14 (C14), TP6.1; also elsewhere on the board
/CART_WR_N: J3.47 (C47); also elsewhere on the board
/CIRAM_A10: J3.18 (C18), R41.1, TP14.1; also elsewhere on the board
/CIRAM_CE_N: J3.48 (C48), TP15.1; also elsewhere on the board
/GND: J3.1 (C1), J3.16 (C16), R41.2; also elsewhere on the board
/IRQ_N: J3.15 (C15), R39.1, TP9.1; also elsewhere on the board
/M2_CART: J3.32 (C32), TP5.1; also elsewhere on the board
/PA0: J3.25 (C25); also elsewhere on the board
/PA1: J3.24 (C24); also elsewhere on the board
/PA2: J3.23 (C23); also elsewhere on the board
/PA3: J3.22 (C22); also elsewhere on the board
/PA4: J3.21 (C21); also elsewhere on the board
/PA5: J3.20 (C20); also elsewhere on the board
/PA6: J3.19 (C19); also elsewhere on the board
/PA7: J3.50 (C50); also elsewhere on the board
/PA8: J3.51 (C51); also elsewhere on the board
/PA9: J3.52 (C52); also elsewhere on the board
/PA10: J3.53 (C53); also elsewhere on the board
/PA11: J3.54 (C54); also elsewhere on the board
/PA12: J3.55 (C55); also elsewhere on the board
/PA13: J3.56 (C56); also elsewhere on the board
/PA13_N: J3.49 (C49); also elsewhere on the board
/XCD0: J3.43 (C43); also elsewhere on the board
/XCD1: J3.42 (C42); also elsewhere on the board
/XCD2: J3.41 (C41); also elsewhere on the board
/XCD3: J3.40 (C40); also elsewhere on the board
/XCD4: J3.39 (C39); also elsewhere on the board
/XCD5: J3.38 (C38); also elsewhere on the board
/XCD6: J3.37 (C37); also elsewhere on the board
/XCD7: J3.36 (C36); also elsewhere on the board
/XPD0: J3.26 (C26); also elsewhere on the board
/XPD1: J3.27 (C27); also elsewhere on the board
/XPD2: J3.28 (C28); also elsewhere on the board
/XPD3: J3.29 (C29); also elsewhere on the board
/XPD4: J3.60 (C60); also elsewhere on the board
/XPD5: J3.59 (C59); also elsewhere on the board
/XPD6: J3.58 (C58); also elsewhere on the board
/XPD7: J3.57 (C57); also elsewhere on the board

Notes on the sheet:
Famicom 60-pin cartridge slot (J3)
IRQ pull-up / CIRAM_A10 pull-down
Cart test points

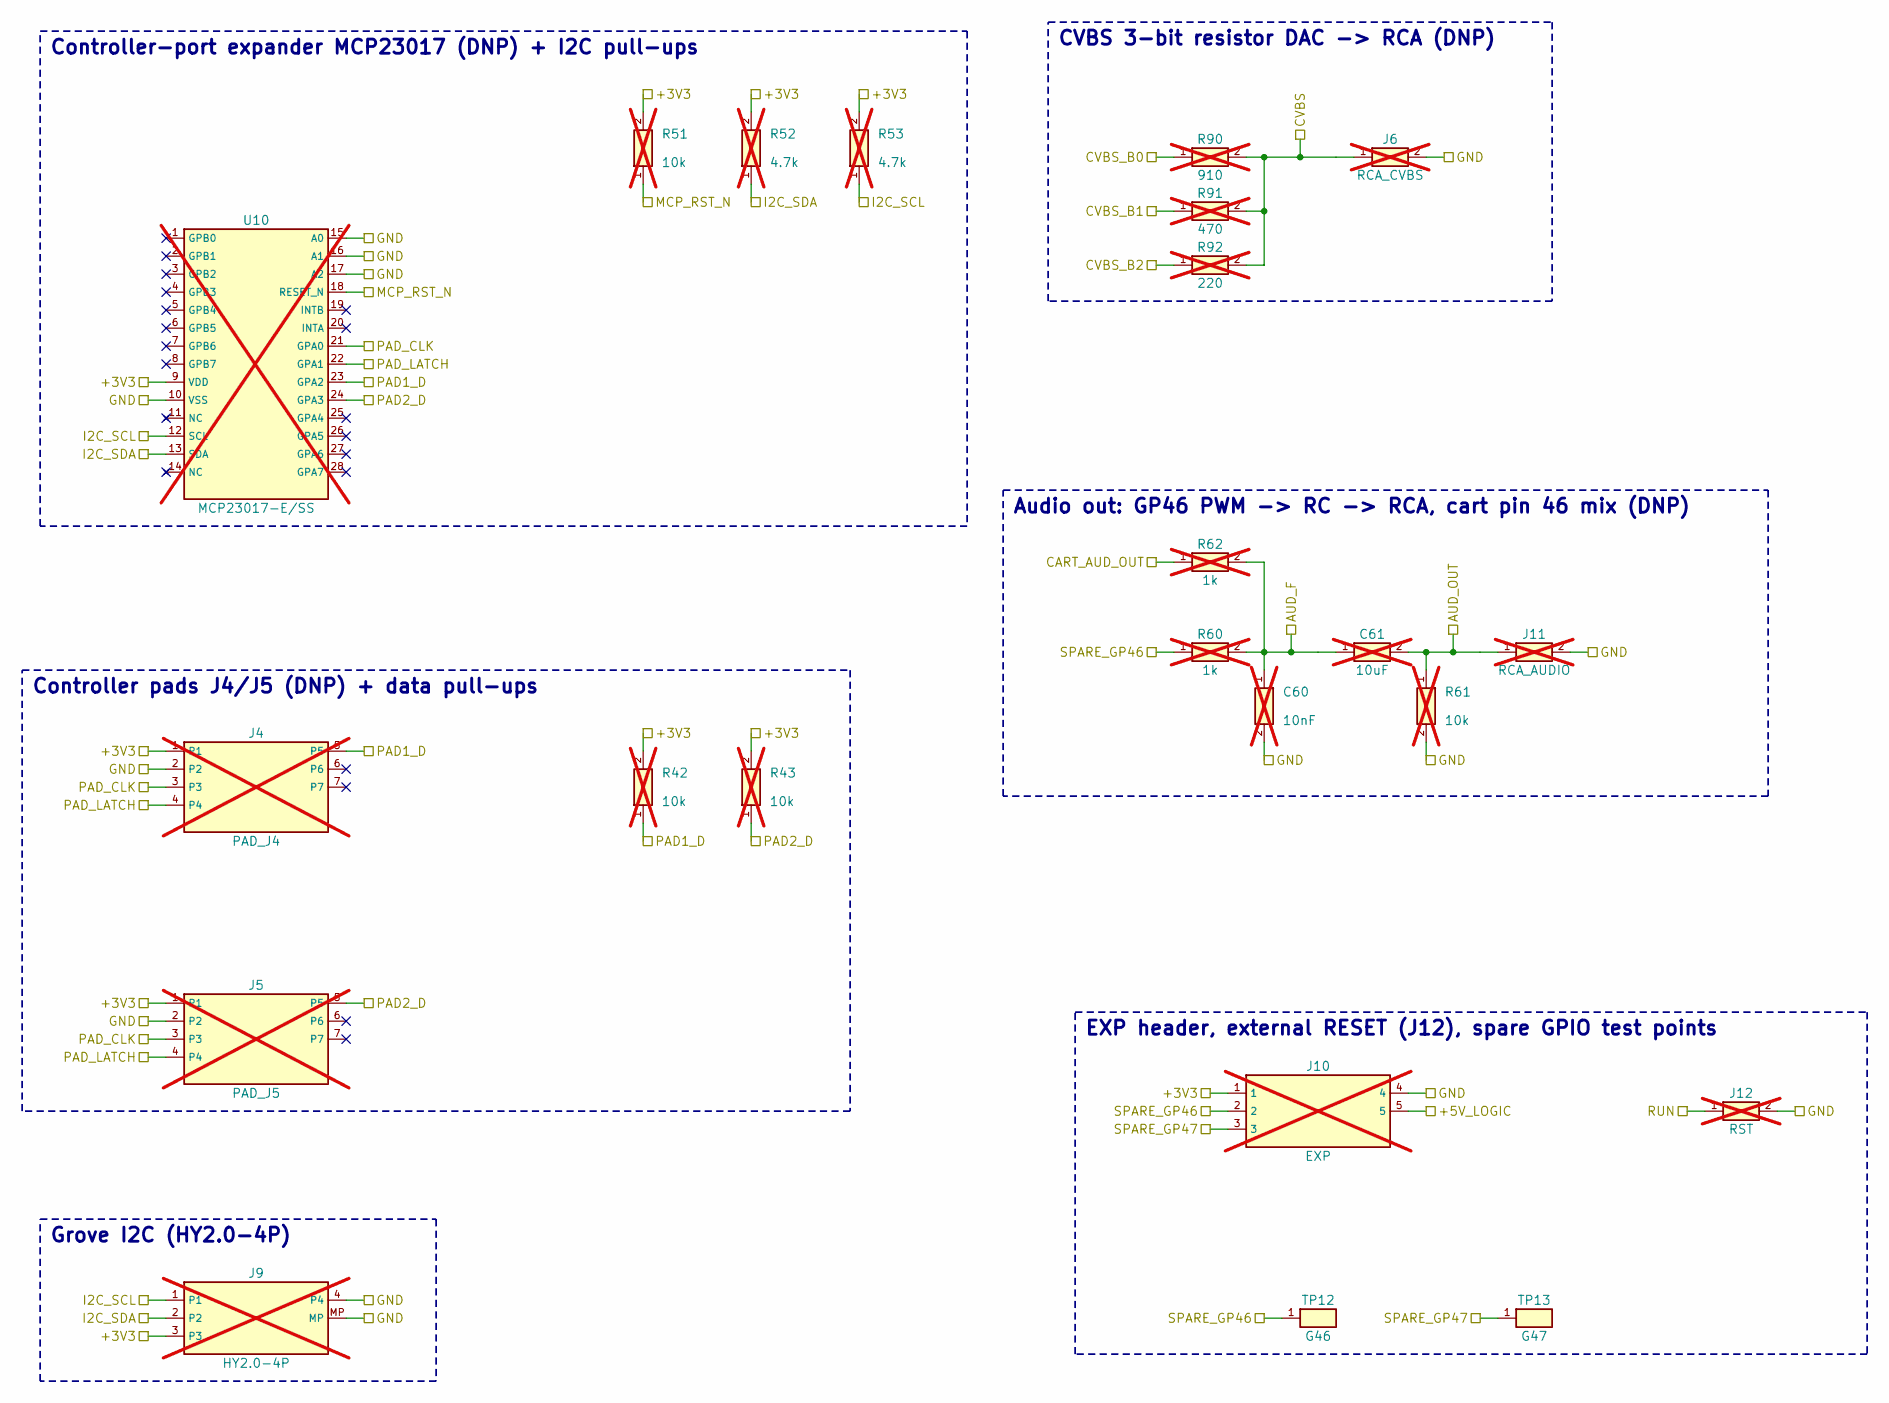
[picture p16: schematic LASAGNA2354_Lite_options.kicad_sch, LASAGNA LITE - Options (pads, Grove, CVBS, audio, EXP)]

Parts:
C60: 10nF; C_0603_1608Metric; MPN 10nF; LCSC C57112; not fitted
C61: 10uF; C_0805_2012Metric; MPN 10uF; LCSC C15850; not fitted
J4: PAD_J4; PinHeader_1x07_P2.54mm_Vertical; LCSC_Status hand-assembly / not PCBA; not fitted
J5: PAD_J5; PinHeader_1x07_P2.54mm_Vertical; LCSC_Status hand-assembly / not PCBA; not fitted
J6: RCA_CVBS; RCA_Avvicon_MJ-526; MPN MJ-526-Y; LCSC_Status hand-assembly / not PCBA; not fitted
J9: HY2.0-4P; JST_PH_S4B-PH-SM4-TB_1x04-1MP_P2.00mm_Horizontal; MPN HY2.0-4P-WT; LCSC C722729; not fitted
J10: EXP; PinHeader_1x05_P2.54mm_Vertical; LCSC_Status hand-assembly / not PCBA; not fitted
J11: RCA_AUDIO; RCA_Avvicon_MJ-526; MPN MJ-526-Y; LCSC_Status hand-assembly / not PCBA; not fitted
J12: RST; PinHeader_1x02_P2.54mm_Vertical; LCSC_Status hand-assembly / not PCBA; not fitted
R42, R43, R51, R61: 10k; R_0603_1608Metric; MPN 10k; LCSC C25804; not fitted
R52, R53: 4.7k; R_0603_1608Metric; MPN 4.7k; LCSC C23162; not fitted
R60, R62: 1k; R_0603_1608Metric; MPN 1k; LCSC C21190; not fitted
R90: 910; R_0603_1608Metric; MPN 910; LCSC C23264; not fitted
R91: 470; R_0603_1608Metric; MPN 470; LCSC C23179; not fitted
R92: 220; R_0603_1608Metric; MPN 220; LCSC C22962; not fitted
TP12: G46; TestPoint_THTPad_D2.0mm_Drill1.0mm; LCSC_Status no LCSC part
TP13: G47; TestPoint_THTPad_D2.0mm_Drill1.0mm; LCSC_Status no LCSC part
U10: MCP23017-E/SS; SSOP-28_5.3x10.2mm_P0.65mm; MPN MCP23017-E/SS; LCSC C506653; not fitted

Connections:
/+3V3: J4.1, J5.1, J9.3, J10.1, R42.2, R43.2, R51.2, R52.2, R53.2, U10.9 (VDD); also elsewhere on the board
/+5V_LOGIC: J10.5; also elsewhere on the board
/AUD_F: C60.1, C61.1, R60.2, R62.2
/AUD_OUT: C61.2, J11.1 (SIG), R61.1
/CART_AUD_OUT: R62.1; also elsewhere on the board
/CVBS: J6.1 (SIG), R90.2, R91.2, R92.2
/CVBS_B0: R90.1; also elsewhere on the board
/CVBS_B1: R91.1; also elsewhere on the board
/CVBS_B2: R92.1; also elsewhere on the board
/GND: C60.2, J4.2, J5.2, J6.2 (GND), J9.4, J9.MP, J10.4, J11.2 (GND), J12.2, R61.2, U10.10 (VSS), U10.15 (A0), U10.16 (A1), U10.17 (A2); also elsewhere on the board
/I2C_SCL: J9.1, R53.1, U10.12 (SCL); also elsewhere on the board
/I2C_SDA: J9.2, R52.1, U10.13 (SDA); also elsewhere on the board
/MCP_RST_N: R51.1, U10.18 (RESET_N)
/PAD1_D: J4.5, R42.1, U10.23 (GPA2)
/PAD2_D: J5.5, R43.1, U10.24 (GPA3)
/PAD_CLK: J4.3, J5.3, U10.21 (GPA0)
/PAD_LATCH: J4.4, J5.4, U10.22 (GPA1)
/RUN: J12.1; also elsewhere on the board
/SPARE_GP46: J10.2, R60.1, TP12.1; also elsewhere on the board
/SPARE_GP47: J10.3, TP13.1; also elsewhere on the board

Notes on the sheet:
Controller-port expander MCP23017 (DNP) + I2C pull-ups
Controller pads J4/J5 (DNP) + data pull-ups
Grove I2C (HY2.0-4P)
CVBS 3-bit resistor DAC -> RCA (DNP)
Audio out: GP46 PWM -> RC -> RCA, cart pin 46 mix (DNP)
EXP header, external RESET (J12), spare GPIO test points

Board: 2 copper layers, 78 parts (22 on the bottom side), 130 nets, no tracks yet.
