spaghetti-computer/lasagna/(commit log)

2026-11-04 Add Rev.B board design, generators, and fab outputs
    [NESPICO_RevB-B_Courtyard.gbr, NESPICO_RevB-B_Cu.gbl, NESPICO_RevB-B_Fab.gbr, NESPICO_RevB-B_Mask.gbs, NESPICO_RevB-B_Paste.gbp, NESPICO_RevB-B_Silkscreen.gbo, NESPICO_RevB-Edge_Cuts.gm1, NESPICO_RevB-F_Courtyard.gbr]
2026-11-04 Add LASAGNA Rev.C design, footprints, generators, and fab outputs
    [LASAGNA2354_RevC-B_Cu.gbl, LASAGNA2354_RevC-B_Mask.gbs, LASAGNA2354_RevC-B_Paste.gbp, LASAGNA2354_RevC-B_Silkscreen.gbo, LASAGNA2354_RevC-Edge_Cuts.gm1, LASAGNA2354_RevC-F_Cu.gtl, LASAGNA2354_RevC-F_Mask.gts, LASAGNA2354_RevC-F_Paste.gtp]
2026-11-04 Add LASAGNA LITE design and fab outputs
    [LASAGNA2354_Lite-B_Courtyard.gbr, LASAGNA2354_Lite-B_Cu.gbl, LASAGNA2354_Lite-B_Fab.gbr, LASAGNA2354_Lite-B_Mask.gbs, LASAGNA2354_Lite-B_Paste.gbp, LASAGNA2354_Lite-B_Silkscreen.gbo, LASAGNA2354_Lite-Edge_Cuts.gm1, LASAGNA2354_Lite-F_Courtyard.gbr]
